bgreig/TinkerSub/Source/README.md

# TinkerSub KB-1: source

Everything generated in this repository comes from the Python in this folder: the printed parts (`STL/`), the Bambu Studio projects (`*.3mf`), the side-plate templates and DXFs (`CAD/`), the STEP files, the pictures and the build guide. The CAD is code: change a number, rebuild, and every file downstream follows.

You don't need any of this to build the ROV. You need it to change the design.

## Quick start

```
pip install -r Source/requirements.txt
playwright install chromium            # for the renders and schematics
python3 Source/build.py all            # about 10 minutes; add --step for the STEP files (slow)
python3 Source/build.py install        # copy what changed into the repository
```

`all` ends with a check that compares every generated file with the one in the repository and lists what changed. Nothing in the repository is touched until you run `install`, and `install` only writes files that really changed (a 3MF whose only difference is its object IDs and date is left alone). Everything is built in `Source/build/` (git-ignored).

Tested with Python 3.13 on Linux.

## The build steps

`python3 Source/build.py <step> [<step> ...]` runs one or more steps; `all` runs them in this order. Each step uses what the steps before it wrote in the build folder.

| Step | What it does | Main output |
|---|---|---|
| `parts` | Generates every printed part, assembles the whole ROV (and reports any interference between parts), names, numbers and labels the parts, then runs the fastener check | `out_lbl/<PN>_<name>.stl`: the files in `STL/` |
| `fasteners` | Follows every screw hole in the assembled ROV through every part and checks it against `assembly/fasteners.py` (below). Any error stops the build | `fastener_report.json`, `logs/fastener_check.log` |
| `plates` | HDPE side plates: DXFs, cutting templates, one-piece plate STLs | `out_final/`: the files in `CAD/` |
| `3mf` | Bambu Studio projects (Frame, Core, Reprint) and their plate maps | `outdir/` |
| `step` | STEP files for Fusion 360 and other CAD apps, and the positioned mesh assembly. Slow (the assembly is 146 MB): not part of `all` unless you add `--step` | `out_final/step/` |
| `figures` | Drawn figures: thruster layout, pan-tilt fit diagram, side-plate figures, the compensator section, the two schematic sheets, the wiring diagram and the wire list | `render/final/crop/`, `out/compensator_section.png` |
| `scenes` | 3D scenes for the renders: the assembly, the lights, the electronics sled, the heat-set insert map, single parts; and the interactive viewer's data (`guide/viewer_scene.py`: every part, the electronics and the cables) | `render/*.json`, `render/viewer/` |
| `renders` | Renders every view in `render/views/*.json` in headless Chromium | `render/final/crop/` |
| `guide` | Builds the guide PDF and the whole generated package | `outdir/TinkerSub_KB-1_Build_Package/` |
| `check` | Compares the package with the repository, file by file | a list: same / equivalent / changed / new |
| `install` | Copies changed and new files into the repository. Never deletes | |

The guide uses about 120 pictures. About 60 of them are regenerated by `figures` and `renders`. The rest are older renders whose camera setups no longer exist (most of the part thumbnails, the thruster, sled and pod pictures, the label close-ups in `Images/Labels/`). The `guide` step takes every picture it didn't regenerate from the repository's `Images/` folder, so you can rebuild the guide after a text change with:

```
python3 Source/build.py parts plates guide check
```

## Folders

| Folder | What's in it |
|---|---|
| `build.py` | The one entry point. Its docstring lists every step. |
| `geometry/` | The parts themselves. `thruster.py` (housing, duct, props, tail cone), `pylon.py`, `lights.py`, `rov_parts.py` (pod flanges and caps, sled bulkhead), `jbox.py` (junction box and lid), `pantilt_fit.py` (camera pan-tilt and its fit check), `rov_v5.py` (stations, brackets, belly pan, cowl, side plates, light aim). `frame_clamp.py`, `pvc.py`, `ring.py`, `bracket.py`, `mount.py` and `wiring.py` are earlier versions the current parts still build on. `rail_notch.py` cut the wire opening in the sled rails once; its output is in `inputs/`. |
| `assembly/` | `rov_v6.py` puts every part in place and checks for interference. `export_v4/5/6.py` write the parts in print orientation. `parts_final.py` is the master part list: part numbers, file names, print notes, labels. `fasteners.py` is every screw joint; `purchases.py` is everything to buy (fasteners counted from `fasteners.py`). `label_parts.py` + `engrave.py` deboss the part numbers. |
| `outputs/` | `make_3mf.py` (Bambu projects; plate layouts in `plates_*.json`, print profile in `ps.json`), `plate_preview.py` (plate maps), `plate_templates_final.py` and `plate_stl_final.py` (side plates), `make_step.py` + `step_export.py` (STEP), `viewer_and_mesh.py` (mesh assembly). |
| `checks/` | `fastener_check.py` (with `holes.py`) checks every screw joint, run by the build. `print_review.py` checks every printed part for bed fit, loose columns, floating islands, overhangs and thin walls. `insert_walls.py` checks the plastic round every heat-set insert hole. |
| `guide/` | The guide (`build_guide.py` styles and helpers, `build_guide_final.py` all the text) and everything that makes its pictures: `scene_final.py`, `light_scene.py`, `elec_scene.py`, `part_scenes.py`, `insert_map.py` (scenes), `pantilt_fig.py`, `plate_figs.py`, `comp_fig.py`, `elec_drawings.py` (figures). `package_images.py` says where each picture lives in the package. |
| `render/` | `viewer.html` is the interactive 3D viewer (spin, explode, show/hide, click a part): serve it next to `build/render/viewer/*.json`. The renderer: `render.html` (parts and assembly), `render_ikea.html` (picture-by-picture pages), `render_real.html` (electronics), three.js, and the drivers `shoot.py` / `shoot_real.py`. `views/` holds the camera shots, one JSON file per kind of picture. |
| `inputs/` | Parts drawn in CAD rather than generated, read in as they are (below). |

## Inputs

| Folder | Contents |
|---|---|
| `inputs/rov_project/` | Hull flanges 201 / 203, dome ring 204 and the original rear end cap (STL + STEP, from `rov_br_style_caps.py`), the sled front bulkhead 207 (`camera_mount/`), and the reference parts the assembly loads |
| `inputs/New_parts/` | Sled rails, deck, rear bulkhead and battery plate (212-215, 305), drawn as CAD solids in the sled frame |
| `inputs/src_parts/` | Sled rails with the front wire opening cut, as used in the assembly |
| `inputs/prep/` | The same parts in print orientation with their labels engraved, plus the pan-tilt parts |
| `inputs/step_supplied/` | True CAD solids for 214, 215, 305 and 306, shipped as STEP files as drawn (the other parts' STEP files are converted from their meshes) |

## Where to change things

| To change | Edit |
|---|---|
| Stations, brackets, belly pan, cowl, side plates, light aim | `geometry/rov_v5.py` |
| Thruster body, duct, prop, tail cone | `geometry/thruster.py` |
| Pylon clamp | `geometry/pylon.py` |
| Light heads | `geometry/lights.py` |
| Pod flanges and caps | `geometry/rov_parts.py` |
| Camera pan-tilt | `geometry/pantilt_fit.py` (its `check()` sweeps the camera through its whole range inside the dome) |
| Junction box and lid | `geometry/jbox.py` |
| Part numbers, print notes, labels | `assembly/parts_final.py` |
| Any screw: size, length, how many | `assembly/fasteners.py` (the shopping list counts its screws from here) |
| Plate layouts in the 3MFs | `outputs/plates_*.json`; print settings in `outputs/make_3mf.py` |
| Guide text | `guide/build_guide_final.py` |
| Anything bought: size, quantity, price, source (the guide's shopping list, `Parts_to_buy.csv`) | `assembly/purchases.py` |
| A picture's camera angle | `render/views/*.json` |

## The fastener check

Every round hole of screw size in every printed part is placed in the assembled ROV and followed along its axis through every part on that line. For each joint it works out where the head goes, where the thread is, the grip, and the screw lengths that would hold without bottoming out, and checks there is room for the head, the nut and a hex key. Then it compares the model with `assembly/fasteners.py`, the table of every screw in the ROV:

- **BLIND / COVERED**: a screw can't get in (a clearance hole that stops in plastic, an insert that opens against another part). This is the 2026-10-22 belly pan bug.
- **UNMATED**: a hole that lines up with nothing. This is how a misaligned hole shows up (the top-arm inserts were 0.75 mm off the plate holes). Holes for bought parts that aren't in the model are listed in `NOT_JOINTS` with the reason.
- **LENGTH / ROOM**: the screw in the table is too short, too long, or its head or nut doesn't fit.
- **UNDECLARED / COUNT**: a joint the table doesn't know, or a different number of them.
- **GUIDE TEXT**: the guide names a screw size the table doesn't have. (The shopping list counts its screws, nuts and inserts from this table, so it can't disagree.)

To change a screw, change `assembly/fasteners.py` and rebuild: the report gives the lengths that fit each joint.

## Running one script on its own

The scripts import each other by name, so put the code folders on the path and run from the build folder, for example:

```
cd Source/build
PYTHONPATH=../geometry:../assembly:../outputs:../checks:../guide python3 ../checks/print_review.py out_lbl report.json
```

## License

MIT (see `LICENSE`). The parts these scripts make are covered by the hardware license, CERN-OHL-S-2.0, at the top of the repository.
