bgreig/TinkerSub/CAD/rov_side_plate_templates_fullsize_24x18.pdf

TinkerSub KB-1 side plate 901 PORT - full size, seen from OUTSIDE, front of the ROV to the left

Print on 24 x 18 in (ARCH C) paper at 100 % / Actual size, no scaling. Check both bars below before you cut: 200 mm and 8 in exactly.
Plate 478 x 300 mm, 1/2 in HDPE. Holes: 3.5 mm = M3, 4.5 mm = M4, 5.5 mm = M5. Centre-punch every crosshair; drill the blue starter holes before cutting the windows.

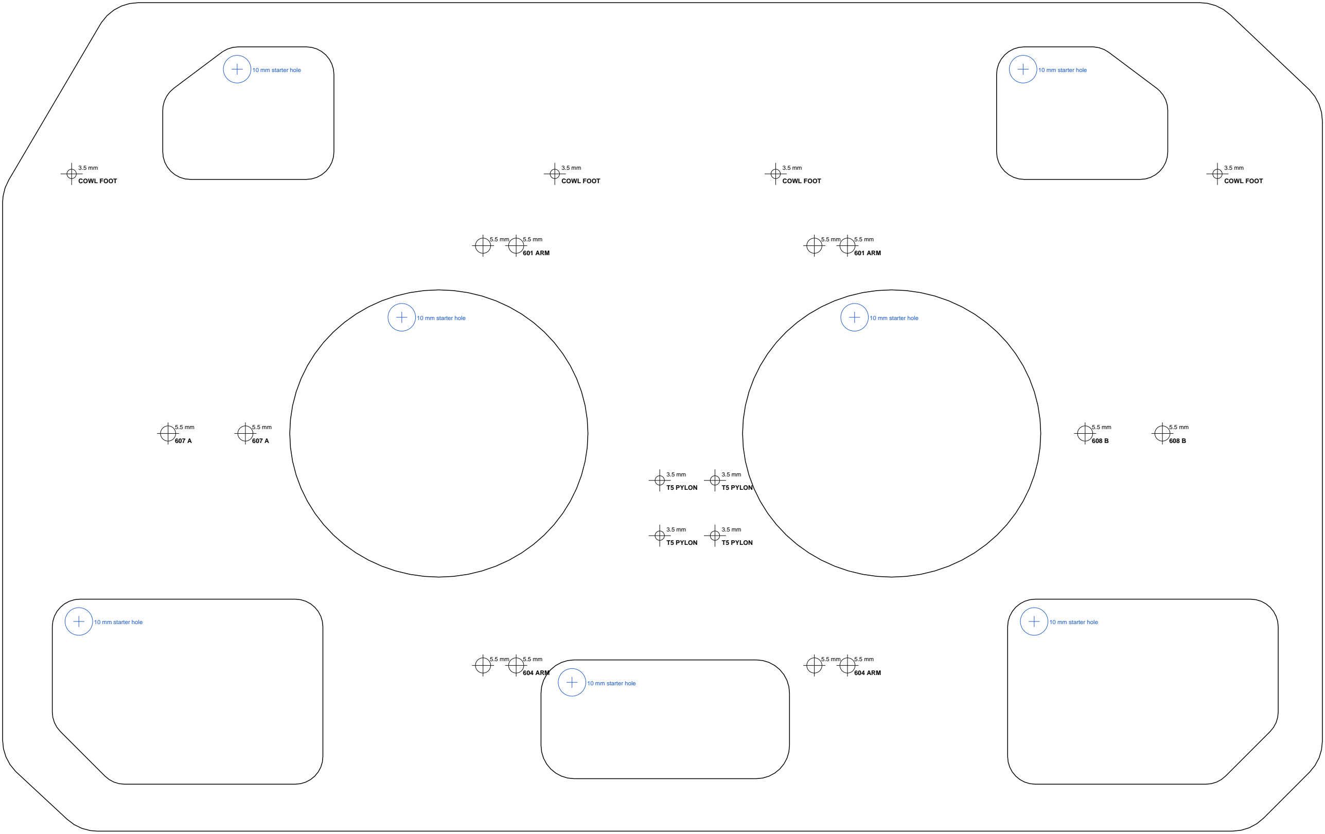
[picture p20: figure]
601 ARM; 604 ARM; T5 PYLON; COWL FOOT; 10 mm starter hole

200 mm

8 in

TinkerSub KB-1 side plate 902 STARBOARD - full size, seen from OUTSIDE, front of the ROV to the right

Print on 24 x 18 in (ARCH C) paper at 100 % / Actual size, no scaling. Check both bars below before you cut: 200 mm and 8 in exactly.
Plate 478 x 300 mm, 1/2 in HDPE. Holes: 3.5 mm = M3, 4.5 mm = M4, 5.5 mm = M5. Centre-punch every crosshair; drill the blue starter holes before cutting the windows.

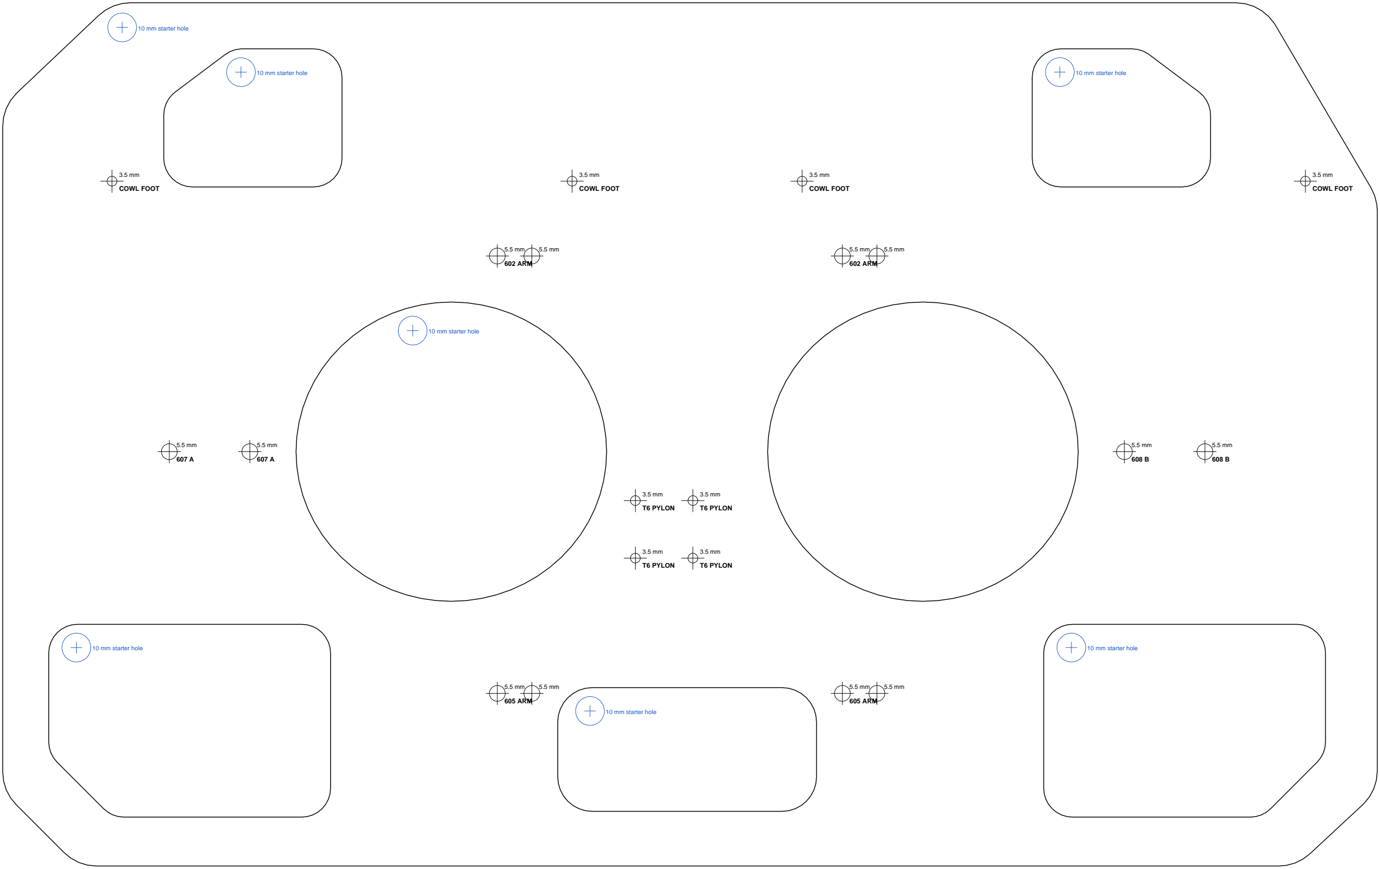
[picture p21: figure]
602 ARM; 605 ARM; T6 PYLON; COWL FOOT; 10 mm starter hole

200 mm

8 in
