bgreig/TinkerSub/CAD/rov_side_plates_both_24x36.pdf

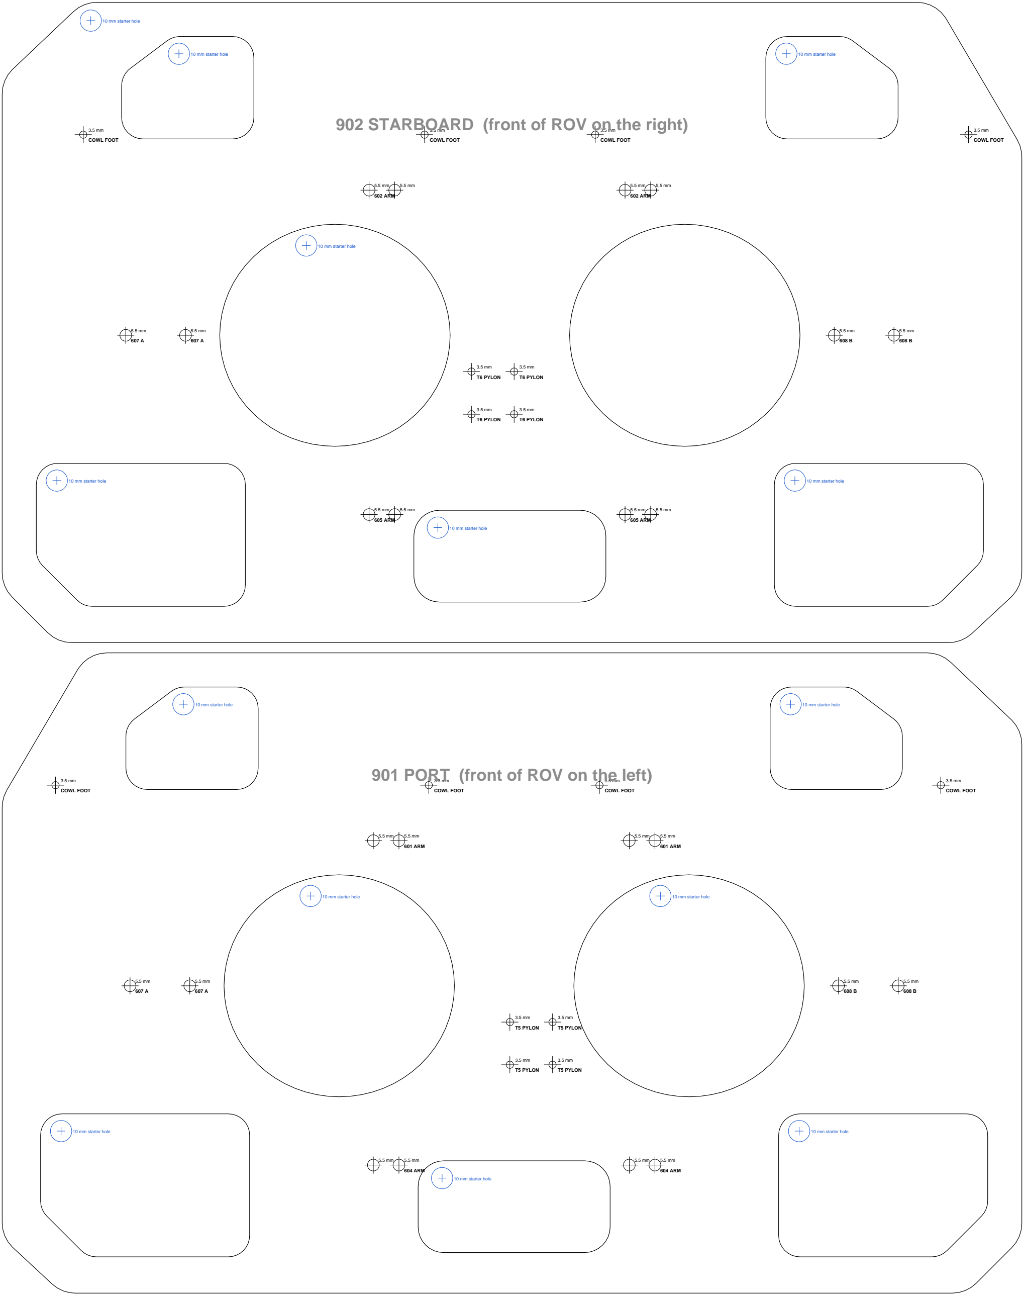
[picture p35: figure]
601 ARM; 604 ARM; T5 PYLON; COWL FOOT; 10 mm starter hole; 901 PORT (front of ROV on the left); 602 ARM; 605 ARM; T6 PYLON

# 902 STARBOARD (front of ROV on the right)

TinkerSub KB-1 side plates 901 + 902: full-size cutting template, both plates, 1/2 in HDPE

Print on 24 x 36 in (ARCH D) paper or a 24 in roll at 100 % / Actual size: no scaling, no 'fit to page'.
Before cutting anything, check both bars at the bottom: exactly 200 mm and exactly 8 in. Each plate outline must measure 478 x 300 mm.
Both plates are drawn outside face up, 4.8 mm apart, exactly as they sit on one 24 x 24 in HDPE sheet: trim the paper to about 2 mm
outside the two plates and glue the whole thing on (3M Super 77 or glue stick), plates centred left to right, ~2 mm from the top and bottom edges. Centre-punch every crosshair. Drill 3.5 mm (M3), 4.5 mm (M4), 5.5 mm (M5) as printed. Drill each blue 10 mm starter hole, then jigsaw the windows and outlines just outside the line, slow speed, fine blade. Mark 901 / 902 and the hole tags on the outside faces before peeling the paper off.

200 mm

8 in
