bgreig/TinkerSub/Images/Diagrams/compensator_section.png

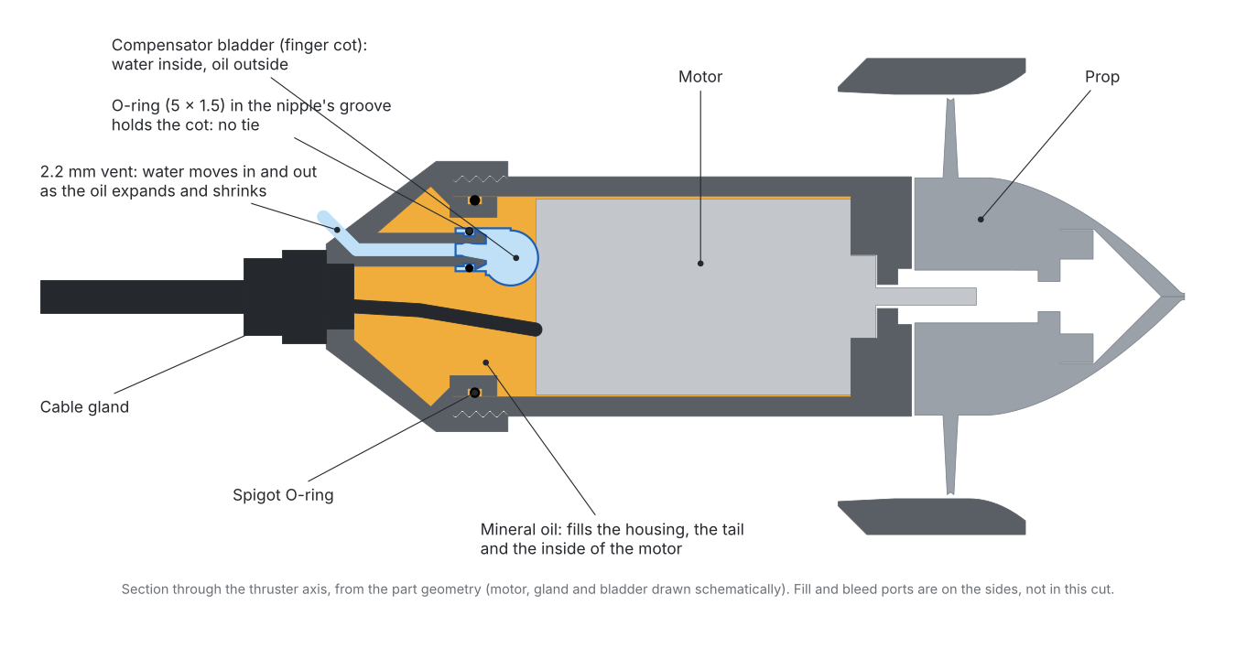
Images/Diagrams/compensator_section.png
