bgreig/TinkerSub/Images/Diagrams/prop_hex_section.png

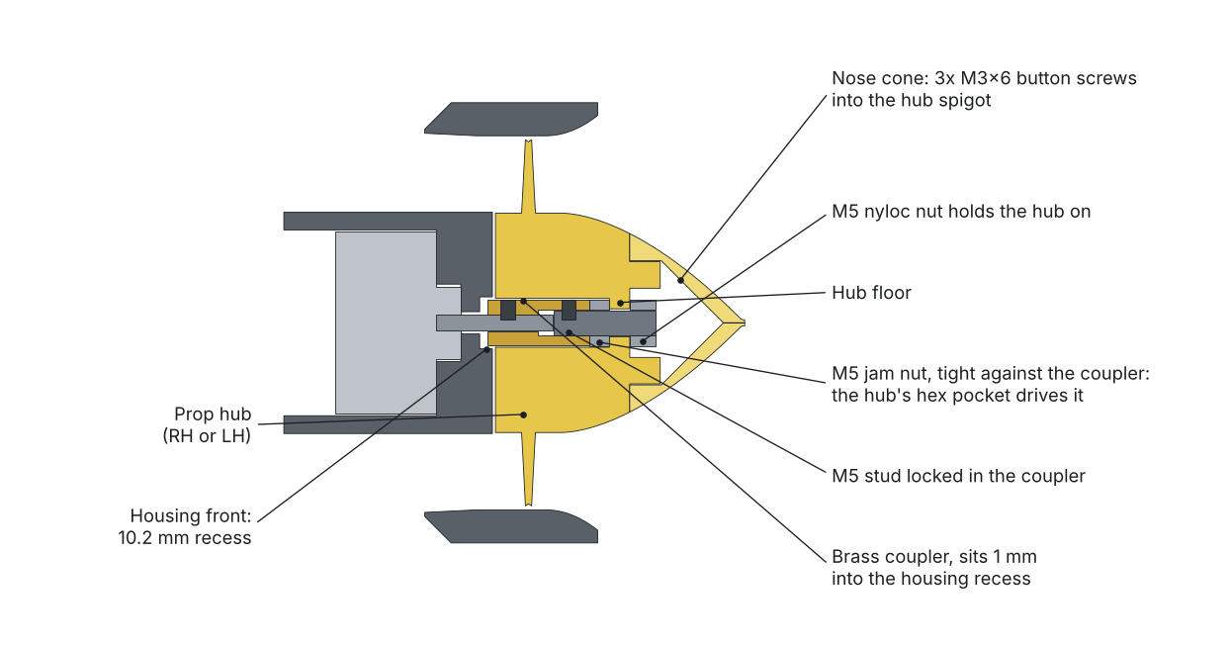
Images/Diagrams/prop_hex_section.png
