bgreig/TinkerSub/Images/Diagrams/side_plates_on_24x24_sheet.png

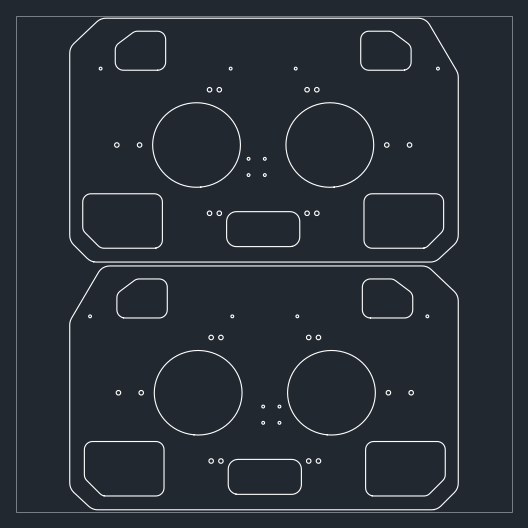
Images/Diagrams/side_plates_on_24x24_sheet.png
