bgreig/TinkerSub/Images/Diagrams/thruster_layout.png

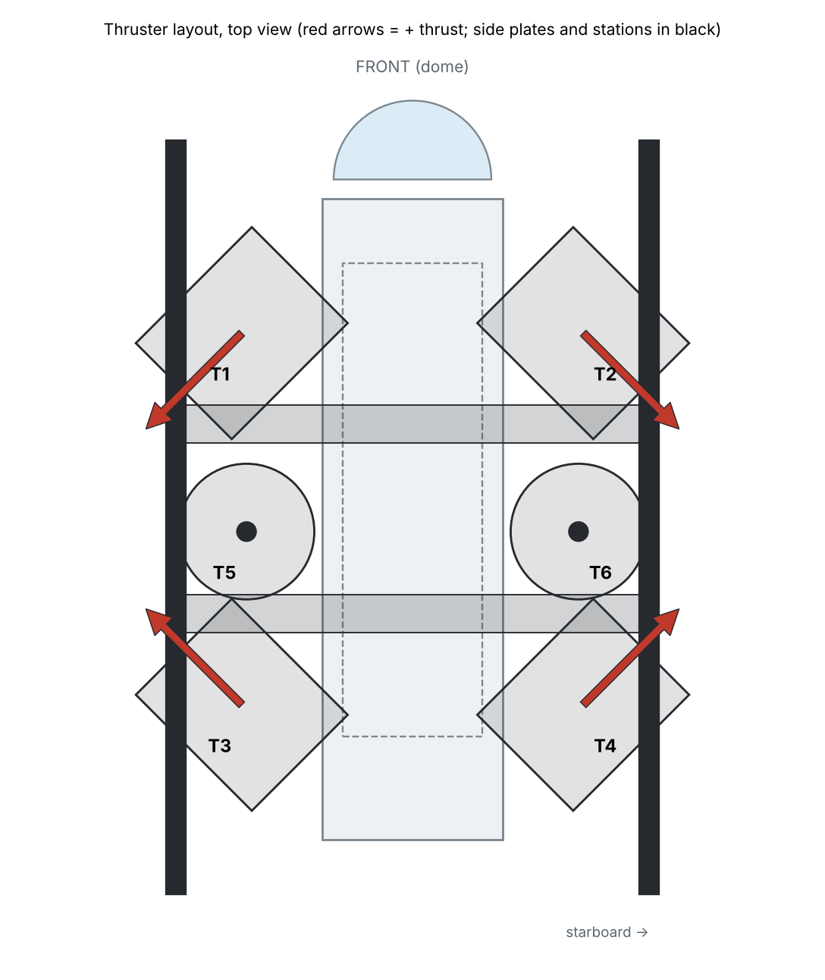
Images/Diagrams/thruster_layout.png
