bgreig/TinkerSub/Images/Diagrams/TinkerSub_KB-1_Core_plates.png

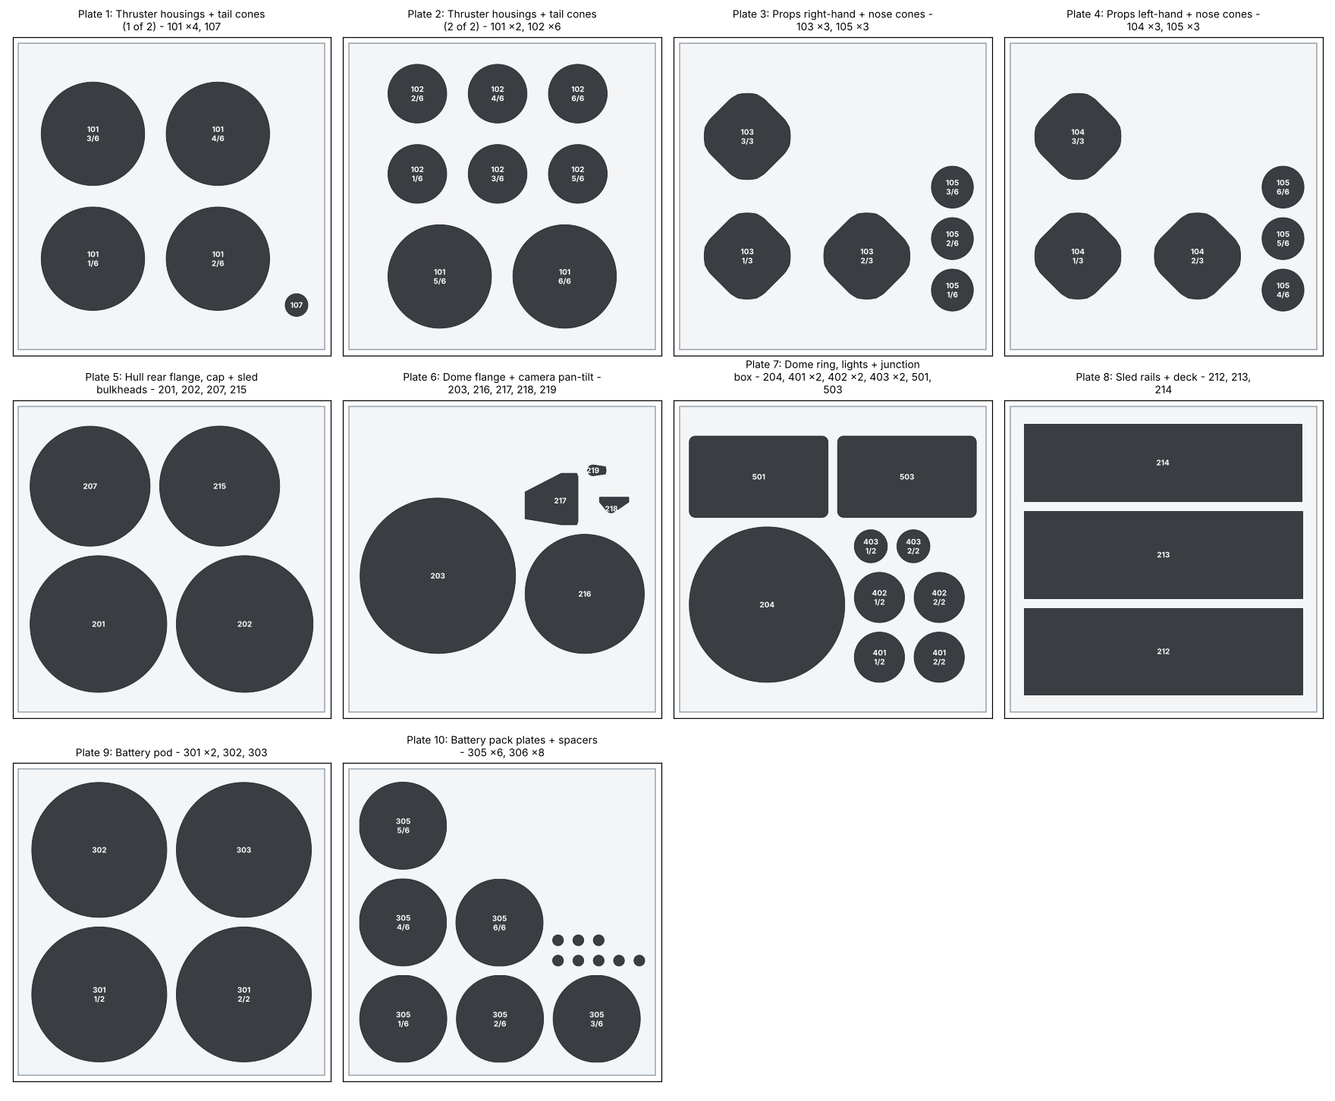
Images/Diagrams/TinkerSub_KB-1_Core_plates.png
