bgreig/TinkerSub/Images/Diagrams/TinkerSub_KB-1_Frame_plates.png

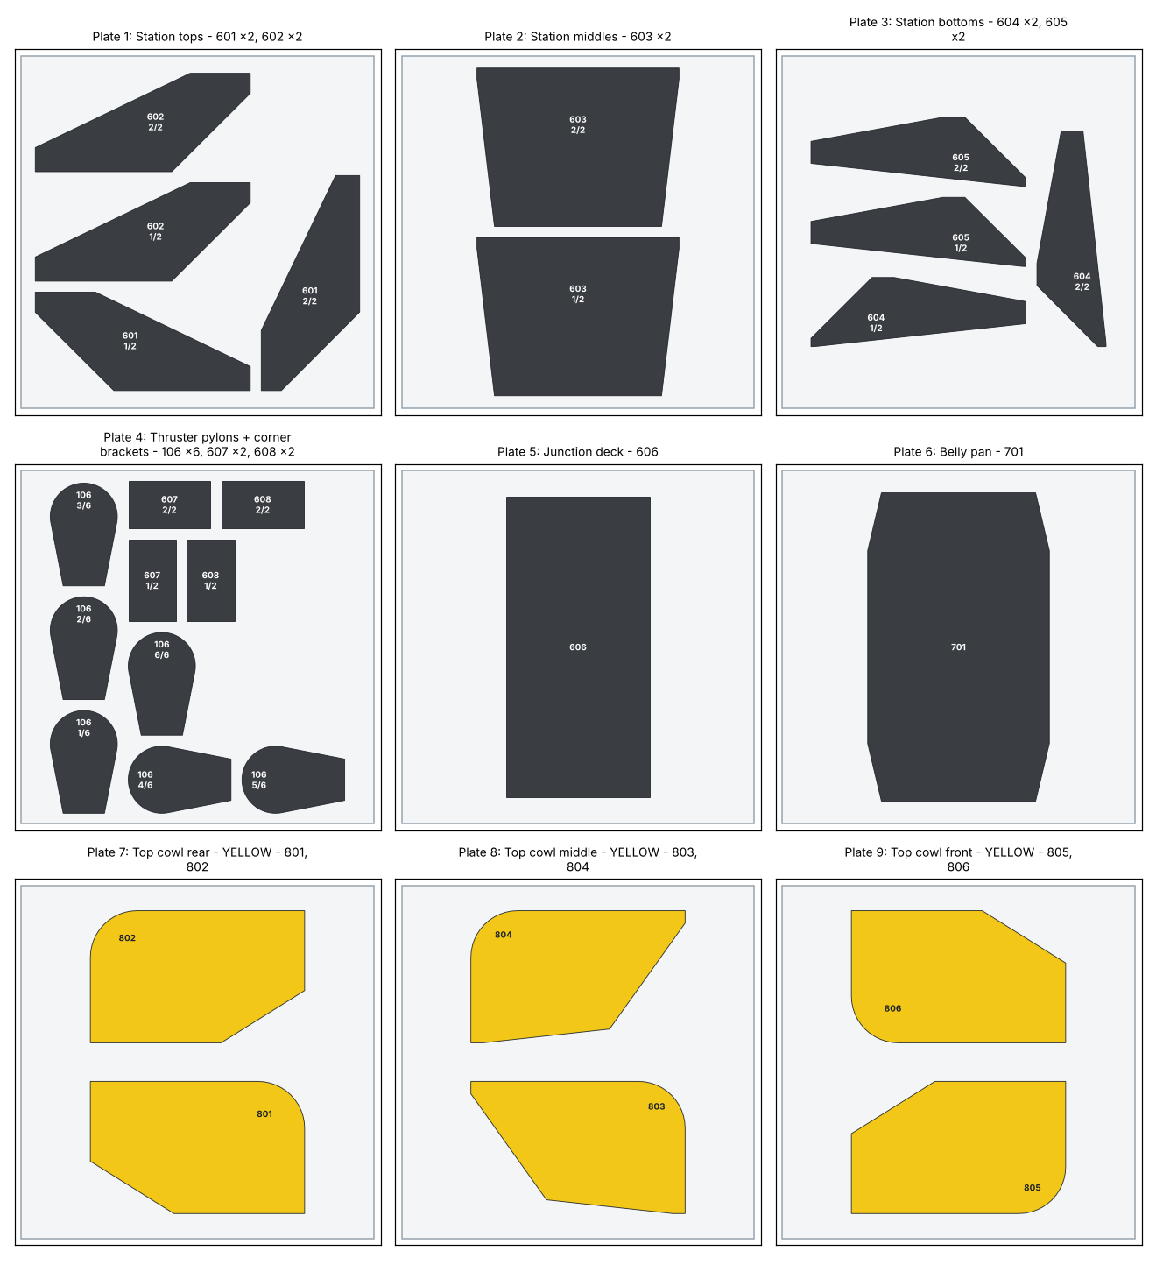
Images/Diagrams/TinkerSub_KB-1_Frame_plates.png
