bgreig/TinkerSub/Images/Electronics/harness_port.png

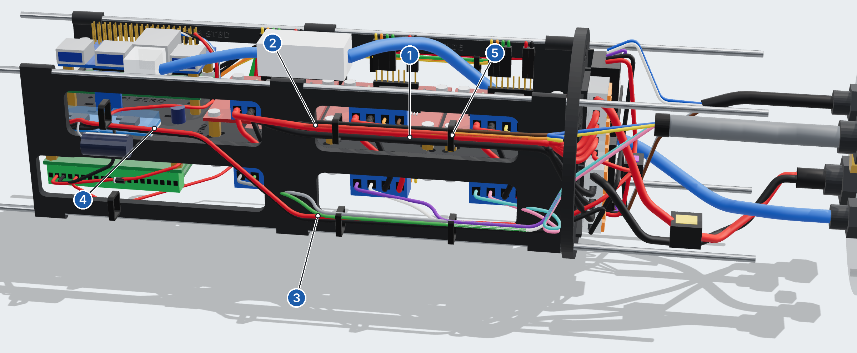
Images/Electronics/harness_port.png
