bgreig/TinkerSub/Images/Electronics/harness_starboard.png

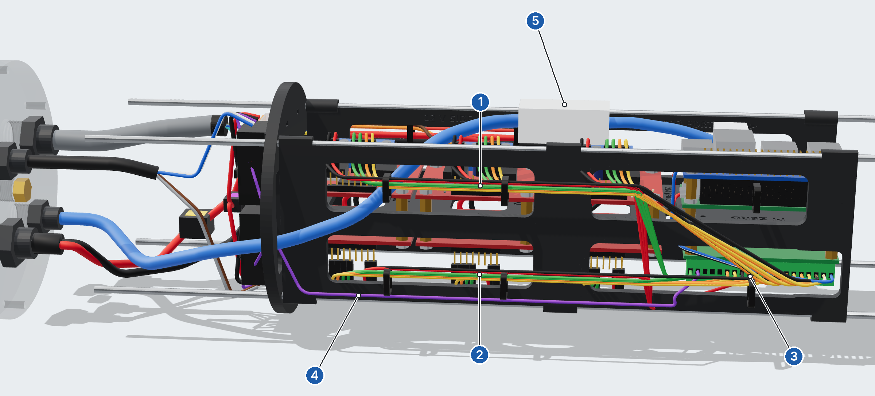
Images/Electronics/harness_starboard.png
