bgreig/TinkerSub/Images/Electronics/pin_map_pi_zero.png

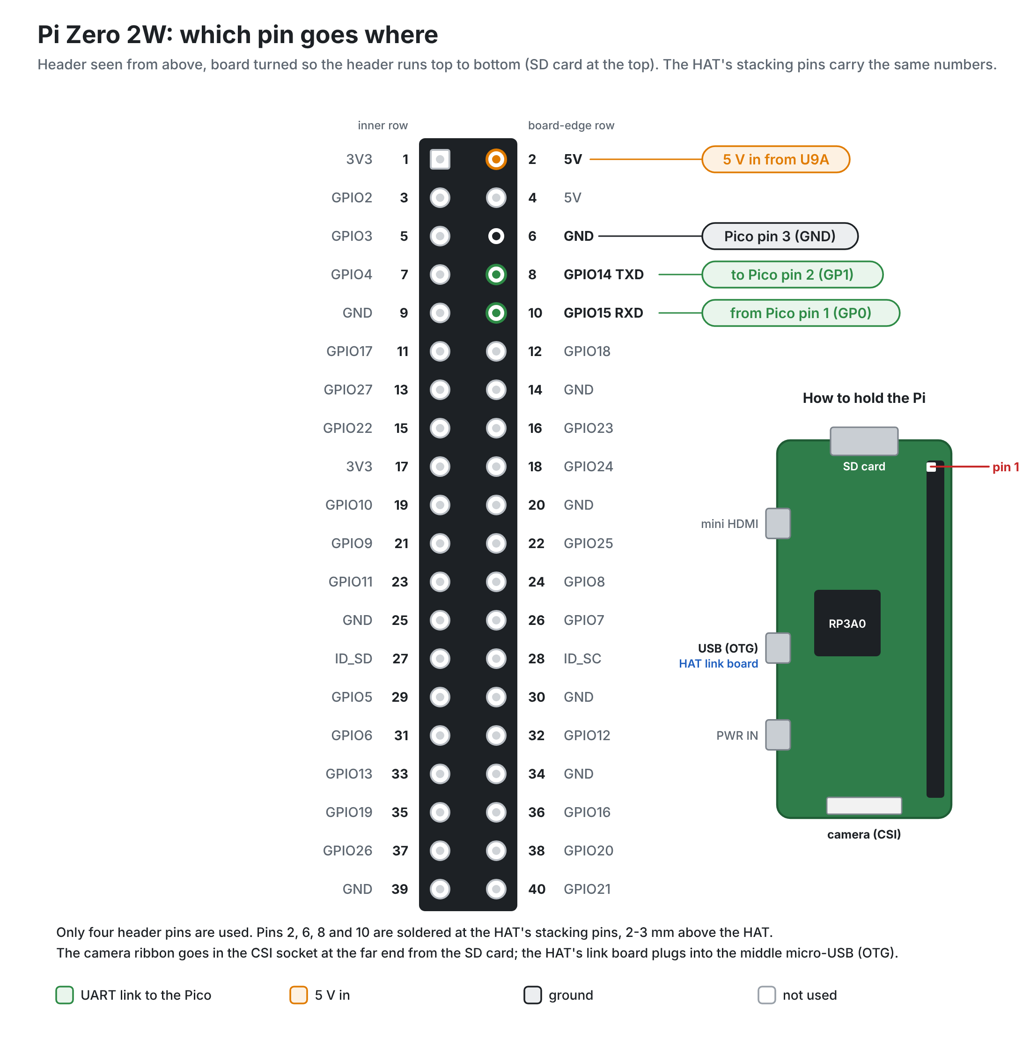
Images/Electronics/pin_map_pi_zero.png
