bgreig/TinkerSub/Images/Electronics/pin_map_pico.png

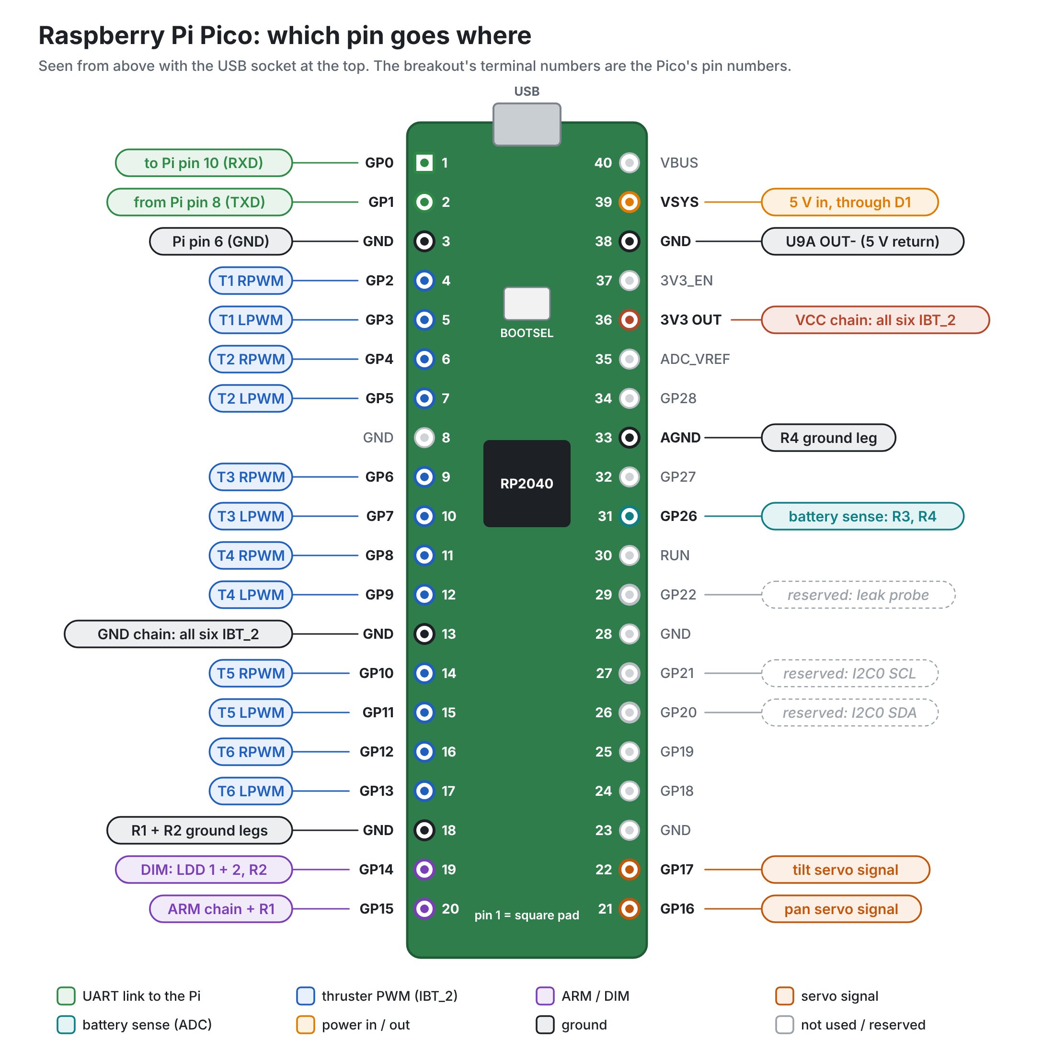
Images/Electronics/pin_map_pico.png
