bgreig/TinkerSub/Images/Electronics/rear_bay.png

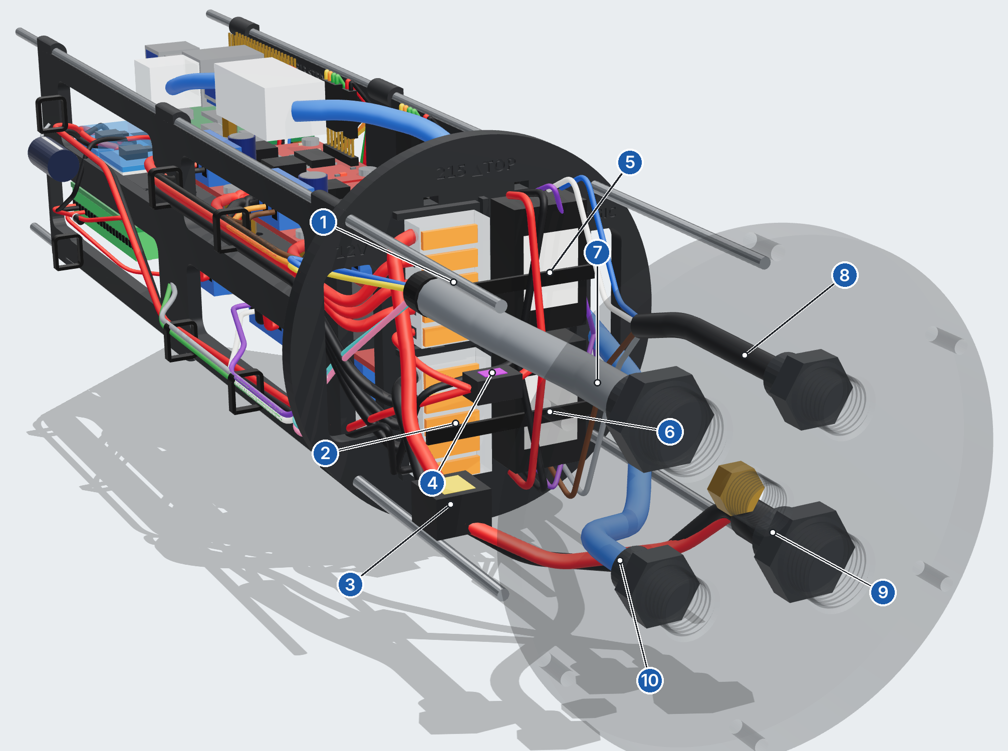
Images/Electronics/rear_bay.png
