bgreig/TinkerSub/Images/Electronics/schematic_1_power_and_drivers.png

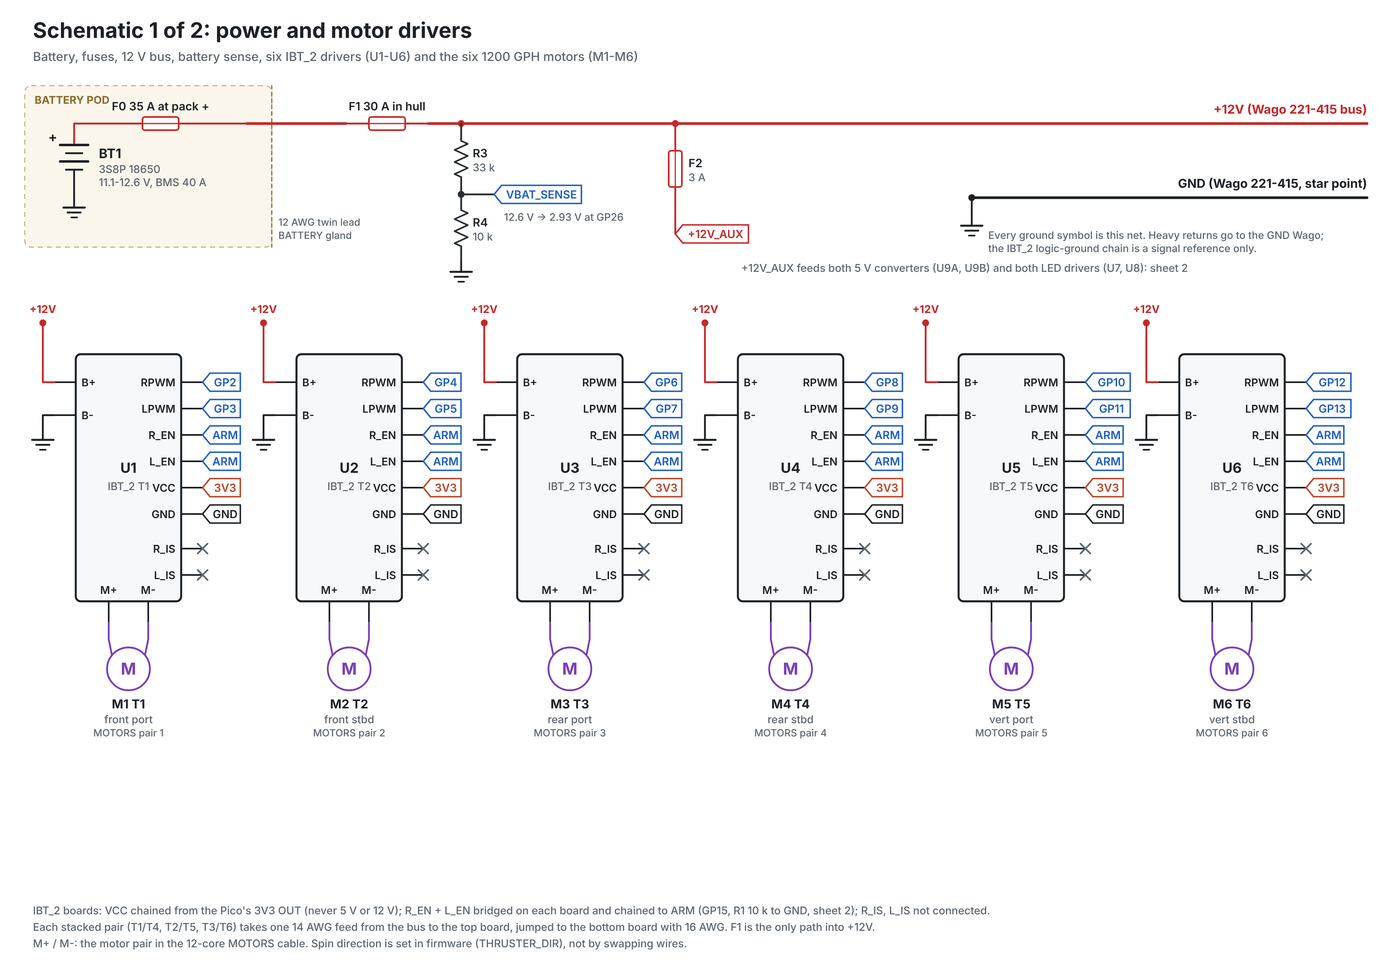
Images/Electronics/schematic_1_power_and_drivers.png
