bgreig/TinkerSub/Images/Electronics/schematic_2_control_and_lights.png

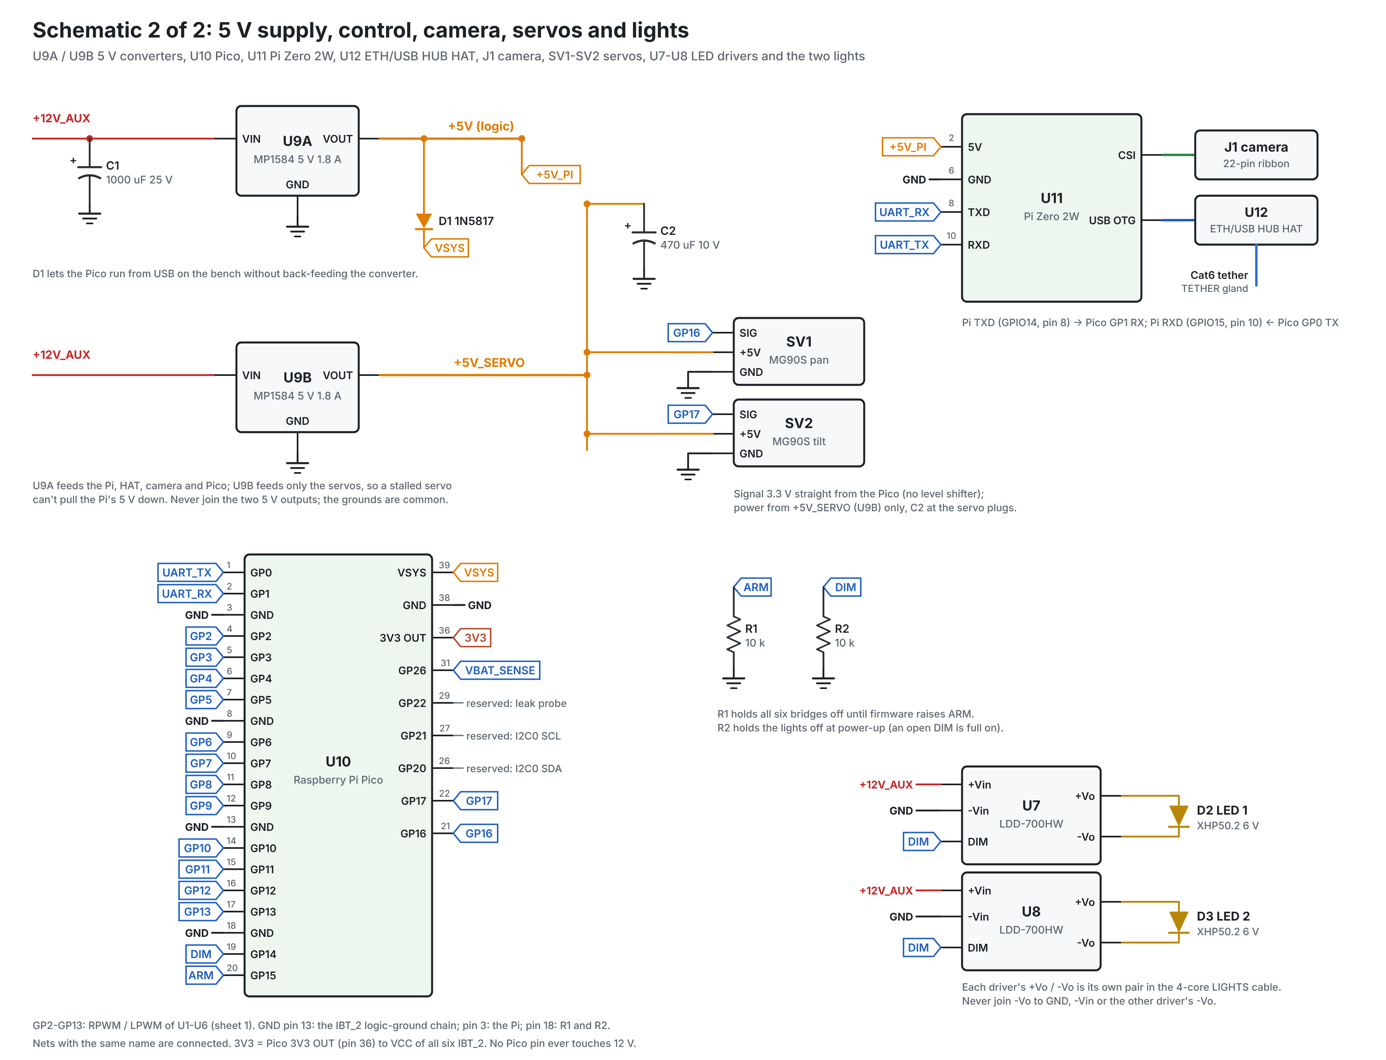
Images/Electronics/schematic_2_control_and_lights.png
