bgreig/TinkerSub/Images/Electronics/sled_bottom_face.png

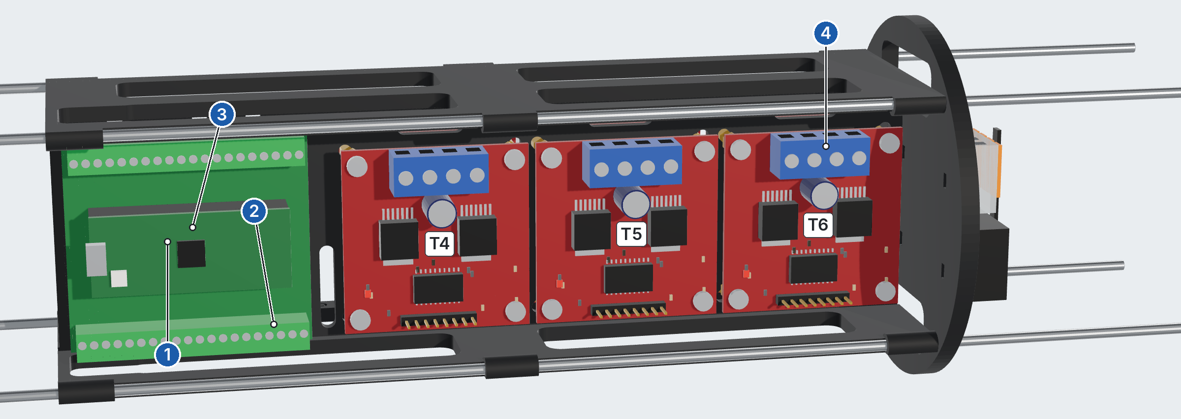
Images/Electronics/sled_bottom_face.png
