bgreig/TinkerSub/Images/Electronics/sled_in_hull.png

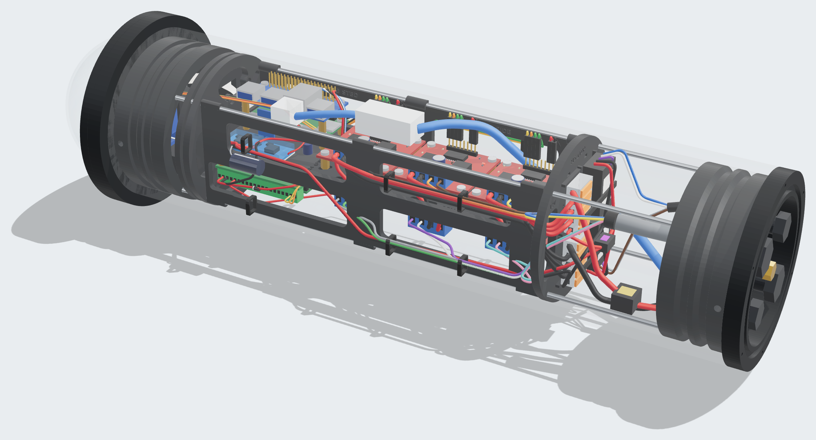
Images/Electronics/sled_in_hull.png
