bgreig/TinkerSub/Images/Electronics/sled_top_face.png

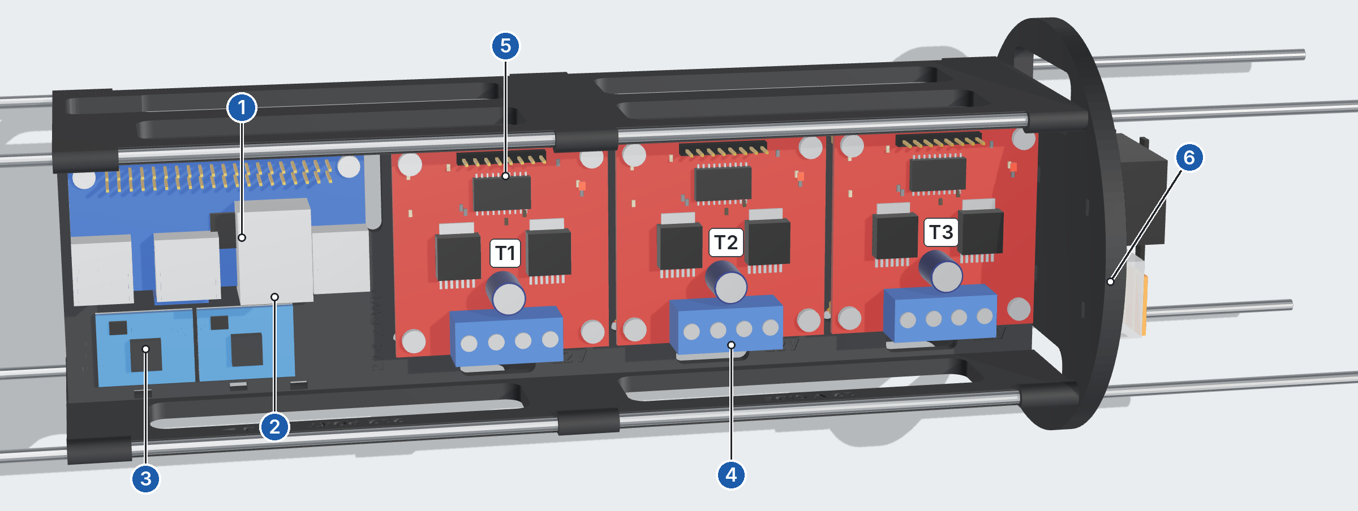
Images/Electronics/sled_top_face.png
