bgreig/TinkerSub/Images/Electronics/stacked_pair.png

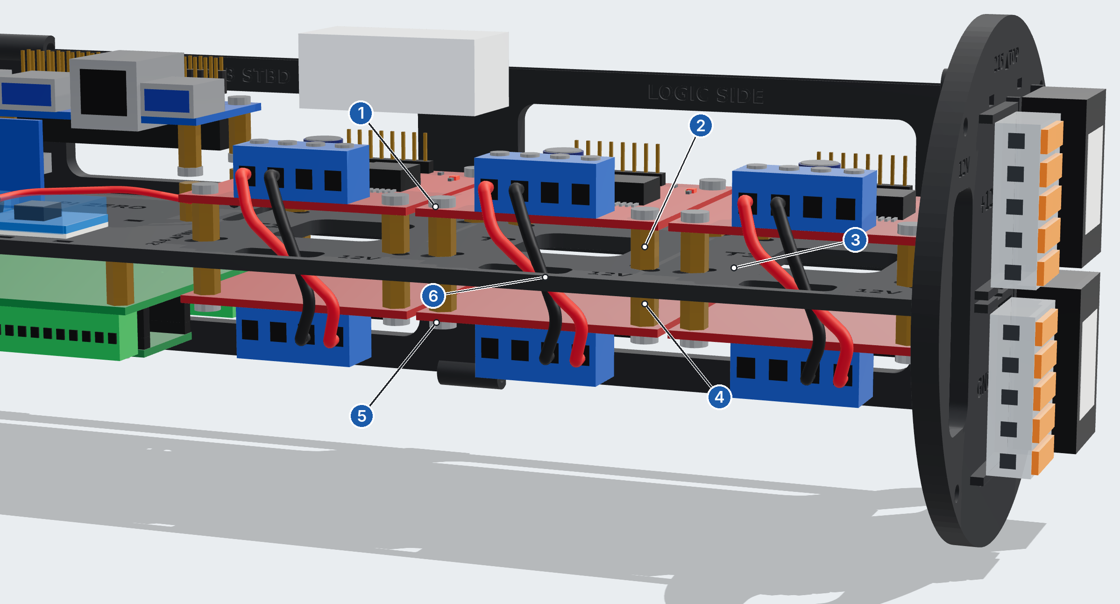
Images/Electronics/stacked_pair.png
