bgreig/TinkerSub/Images/Inserts/106.png

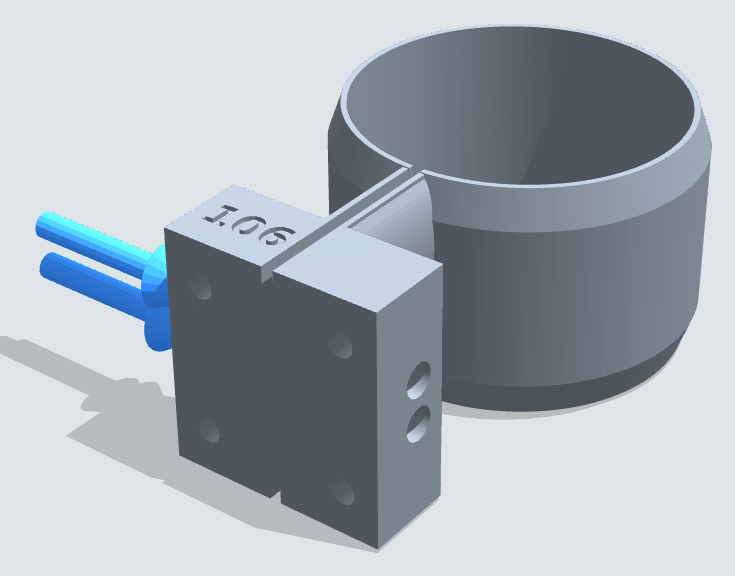
Images/Inserts/106.png
