bgreig/TinkerSub/Images/Inserts/201.png

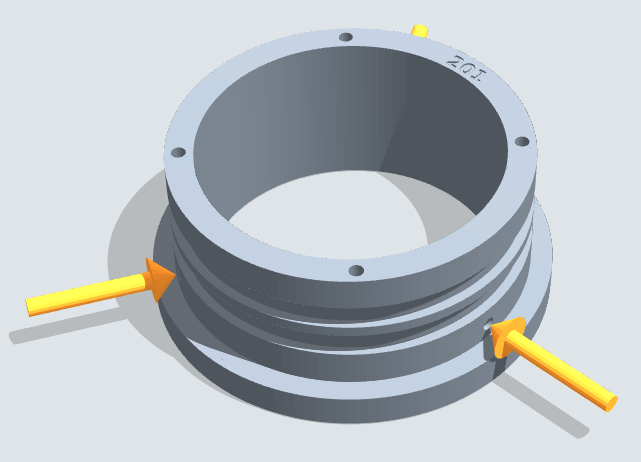
Images/Inserts/201.png
