bgreig/TinkerSub/Images/Inserts/203.png

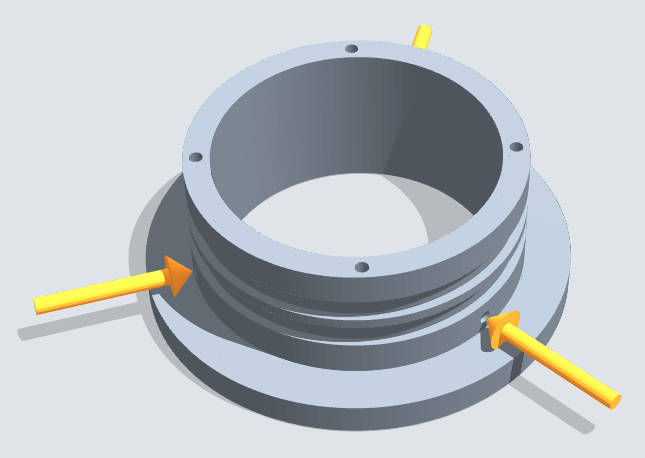
Images/Inserts/203.png
