bgreig/TinkerSub/Images/Inserts/301.png

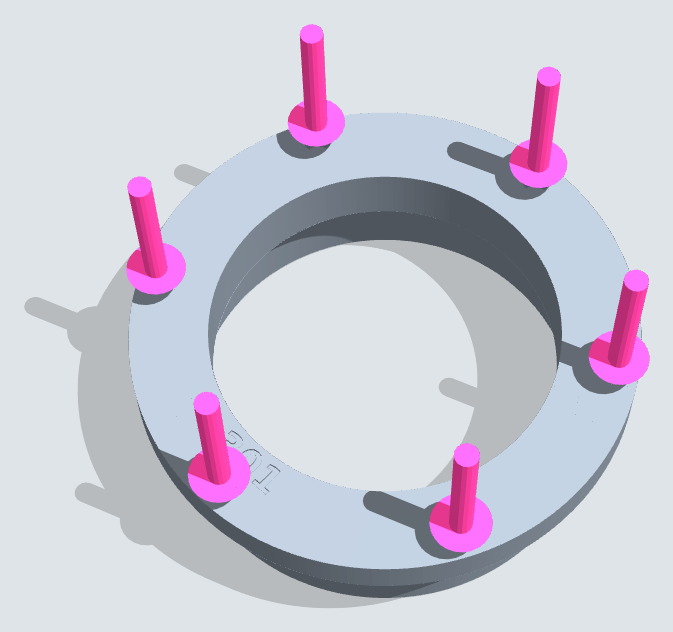
Images/Inserts/301.png
