bgreig/TinkerSub/Images/Inserts/501.png

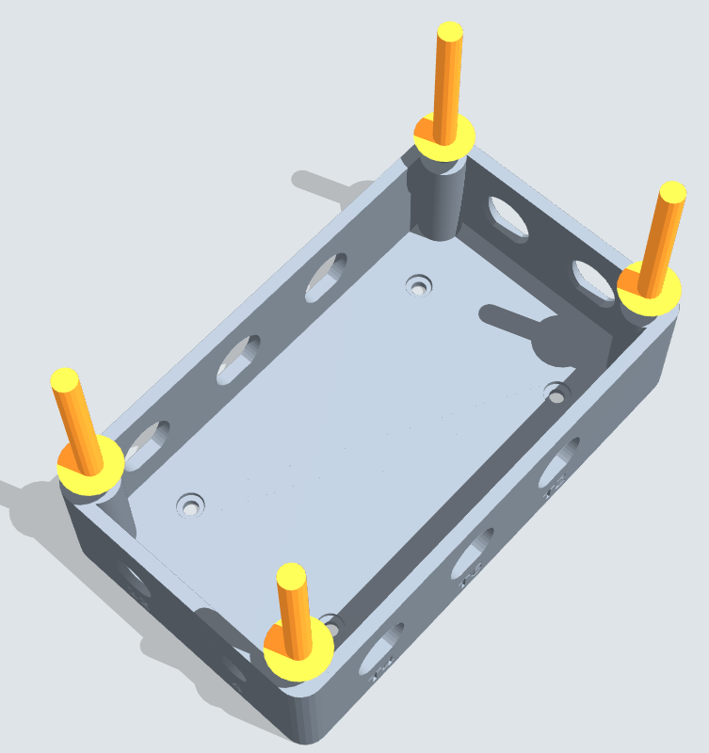
Images/Inserts/501.png
