bgreig/TinkerSub/Images/Inserts/601.png

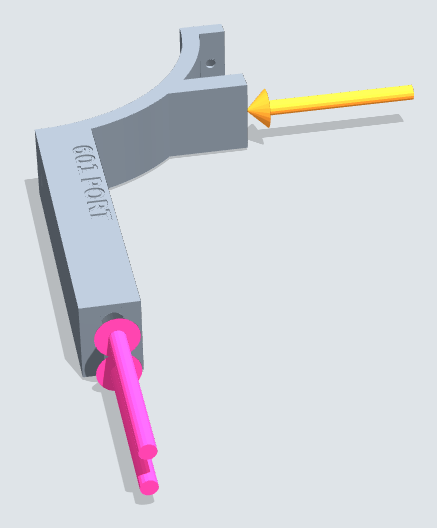
Images/Inserts/601.png
