bgreig/TinkerSub/Images/Inserts/602.png

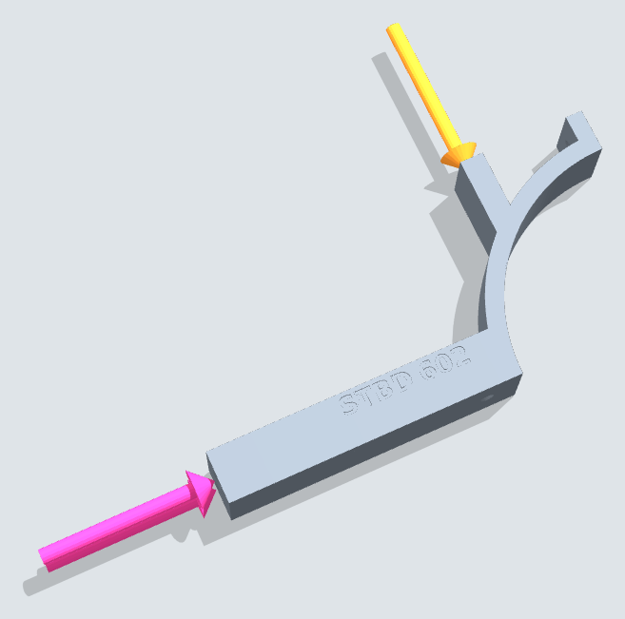
Images/Inserts/602.png
