bgreig/TinkerSub/Images/Inserts/604.png

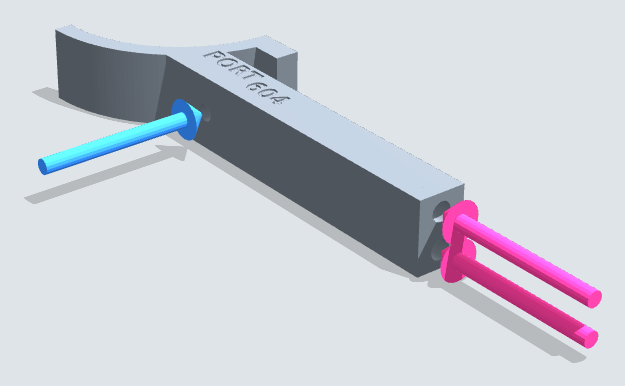
Images/Inserts/604.png
