bgreig/TinkerSub/Images/Inserts/605.png

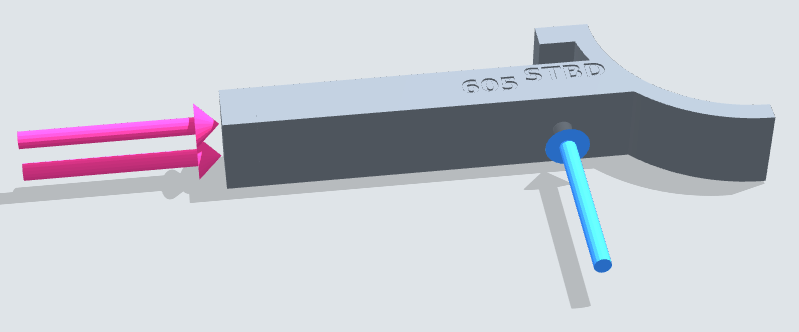
Images/Inserts/605.png
