bgreig/TinkerSub/Images/Inserts/606.png

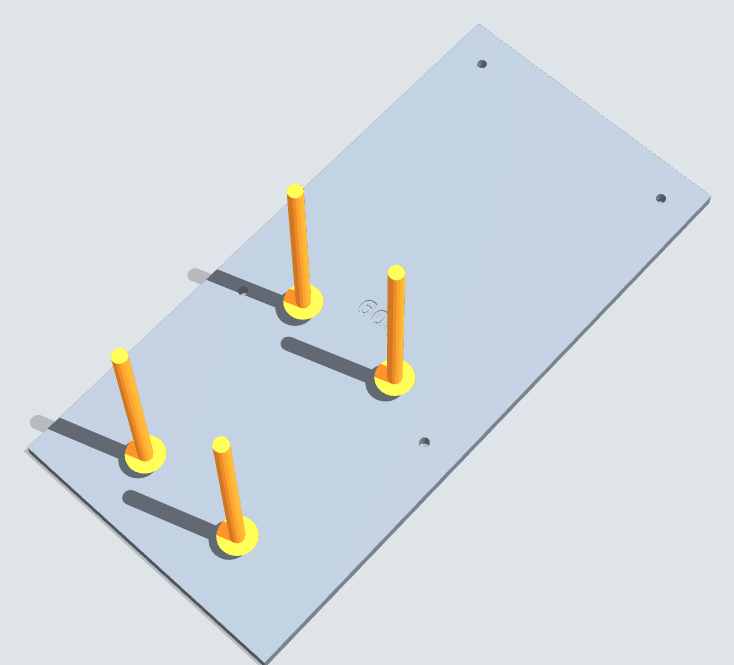
Images/Inserts/606.png
