bgreig/TinkerSub/Images/Inserts/607.png

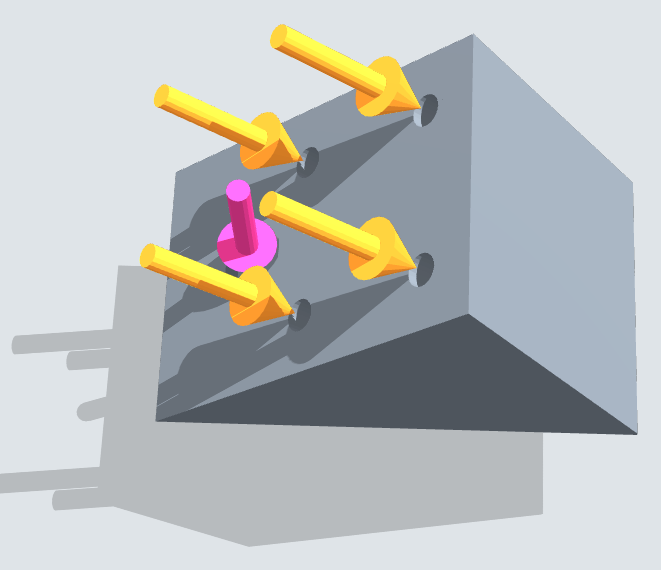
Images/Inserts/607.png
