bgreig/TinkerSub/Images/Inserts/608.png

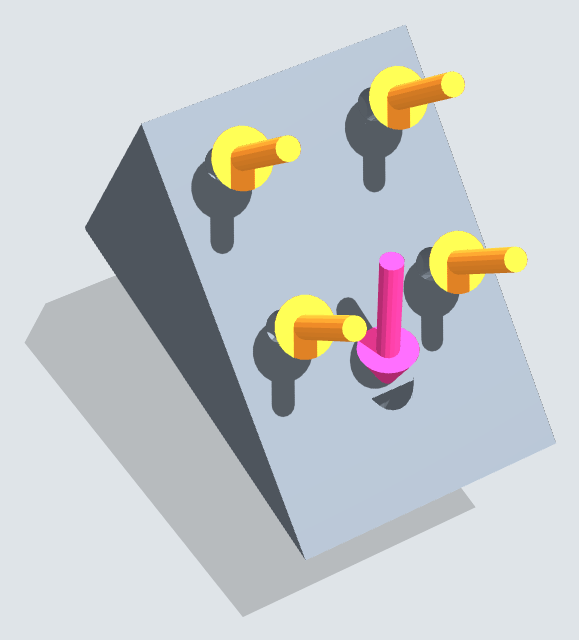
Images/Inserts/608.png
