bgreig/TinkerSub/Images/Inserts/801.png

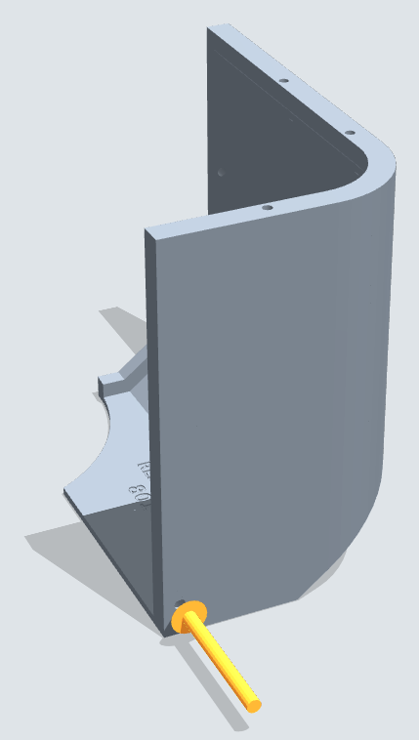
Images/Inserts/801.png
