bgreig/TinkerSub/Images/Inserts/802.png

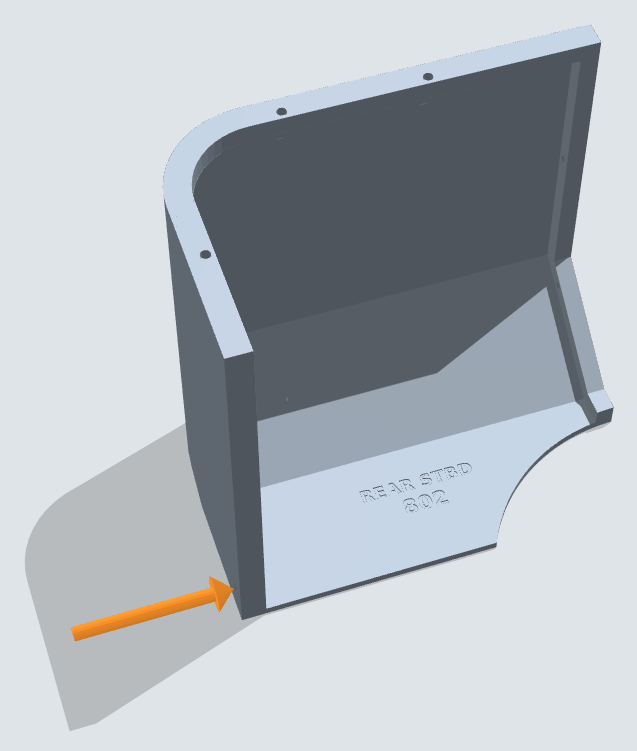
Images/Inserts/802.png
