bgreig/TinkerSub/Images/Inserts/803.png

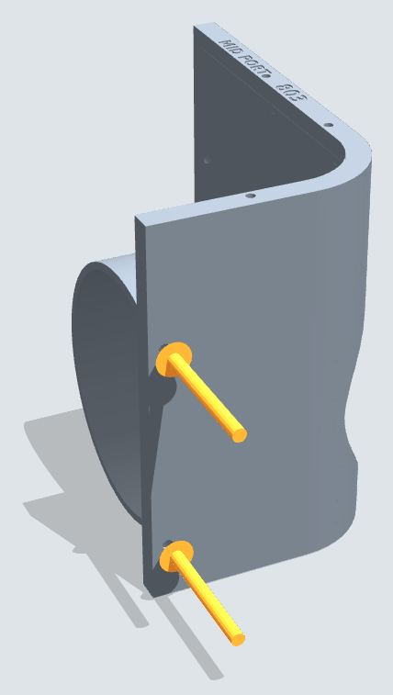
Images/Inserts/803.png
