bgreig/TinkerSub/Images/Inserts/804.png

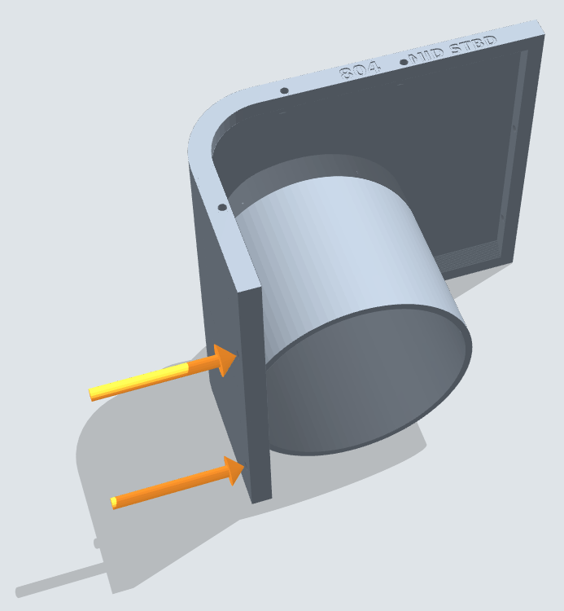
Images/Inserts/804.png
