bgreig/TinkerSub/Images/Inserts/805.png

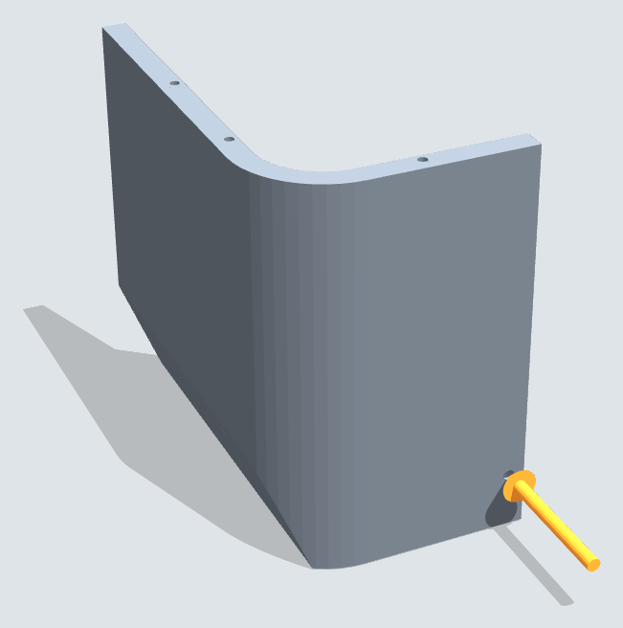
Images/Inserts/805.png
