bgreig/TinkerSub/Images/Inserts/806.png

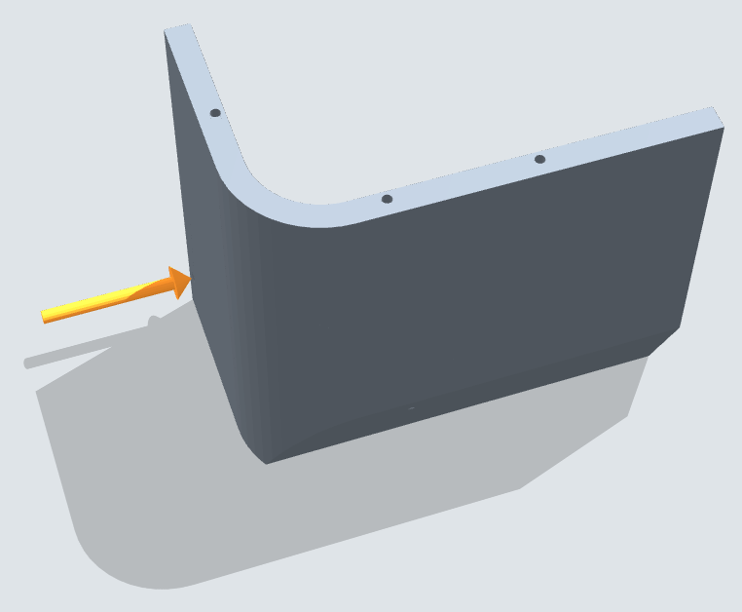
Images/Inserts/806.png
