bgreig/TinkerSub/Images/Labels/L_bh215.png

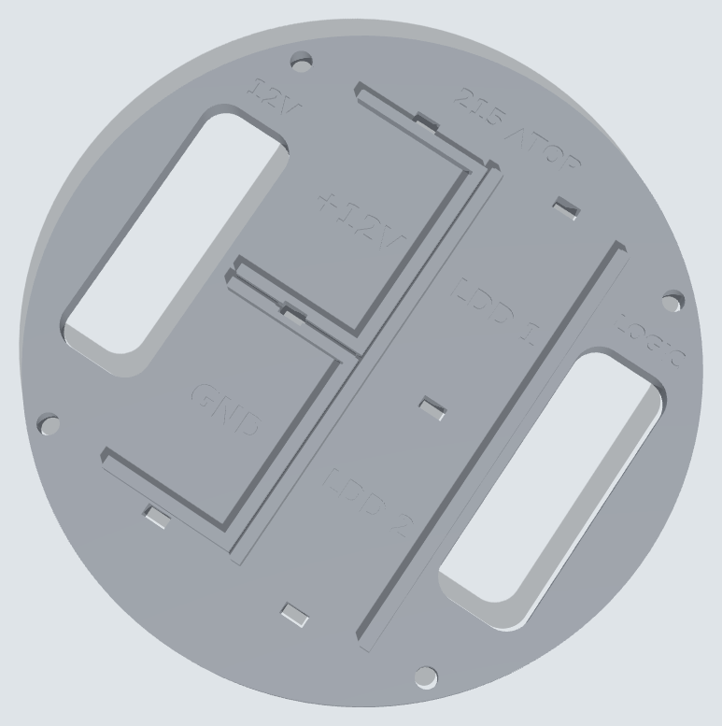
Images/Labels/L_bh215.png
