bgreig/TinkerSub/Images/Labels/L_deck214.png

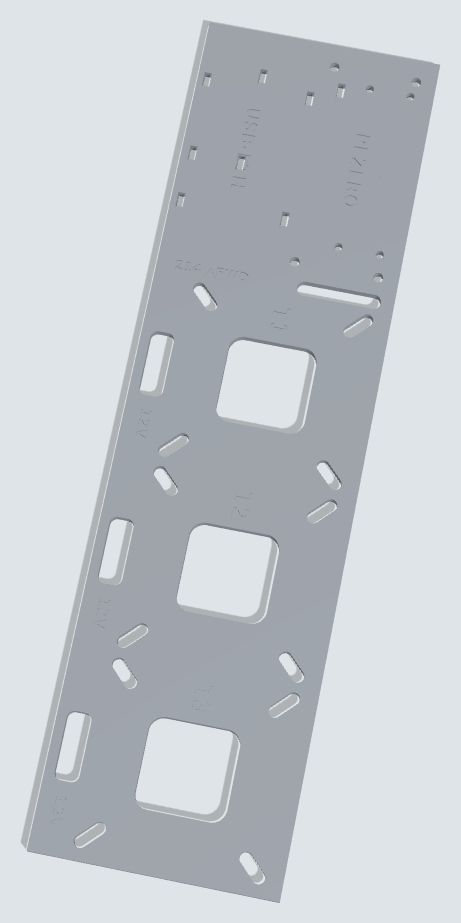
Images/Labels/L_deck214.png
