bgreig/TinkerSub/Images/Labels/L_deck.png

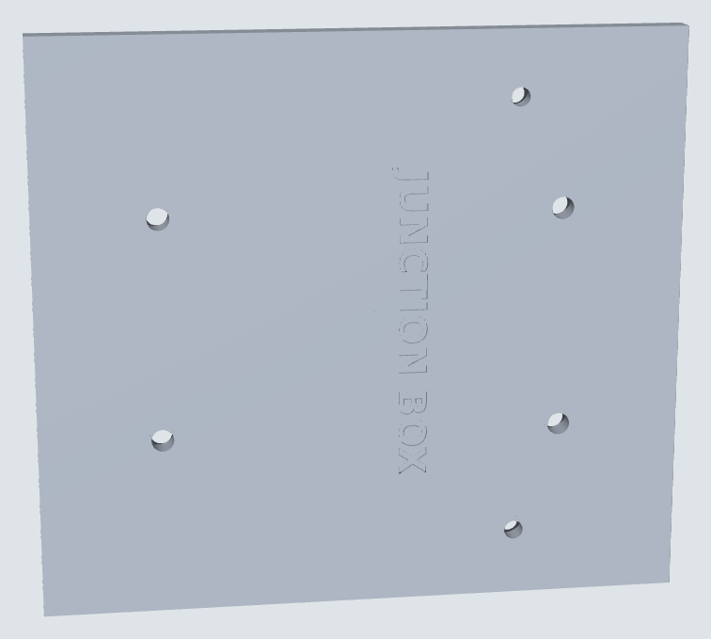
Images/Labels/L_deck.png
