bgreig/TinkerSub/Images/Labels/L_jbox.png

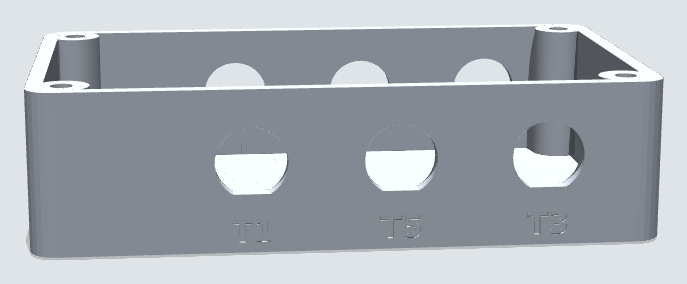
Images/Labels/L_jbox.png
