bgreig/TinkerSub/Images/Labels/L_rearcap.png

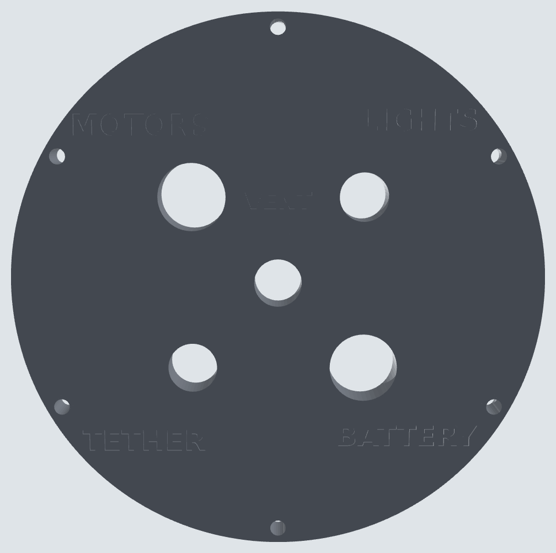
Images/Labels/L_rearcap.png
