bgreig/TinkerSub/Images/Labels/L_station.png

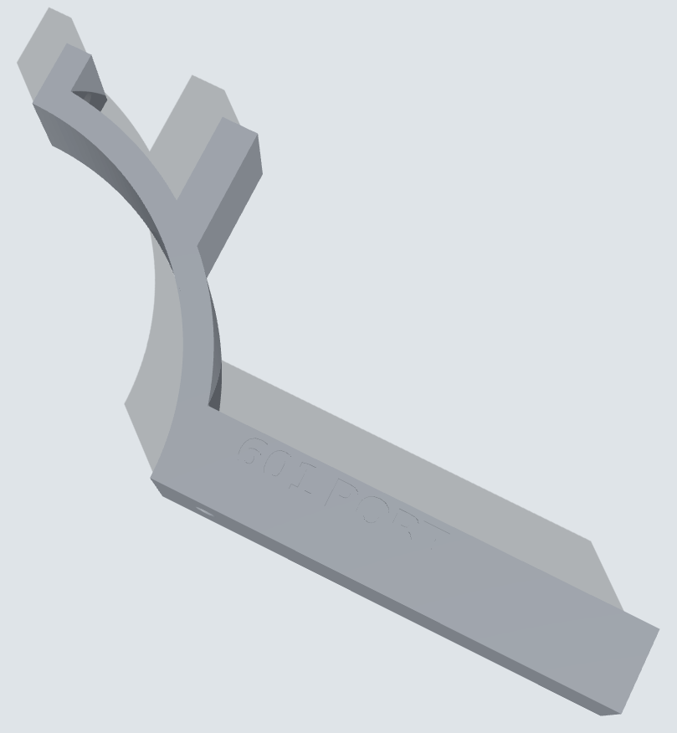
Images/Labels/L_station.png
