bgreig/TinkerSub/Images/Picture_by_picture/belly.png

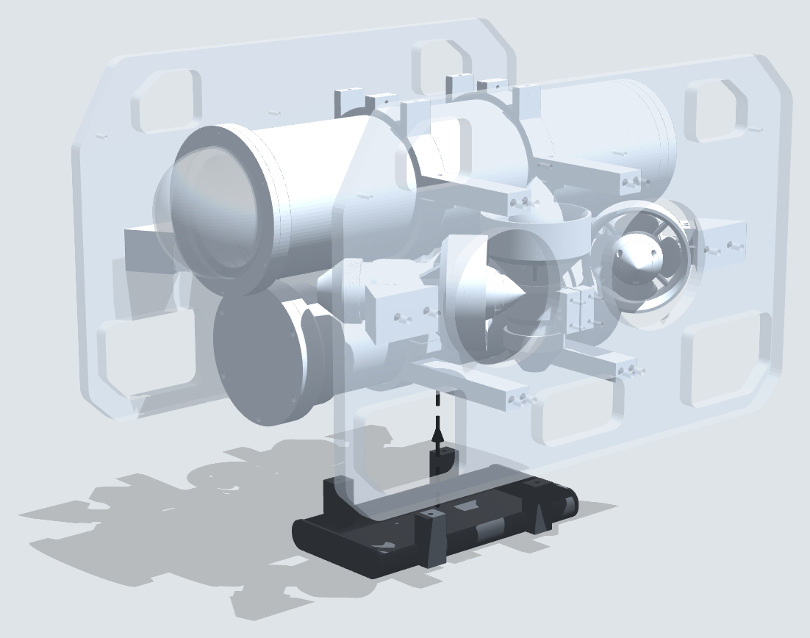
Images/Picture_by_picture/belly.png
