bgreig/TinkerSub/Images/Picture_by_picture/cowl.png

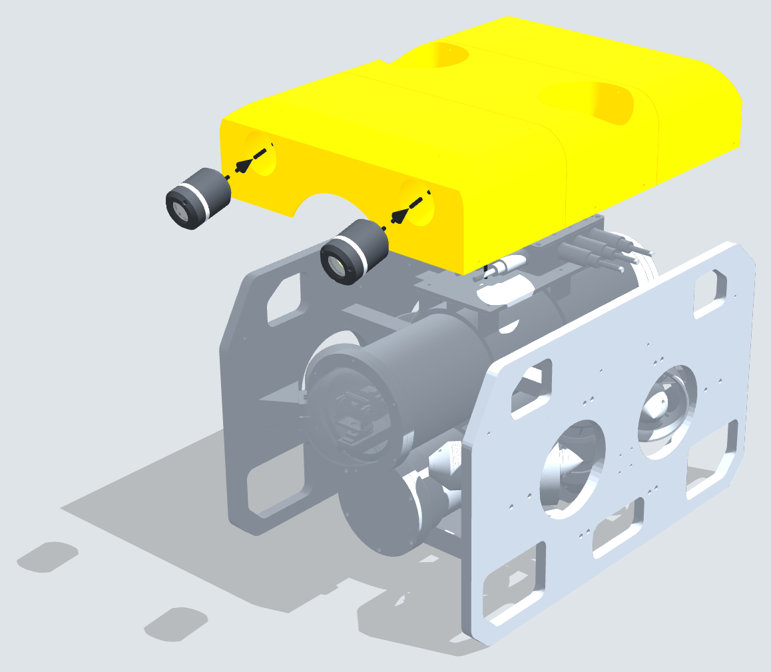
Images/Picture_by_picture/cowl.png
