bgreig/TinkerSub/Images/Picture_by_picture/hull.png

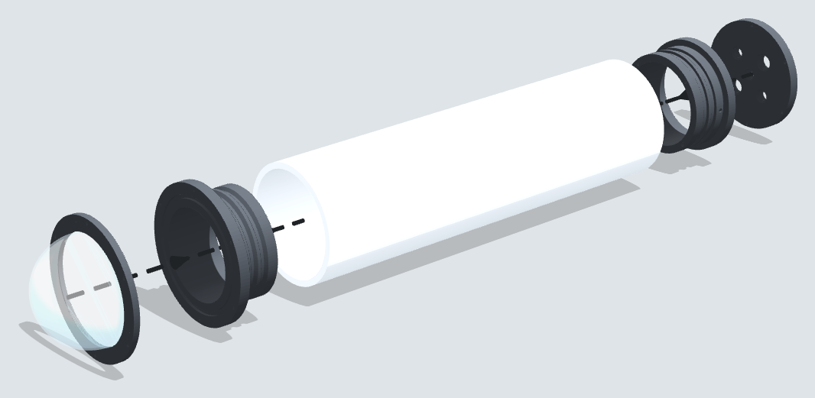
Images/Picture_by_picture/hull.png
