bgreig/TinkerSub/Images/Picture_by_picture/jbox.png

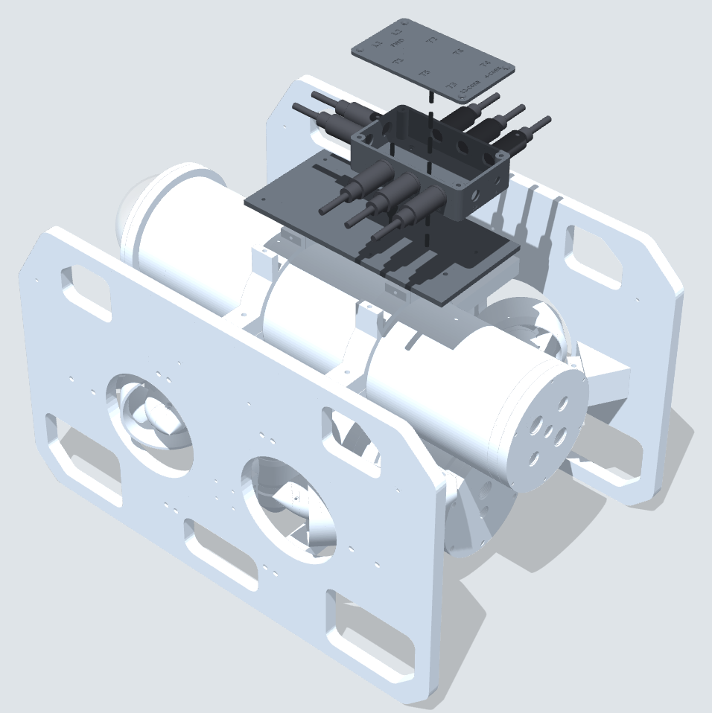
Images/Picture_by_picture/jbox.png
