bgreig/TinkerSub/Images/Picture_by_picture/pantilt.png

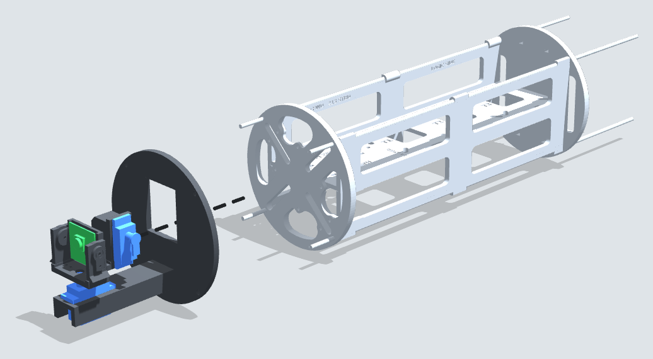
Images/Picture_by_picture/pantilt.png
