bgreig/TinkerSub/Images/Picture_by_picture/plates.png

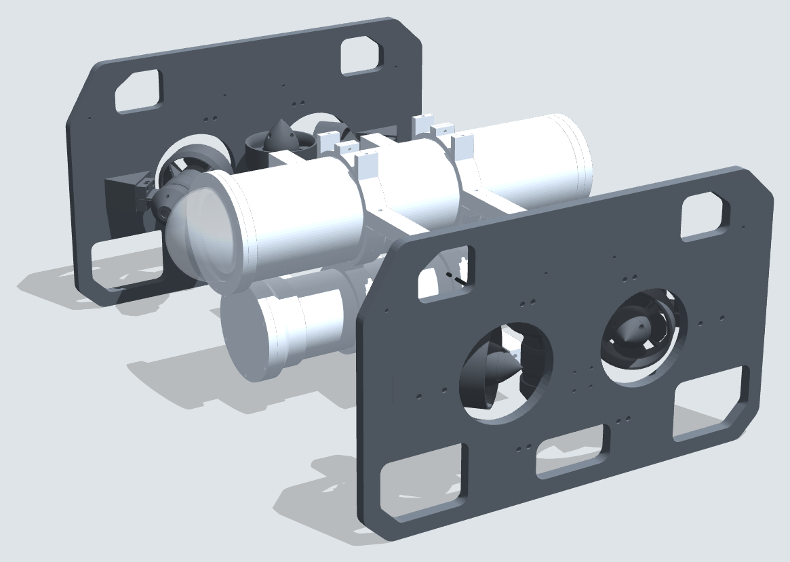
Images/Picture_by_picture/plates.png
