bgreig/TinkerSub/Images/Picture_by_picture/pod.png

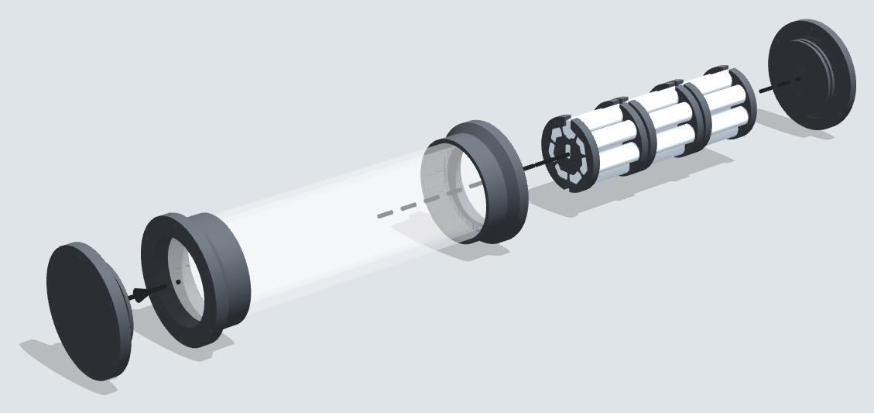
Images/Picture_by_picture/pod.png
