bgreig/TinkerSub/Images/Picture_by_picture/sled.png

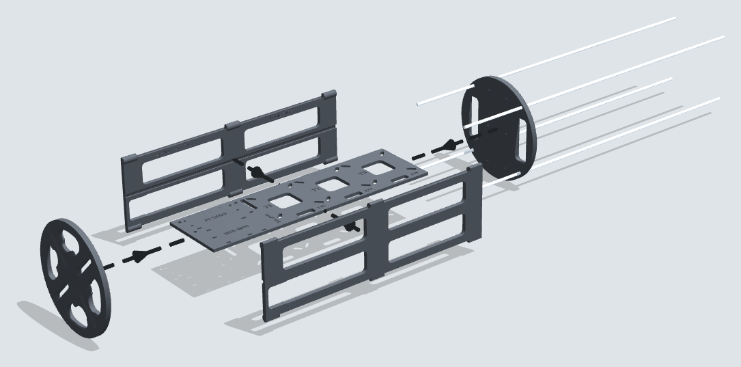
Images/Picture_by_picture/sled.png
