bgreig/TinkerSub/Images/Picture_by_picture/sledin.png

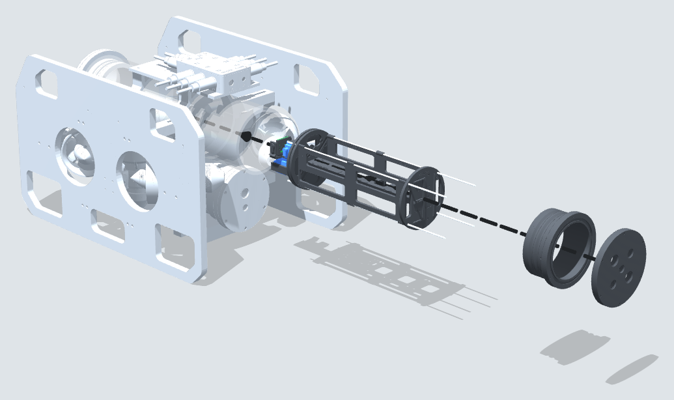
Images/Picture_by_picture/sledin.png
