bgreig/TinkerSub/Images/Picture_by_picture/stations.png

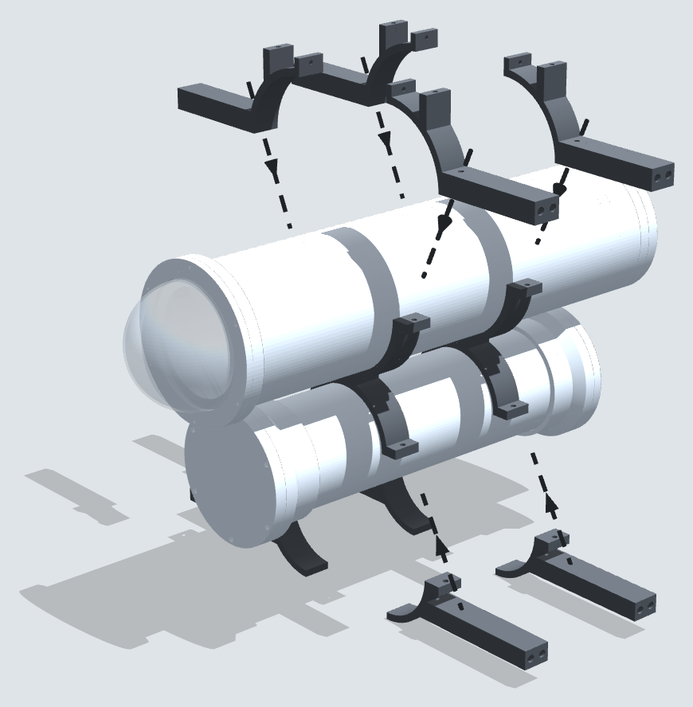
Images/Picture_by_picture/stations.png
