bgreig/TinkerSub/Images/Renders/exploded.png

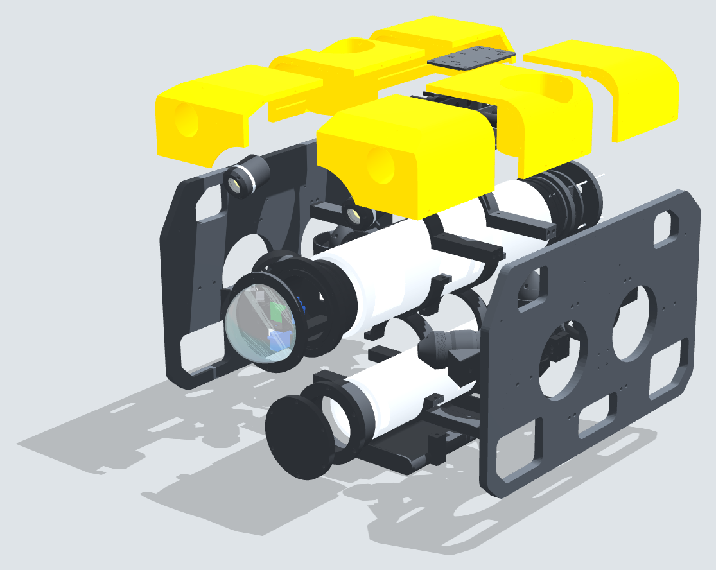
Images/Renders/exploded.png
