bgreig/TinkerSub/Images/Renders/open.png

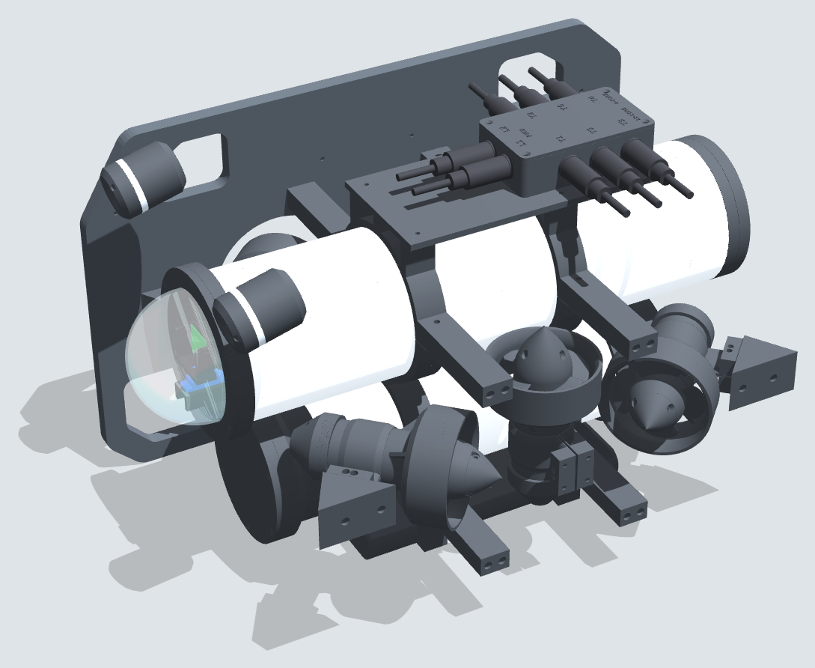
Images/Renders/open.png
