bgreig/TinkerSub/Images/Renders/rear.png

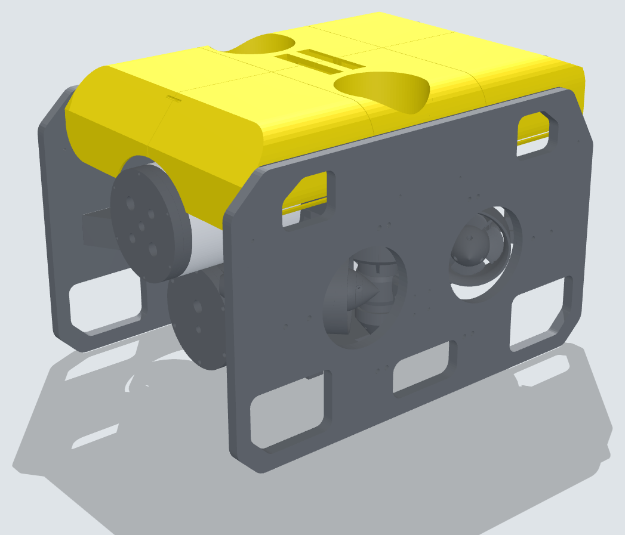
Images/Renders/rear.png
