bgreig/TinkerSub/Images/Renders/side.png

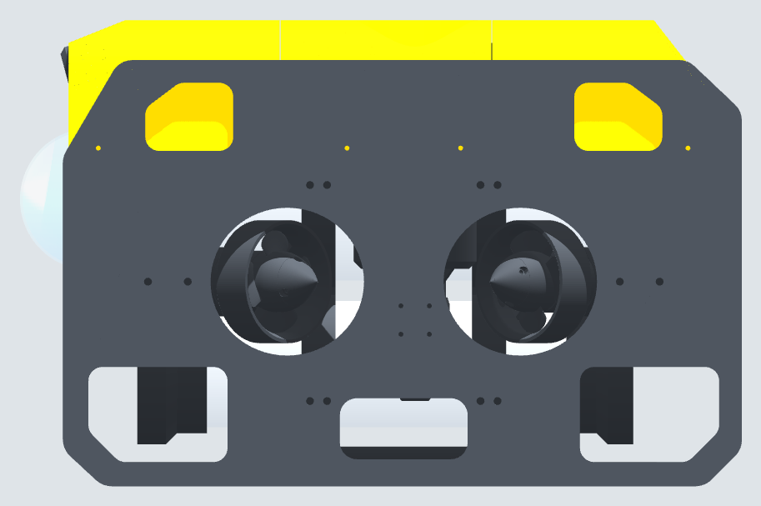
Images/Renders/side.png
