bgreig/TinkerSub/Images/Renders/top.png

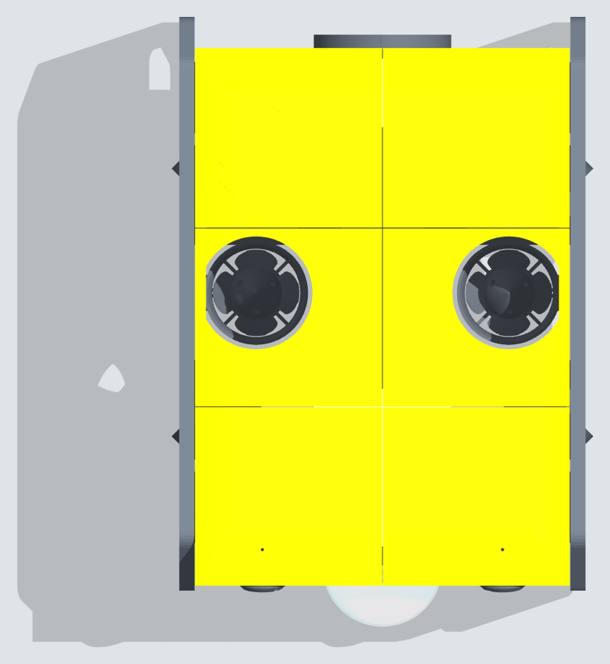
Images/Renders/top.png
