bgreig/TinkerSub/Images/Renders/under.png

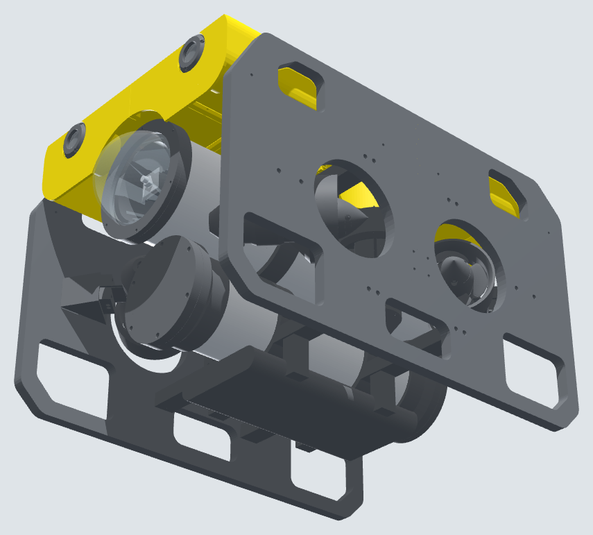
Images/Renders/under.png
