bgreig/TinkerSub/BOM_printed_parts.csv

Part # | Bambu project | Section | File | Qty | Filament | Print notes | Used for | Est. filament (g)
601 | TinkerSub_KB-1_Frame.3mf | Stations + brackets | STL/6_Stations_and_brackets/601_rov_station_top_port.stl | 2 | PETG, black | Flat, no supports. 2x M5 + 1x M3 heat-set inserts. | Station top, port half: hull top + upper arm | 80
602 | TinkerSub_KB-1_Frame.3mf | Stations + brackets | STL/6_Stations_and_brackets/602_rov_station_top_stbd.stl | 2 | PETG, black | Flat, no supports. 2x M5 + 1x M3 heat-set inserts. | Station top, starboard half | 80
603 | TinkerSub_KB-1_Frame.3mf | Stations + brackets | STL/6_Stations_and_brackets/603_rov_station_mid.stl | 2 | PETG, black | Flat, no supports. M4 nuts in the pockets. | Station middle: hull bottom + pod top | 81
604 | TinkerSub_KB-1_Frame.3mf | Stations + brackets | STL/6_Stations_and_brackets/604_rov_station_bot_port.stl | 2 | PETG, black | Flat, no supports. 2x M5 + 1x M4 inserts. | Station bottom, port half: pod bottom + lower arm | 77
605 | TinkerSub_KB-1_Frame.3mf | Stations + brackets | STL/6_Stations_and_brackets/605_rov_station_bot_stbd.stl | 2 | PETG, black | Flat, no supports. 2x M5 + 1x M4 inserts. | Station bottom, starboard half | 77
606 | TinkerSub_KB-1_Frame.3mf | Stations + brackets | STL/6_Stations_and_brackets/606_rov_junction_deck.stl | 1 | PETG, black | Flat. 4x M3 heat-set inserts. | Carries the junction box (501) | 129
607 | TinkerSub_KB-1_Frame.3mf | Stations + brackets | STL/6_Stations_and_brackets/607_rov_bracket_corner_a.stl | 2 | PETG, black | Plate face down. 5 walls, 40 %. 4x M3 + 2x M5 inserts. | Front-port + rear-starboard thruster bracket | 53
608 | TinkerSub_KB-1_Frame.3mf | Stations + brackets | STL/6_Stations_and_brackets/608_rov_bracket_corner_b.stl | 2 | PETG, black | Plate face down. 5 walls, 40 %. 4x M3 + 2x M5 inserts. | Front-starboard + rear-port thruster bracket | 53
106 | TinkerSub_KB-1_Frame.3mf | Thruster pylons | STL/1_Thrusters/106_pylon_clamp.stl | 6 | PETG, black | Rear end down, no supports. M4 + M3 inserts. | Clamps each thruster body | 90
701 | TinkerSub_KB-1_Frame.3mf | Belly pan | STL/7_Belly_pan/701_rov_belly_pan.stl | 1 | PETG, black | Floor down, no supports. | Lead ballast tray under the pod | 107
801 | TinkerSub_KB-1_Frame.3mf | Top cowl (YELLOW) | STL/8_Top_cowl_YELLOW/801_rov_cowl_rear_port.stl | 1 | PETG, yellow | Rear end down. The 3 mm shell prints solid. | Top cowl, rear, port | 196
802 | TinkerSub_KB-1_Frame.3mf | Top cowl (YELLOW) | STL/8_Top_cowl_YELLOW/802_rov_cowl_rear_stbd.stl | 1 | PETG, yellow | Rear end down. | Top cowl, rear, starboard | 196
803 | TinkerSub_KB-1_Frame.3mf | Top cowl (YELLOW) | STL/8_Top_cowl_YELLOW/803_rov_cowl_mid_port.stl | 1 | PETG, yellow | Seam face down. Tree supports (vertical thruster sleeve). | Top cowl, middle, port | 231
804 | TinkerSub_KB-1_Frame.3mf | Top cowl (YELLOW) | STL/8_Top_cowl_YELLOW/804_rov_cowl_mid_stbd.stl | 1 | PETG, yellow | Seam face down. Tree supports. | Top cowl, middle, starboard | 231
805 | TinkerSub_KB-1_Frame.3mf | Top cowl (YELLOW) | STL/8_Top_cowl_YELLOW/805_rov_cowl_front_port.stl | 1 | PETG, yellow | Nose down (light sleeve vertical). | Top cowl, front, port | 218
806 | TinkerSub_KB-1_Frame.3mf | Top cowl (YELLOW) | STL/8_Top_cowl_YELLOW/806_rov_cowl_front_stbd.stl | 1 | PETG, yellow | Nose down. | Top cowl, front, starboard | 218
101 | TinkerSub_KB-1_Core.3mf | Thrusters | STL/1_Thrusters/101_housing_no_foot.stl | 6 | PETG, black | Threaded rear end down, brim, 5 walls. | Thruster body + Kort duct | 410
102 | TinkerSub_KB-1_Core.3mf | Thrusters | STL/1_Thrusters/102_tail_cone_comp.stl | 6 | PETG, black | Tip down, brim. Tap the tip M12 x 1.5. | Tail cone with oil compensator | 80
103 | TinkerSub_KB-1_Core.3mf | Thrusters | STL/1_Thrusters/103_prop_hub_RH.stl | 3 | PETG, black | Back face down, tree supports under the blades. | Right-hand prop | 81
104 | TinkerSub_KB-1_Core.3mf | Thrusters | STL/1_Thrusters/104_prop_hub_LH.stl | 3 | PETG, black | Back face down, tree supports under the blades. | Left-hand prop | 81
105 | TinkerSub_KB-1_Core.3mf | Thrusters | STL/1_Thrusters/105_nose_cone.stl | 6 | PETG, black | Base down. | Prop spinner | 15
107 | TinkerSub_KB-1_Core.3mf | Thrusters | STL/1_Thrusters/107_coupler_gauge.stl | 1 | PETG, black | Tool only, any material. | Sets the coupler height | 3
201 | TinkerSub_KB-1_Core.3mf | Hull + sled | STL/2_Hull_and_sled/201_br_flange_rear.stl | 1 | PETG, black | Ring face down. SOLID: 100 % infill (holds water out). | Hull rear flange | 86
202 | TinkerSub_KB-1_Core.3mf | Hull + sled | STL/2_Hull_and_sled/202_rov_endcap_rear_5hole.stl | 1 | PETG, black | Flat. SOLID: 100 % infill (holds water out). | Hull rear cap: 4 glands + vent | 66
203 | TinkerSub_KB-1_Core.3mf | Hull + sled | STL/2_Hull_and_sled/203_br_flange_front_dome.stl | 1 | PETG, black | Ring face down. SOLID: 100 % infill (holds water out). | Dome flange | 107
204 | TinkerSub_KB-1_Core.3mf | Hull + sled | STL/2_Hull_and_sled/204_dome_retaining_ring.stl | 1 | PETG, black | Flat. | Dome clamp ring | 30
207 | TinkerSub_KB-1_Core.3mf | Hull + sled | STL/2_Hull_and_sled/207_sled_bulkhead_front.stl | 1 | PETG, black | Flat. | Sled front bulkhead | 27
212 | TinkerSub_KB-1_Core.3mf | Hull + sled | STL/2_Hull_and_sled/212_sled_rail_port.stl | 1 | PETG, black | Flat outer face down, no supports. | Sled side rail, port (12 V side) | 34
213 | TinkerSub_KB-1_Core.3mf | Hull + sled | STL/2_Hull_and_sled/213_sled_rail_stbd.stl | 1 | PETG, black | Flat outer face down, no supports. | Sled side rail, starboard (logic side) | 34
214 | TinkerSub_KB-1_Core.3mf | Hull + sled | STL/2_Hull_and_sled/214_sled_deck.stl | 1 | PETG, black | Flat. 4 walls, 40 %. | Sled deck: boards on both faces | 43
215 | TinkerSub_KB-1_Core.3mf | Hull + sled | STL/2_Hull_and_sled/215_sled_bulkhead_rear_v2.stl | 1 | PETG, black | Front face down, pockets up. | Sled rear bulkhead: 12 V bus + LED drivers | 39
216 | TinkerSub_KB-1_Core.3mf | Hull + sled | STL/2_Hull_and_sled/216_pantilt_base.stl | 1 | PETG, black | Plate face down, no supports. 5 walls. | Pan-tilt base v2: on the sled rods, carries the pan servo | 25
217 | TinkerSub_KB-1_Core.3mf | Hull + sled | STL/2_Hull_and_sled/217_pantilt_yoke.stl | 1 | PETG, black | Base down, no supports. 5 walls, 40 % infill. | Pan-tilt yoke v2: on the pan horn, tilt servo in a closed pocket | 6
218 | TinkerSub_KB-1_Core.3mf | Hull + sled | STL/2_Hull_and_sled/218_pantilt_cradle.stl | 1 | PETG, black | On its side, axle up. Tree supports ON (under the port cheek). 100 %. | Pan-tilt camera cradle | 1
219 | TinkerSub_KB-1_Core.3mf | Hull + sled | STL/2_Hull_and_sled/219_pantilt_lever.stl | 1 | PETG, black | Flat. 100 %. | Tilt lever on the cradle axle | 0
301 | TinkerSub_KB-1_Core.3mf | Battery pod | STL/3_Battery_pod/301_rov_pod_flange_3in.stl | 2 | PETG, black | Socket end down. SOLID: 100 % infill. 6x M5 inserts each. | 3" pod flange, one at each end | 144
302 | TinkerSub_KB-1_Core.3mf | Battery pod | STL/3_Battery_pod/302_rov_pod_endcap_3in_rear.stl | 1 | PETG, black | Plate down. SOLID: 100 % infill (holds water out). | 3" pod rear cap: M16 gland + vent | 91
303 | TinkerSub_KB-1_Core.3mf | Battery pod | STL/3_Battery_pod/303_rov_pod_endcap_3in_front.stl | 1 | PETG, black | Plate down. SOLID: 100 % infill (holds water out). | 3" pod front cap, blank (no holes) | 110
305 | TinkerSub_KB-1_Core.3mf | Battery pod | STL/3_Battery_pod/305_rov_cell_plate_8_v2.stl | 6 | PETG, black | Grooved face down. | 18650 holder plate | 110
306 | TinkerSub_KB-1_Core.3mf | Battery pod | STL/3_Battery_pod/306_rov_cell_spacer_3mm.stl | 8 | PETG, black | Flat. | Rod spacer between groups | 1
401 | TinkerSub_KB-1_Core.3mf | Lights | STL/4_Lights/401_rov_light_rear_body.stl | 2 | PETG, black | Socket end down. 5 walls. (ASA also fine.) | Light head rear body | 38
402 | TinkerSub_KB-1_Core.3mf | Lights | STL/4_Lights/402_rov_light_front_ring.stl | 2 | PETG, black | Front face down. SOLID: 100 % infill (seals the window). | Light head front ring | 14
403 | TinkerSub_KB-1_Core.3mf | Lights | STL/4_Lights/403_rov_light_spacer.stl | 2 | PETG, black | Flat. | Window spacer | 3
501 | TinkerSub_KB-1_Core.3mf | Junction boxes | STL/5_Junction_boxes/501_rov_junction_box.stl | 1 | PETG, black | Base down, no supports. 5 walls. | Junction box: 6 thruster + 2 light SP13 sockets, 12-core + 4-core out | 38
503 | TinkerSub_KB-1_Core.3mf | Junction boxes | STL/5_Junction_boxes/503_rov_junction_lid.stl | 1 | PETG, black | Top face down (as exported), no supports. | Junction box lid with the socket map | 28
