bgreig/TinkerSub/Parts_to_buy.csv

Group | Qty | Item (exact size) | Used for | Approx. price (US) | Source
Printed parts | 2.9 kg | PETG filament, black | every printed part except the cowl (includes ~10 % for brims and reprints) | $45-60 | Bambu / Amazon
Printed parts | 1.5 kg | PETG filament, yellow | the six top cowl sections | $20-25 | Bambu / Amazon
Fasteners | 6 | M2.5 x 25 mm socket head cap screw, stainless | light head: ring + disc to body | $3-5 (pack) | Amazon / hardware store
Fasteners | 18 | M3 x 8 mm button head screw, stainless | nose cone to prop hub | $3-5 (pack) | Amazon / hardware store
Fasteners | 4 | M3 x 8 mm socket head cap screw, stainless | junction box to deck | $3-5 (pack) | Amazon / hardware store
Fasteners | 4 | M3 x 8 mm countersunk screw, stainless | junction box lid | $3-5 (pack) | Amazon / hardware store
Fasteners | 10 | M3 x 10 mm socket head cap screw, stainless | junction deck to station rib; radial flange screw through the pipe | $3-5 (pack) | Amazon / hardware store
Fasteners | 6 | M3 x 12 mm socket head cap screw, stainless | dome ring | $3-5 (pack) | Amazon / hardware store
Fasteners | 22 | M3 x 16 mm socket head cap screw, stainless | corner pylon to bracket; hull rear cap | $3-5 (pack) | Amazon / hardware store
Fasteners | 28 | M3 x 20 mm socket head cap screw, stainless | station top halves, centre rib; cowl centre seam; cowl section seam; cowl foot to side plate | $3-5 (pack) | Amazon / hardware store
Fasteners | 8 | M3 x 30 mm socket head cap screw, stainless | vertical pylon through the plate | $3-5 (pack) | Amazon / hardware store
Fasteners | 4 | M4 x 20 mm socket head cap screw, stainless | station middle to bottom (pod pair) | $3-5 (pack) | Amazon / hardware store
Fasteners | 16 | M4 x 30 mm socket head cap screw, stainless | pylon pinch bolt; station top to middle (hull pair) | $3-5 (pack) | Amazon / hardware store
Fasteners | 4 | M4 x 50 mm socket head cap screw, stainless | belly pan hanger | $3-5 (pack) | Amazon / hardware store
Fasteners | 6 | M5 x 14 mm socket head cap screw, stainless | pod rear cap | $3-5 (pack) | Amazon / hardware store
Fasteners | 6 | M5 x 16 mm socket head cap screw, stainless | pod front cap | $3-5 (pack) | Amazon / hardware store
Fasteners | 24 | M5 x 20 mm socket head cap screw, stainless | side plate to station arm; side plate to corner bracket | $3-5 (pack) | Amazon / hardware store
Fasteners | 28 | M3 nyloc nut, stainless | screw joints with a nut | $3 (pack) | Amazon / hardware store
Fasteners | 8 | M4 hex nut, stainless | screw joints with a nut | $3 (pack) | Amazon / hardware store
Fasteners | 8 | M3 washer, 1 mm thick (shim) | vertical pylons | $2 (pack) | Hardware store
Fasteners | 42 | M3 brass heat-set insert (for 3D prints) | Appendix B chart | $8-10 (pack) | Amazon
Fasteners | 16 | M4 brass heat-set insert (for 3D prints) | Appendix B chart | $8-10 (pack) | Amazon
Fasteners | 36 | M5 brass heat-set insert (for 3D prints) | Appendix B chart | $8-10 (pack) | Amazon
Thrusters | 6 | 1200 GPH bilge pump motor cartridge | T1-T6 | $20-25 each | Amazon / marine store
Thrusters | 6 | Brass shaft coupler, 3 mm to 5 mm, 9 mm OD x 20 mm | motor shaft to prop stud | $12 (6) | Amazon
Thrusters | 6 | M5 x 20 mm set screw (grub screw), stainless | prop stud in each coupler | $4 (pack) | Hardware store
Thrusters | 6 | M5 hex nut, stainless | jam nut, drives the prop hub | $2 (pack) | Hardware store
Thrusters | 6 | M5 nyloc nut, stainless | holds the prop hub on | $2 (pack) | Hardware store
Thrusters | 12 | M4 x 4 mm set screw (grub screw), stainless | oil fill and bleed ports, 2 per tail cone | $3 (pack) | Hardware store
Thrusters | 6 | O-ring 32 x 2 mm (ID x cross-section), nitrile | tail cone spigot | $6 (kit) | Amazon
Thrusters | 6 | O-ring 5 x 1.5 mm, nitrile | holds each compensator bladder on its nipple | in the 1.5 mm kit | Amazon
Thrusters | 6 (+4 spare) | Nitrile finger cot | compensator bladders | $6 (pack) | Pharmacy / Amazon
Thrusters | 500 ml | Mineral oil (white, food or USP grade) | oil fill | $6 | Pharmacy
Thrusters | 6 | Cable gland M12 x 1.5, nylon, clamping range 3-6.5 mm | motor lead out of each tail cone | $8 (10-pack) | Amazon
Hull | 1 | 4" Sch40 PVC pipe, 406 mm (16") | electronics hull | $15 | Hardware store
Hull | 1 | Acrylic dome 100 mm, 115 mm flange (UQISOVI, Amazon B0DR2HP4YQ) | camera dome | $15-25 | Amazon
Hull | 4 | O-ring AS568-238 (94.84 x 3.53 mm / 3.734 x 0.139"), nitrile 70A | flanges 201 and 203, two radial grooves each | $5 (pack) | Amazon / McMaster
Hull | 1 | O-ring AS568-237 (91.67 x 3.53 mm / 3.609 x 0.139"), nitrile 70A | rear cap face seal, on 201 | $5 (pack) | Amazon / McMaster
Hull | 1 | O-ring AS568-240 (101.19 x 3.53 mm / 3.984 x 0.139"), nitrile 70A | dome face seal, on 203 | $5 (pack) | Amazon / McMaster
Hull | 2 | Cable gland M16 x 1.5, nylon, clamping range 5-10 mm | MOTORS and BATTERY in the rear cap | $8 (5-pack) | Amazon
Hull | 2 | Cable gland M12 x 1.5, nylon, clamping range 3-6.5 mm | LIGHTS and TETHER in the rear cap | $8 (10-pack) | Amazon
Hull + pod | 2 | M10 x 1.0 x 12 mm hex bolt (fine pitch), stainless | VENT plugs in 202 and 302 | $4 | Hardware store / Amazon
Hull + pod | 4 | M10 bonded sealing washer (Dowty) | under the vent bolts and the test barb (2 spare) | $6 (pack) | Amazon
Hull + pod | 1 | M10 x 1.0 male to 6 mm (1/4") hose barb, brass | vacuum tests | $6 | Amazon
Sled | 2 | M3 threaded rod, 1 m, stainless | cut 4 sled rods of 340 mm | $4 each | Hardware store
Sled | 24 | M3 hex nut, stainless | sled rods (16) and pan-tilt base (8) | $3 (pack) | Hardware store
Sled | 12 | M3 x 8 mm male-female standoff, brass | IBT_2 boards | $10 (standoff kit) | Amazon
Sled | 12 | M3 x 8 mm female-female standoff, brass | IBT_2 boards | in the standoff kit | Amazon
Sled | 24 | M3 x 6 mm screw | IBT_2 boards | $3 (pack) | Hardware store
Sled | 4 | M3 x 10 mm male-female standoff, brass | Pico breakout | in the standoff kit | Amazon
Sled | 4 | M3 x 6 mm screw | Pico breakout onto its standoffs | $3 (pack) | Hardware store
Sled | 4 | M2.5 x 8 mm male-female standoff, brass | Pi Zero | $6 (kit) | Amazon
Sled | 4 | M2.5 x 6 mm screw | Pi Zero onto its standoffs | in the M2.5 kit | Amazon
Camera | 1 | Arducam for Pi Zero (Pi Camera v2 size board) + 150-200 mm Pi Zero ribbon | camera | $20-30 | Arducam / Amazon
Camera | 2 | MG90S metal-gear micro servo (with its screws and horns) | pan and tilt | $10 (2) | Amazon
Camera | 9 | M2 x 6 mm self-tapping screw | servo horn (4), camera (4), tilt lever (1) | $6 (M2 kit) | Amazon / hobby shop
Camera | 1 | M2 x 8 mm self-tapping screw | cradle pivot | in the M2 kit | Amazon / hobby shop
Camera | 4 | M2 x 2 mm spacer / standoff | under the camera board | in the M2 kit | Amazon / hobby shop
Camera | 1 | M2 flat washer | tilt lever | in the M2 kit | Amazon / hobby shop
Camera | 100 mm | 1 mm steel music wire | tilt pushrod | $3 | Hobby shop
Battery pod | 1 | 3" Sch40 PVC pipe, 300 mm | battery pod | $12 | Hardware store
Battery pod | 4 | O-ring 72 x 2.5 mm, nitrile | pod caps, two per cap | $5 (pack) | Amazon
Battery pod | 1 | O-ring 80 x 2.5 mm, nitrile | rear cap face seal, in the groove on 302 | $5 (pack) | Amazon
Battery pod | 1 | Cable gland M16 x 1.5, nylon, clamping range 5-10 mm | battery lead out of the rear cap | $8 (5-pack) | Amazon
Battery pod | 24 | 18650 Li-ion cell, matched (same model and batch) | 3S8P pack | $3-5 each | Battery supplier
Battery pod | 1 | 3S BMS, 40 A, with balancing | pack | $12 | Amazon
Battery pod | 1 | M4 threaded rod, 1 m, stainless | cut 4 pack tie rods of ~225 mm | $4 | Hardware store
Battery pod | 16 | M4 hex nut, stainless | pack tie rods | $3 (pack) | Hardware store
Battery pod | 3 m | Pure nickel strip, 8 x 0.2 mm (not nickel-plated steel) | cell links | $10 | Amazon
Battery pod | 1 + 1 | Inline ATO fuse holder, 12 AWG + 35 A ATO fuse | pack fuse | $5 | Auto parts store
Battery pod | 1 set | Fish-paper insulator rings (18650), Kapton tape, silica gel packs | pack | $15 | Amazon
Battery pod | 1 | 2-part marine epoxy (JB Weld Marine or West System) | bonds the pod flanges to the pipe | $10 | Hardware store
Lights | 2 (+1 spare) | Cree XHP50.2 LED, 6 V version, 5000-6500 K, on a 20 mm copper DTP star | light heads | $8-12 each | Amazon / Satisled / KaiDomain
Lights | 2 | Mean Well LDD-700HW constant-current LED driver | inside the hull | $8-10 each | Amazon / Jameco / Digi-Key
Lights | 2 | Glass lens 28 x 3 mm, AR coated | light windows | $8 (pack) | Amazon
Lights | 1 | 6061 aluminium round bar, 1-3/4" x 6" | two 5 mm heat-sink discs | $12 | Amazon
Lights | 1 | Thermal adhesive (Arctic Alumina) | LED star onto the disc | $10 | Amazon
Lights | 2 | O-ring 30 x 1.5 mm, nitrile | front ring face groove | $10 (1.5 mm kit) | Amazon
Lights | 2 | O-ring 24 x 1.5 mm, nitrile | window, under the front lip | in the 1.5 mm kit | Amazon
Lights | 2 | M3 x 8 mm set screw (grub screw), stainless | locks each light head in the cowl | $2 (pack) | Hardware store
Frame | 1 | Black HDPE sheet, 1/2" (12.7 mm), 24 x 24" (at least 605 mm one way) | both side plates | $40-60 | Amazon / plastics supplier
Frame | 1.6-2.3 kg | Lead shot in sealed bags (or lead bar) | belly pan ballast | $15-25 | Sporting goods
Cowl | 1.0-1.7 L | Depth-rated closed-cell foam (PVC core foam such as H80, or 2-lb closed-cell PU) | buoyancy blocks in the cowl | $20-35 | Composites supplier / Amazon
Junction box | 6 pairs | SP13 IP68 2-pin connector: panel socket (rear nut) + cable plug, 4-6.5 mm cable | thrusters T1-T6 | $18-25 | Amazon / AliExpress
Junction box | 2 pairs | SP13 IP68 3-pin connector: panel socket (rear nut) + cable plug, 4-6.5 mm cable | lights L1, L2 | $6-9 | Amazon / AliExpress
Junction box | 1 | MG Chemicals 832B epoxy potting compound | junction box and light cavities | $35-40 | Amazon
Wiring | 4 m | 2-core 18 AWG marine cable, OD 5-6 mm | 6 thruster leads + 2 light leads | $15 | Amazon
Wiring | 0.8 m | 12-core control cable, 0.5 mm2 cores, OD 8-10 mm | junction box to the hull (motors) | $10 | Amazon
Wiring | 0.5 m | 4-core cable, 0.5-0.75 mm2 cores, OD 3-6.5 mm | junction box to the hull (lights) | $4 | Amazon
Wiring | 0.6 m | 2-core 12 AWG silicone or marine cable, OD 5-10 mm | battery pod to the hull | $6 | Amazon
Wiring | as needed | Cat6 cable, slim (OD 6.5 mm or less), + strain relief | tether (data only) | $20-40 | Amazon
Electronics | 6 | IBT_2 (BTS7960) H-bridge motor driver | U1-U6 | $40-60 (6) | Amazon
Electronics | 2 | Mini MP1584EN buck board, fixed 5 V, 1.8 A | U9A, U9B | $8 (pack) | Amazon
Electronics | 1 | Raspberry Pi Pico with headers + 57 x 63 mm screw-terminal breakout board | U10 | $12 | Pi reseller / Amazon
Electronics | 1 | Raspberry Pi Zero 2W with header | U11 | $15-18 | Pi reseller
Electronics | 1 | Waveshare ETH/USB HUB HAT (RTL8152B) for Pi Zero | U12 | $15-20 | Waveshare / Amazon
Electronics | 1 | Cat6 patch lead 0.3 m, one end 90-degree | HAT to the tether | $6 | Amazon
Electronics | 1 | RJ45 inline coupler | patch lead to the tether | $3 | Amazon
Electronics | 1 + 1 | Inline ATO/ATC fuse holder, 12 AWG + 30 A fuse | F1 | $7 | Auto parts store
Electronics | 1 + 1 | Inline mini-blade fuse holder + 3 A fuse | F2 | $4 | Auto parts store
Electronics | 1 | Capacitor 1000 uF 25 V low-ESR electrolytic | C1 | $1 | DigiKey / Mouser
Electronics | 1 | Capacitor 470 uF 10 V electrolytic | C2 | $0.50 | DigiKey / Mouser
Electronics | 1 | 1N5817 Schottky diode | D1 | $0.25 | DigiKey / Mouser
Electronics | 3 | Resistor 10 k, 1/4 W | R1, R2, R4 | $0.10 each | Any
Electronics | 1 | Resistor 33 k, 1/4 W | R3 | $0.10 | Any
Electronics | 2 | Wago 221-415 lever connector (5-way) | 12 V and GND bus | $6 (2) | Amazon
Electronics | 1 m + 1 m | 14 AWG silicone wire, red + black | bus to the top driver boards | $8 | Amazon
Electronics | 0.5 m + 0.5 m | 16 AWG silicone wire, red + black | jumpers to the bottom driver boards | $6 | Amazon
Electronics | 1 m + 1 m | 20 AWG silicone wire, red + black | aux branch | $5 | Amazon
Electronics | 1 set | Dupont female housings + 22 AWG and 26 AWG hook-up wire | logic wiring: RPWM / LPWM wires and the ARM / VCC / GND chain | $8 | Amazon
Supplies | 1 | Silicone O-ring grease (not petroleum) | every O-ring | $6 | Hardware store
Supplies | 1 | Silicone dielectric grease | SP13 plug threads and pins | $6 | Hardware store
Supplies | 1 | Clear silicone sealant (RTV), small tube | gland threads and oil-port set screws | $6 | Hardware store
Supplies | 1 set | Heat-shrink assortment incl. 20-25 mm clear, double-sided foam tape, zip ties 2.5-3.6 mm | splices, buck boards, harness | $8 | Any
