bgreig/TinkerSub/Images/Parts/101_housing_no_foot.png

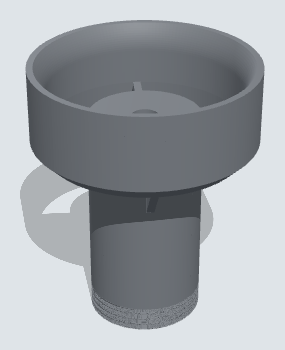
Images/Parts/101_housing_no_foot.png
