bgreig/TinkerSub/Images/Parts/102_tail_cone_comp.png

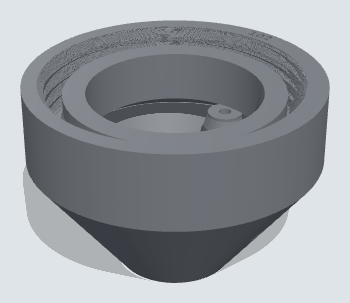
Images/Parts/102_tail_cone_comp.png
