bgreig/TinkerSub/Images/Parts/103_prop_hub_RH.png

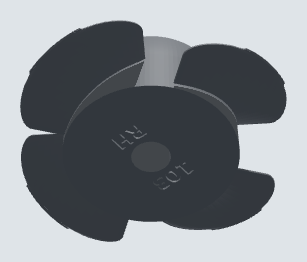
Images/Parts/103_prop_hub_RH.png
