bgreig/TinkerSub/Images/Parts/104_prop_hub_LH.png

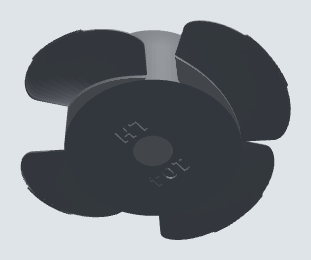
Images/Parts/104_prop_hub_LH.png
