bgreig/TinkerSub/Images/Parts/105_nose_cone.png

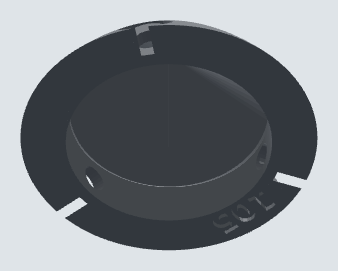
Images/Parts/105_nose_cone.png
