bgreig/TinkerSub/Images/Parts/106_pylon_clamp.png

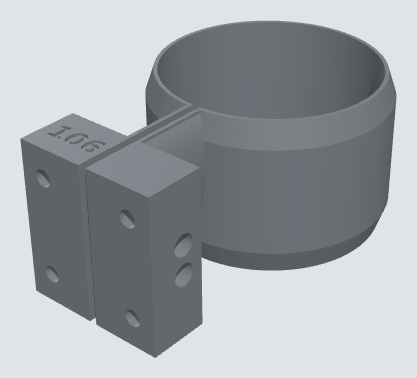
Images/Parts/106_pylon_clamp.png
