bgreig/TinkerSub/Images/Parts/107_coupler_gauge.png

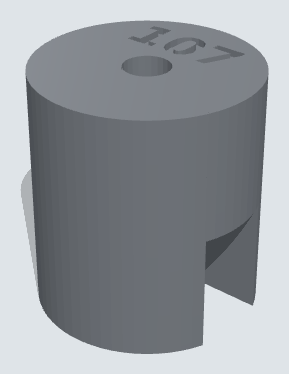
Images/Parts/107_coupler_gauge.png
