bgreig/TinkerSub/Images/Parts/201_br_flange_rear.png

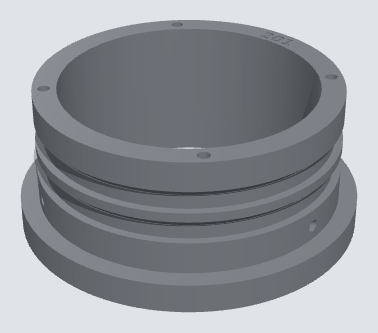
Images/Parts/201_br_flange_rear.png
