bgreig/TinkerSub/Images/Parts/202_rov_endcap_rear_5hole.png

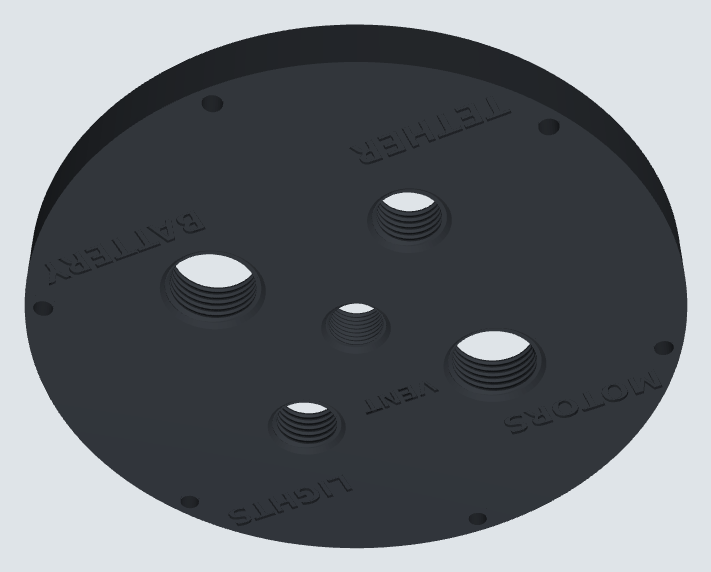
Images/Parts/202_rov_endcap_rear_5hole.png
