bgreig/TinkerSub/Images/Parts/203_br_flange_front_dome.png

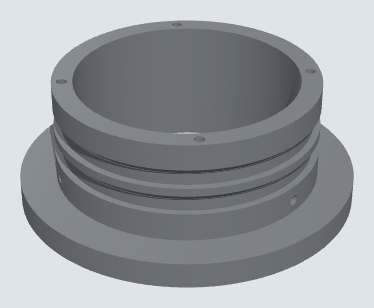
Images/Parts/203_br_flange_front_dome.png
