bgreig/TinkerSub/Images/Parts/204_dome_retaining_ring.png

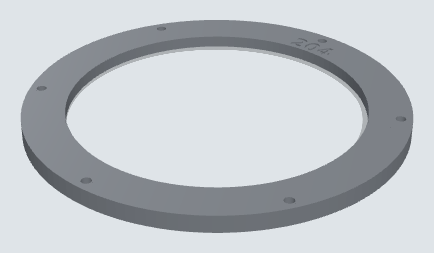
Images/Parts/204_dome_retaining_ring.png
