bgreig/TinkerSub/Images/Parts/207_sled_bulkhead_front.png

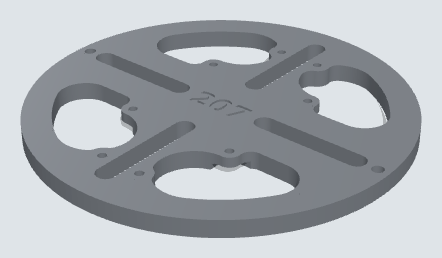
Images/Parts/207_sled_bulkhead_front.png
