bgreig/TinkerSub/Images/Parts/212_sled_rail_port.png

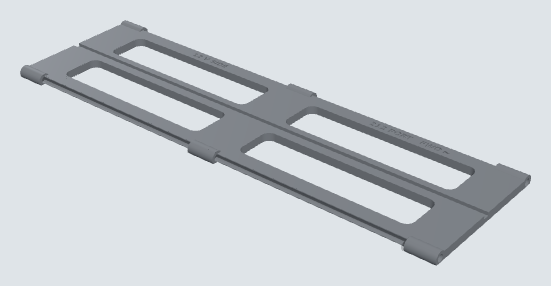
Images/Parts/212_sled_rail_port.png
