bgreig/TinkerSub/Images/Parts/214_sled_deck.png

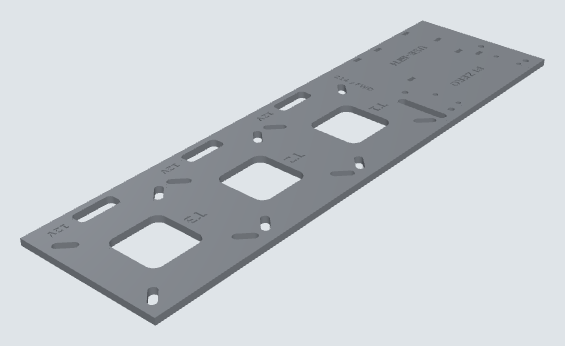
Images/Parts/214_sled_deck.png
