bgreig/TinkerSub/Images/Parts/215_sled_bulkhead_rear_v2.png

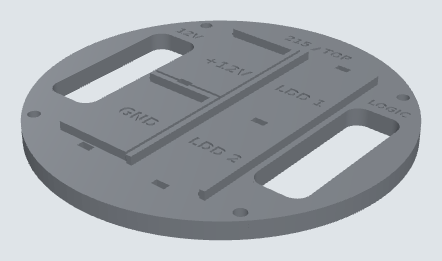
Images/Parts/215_sled_bulkhead_rear_v2.png
