bgreig/TinkerSub/Images/Parts/216_pantilt_base.png

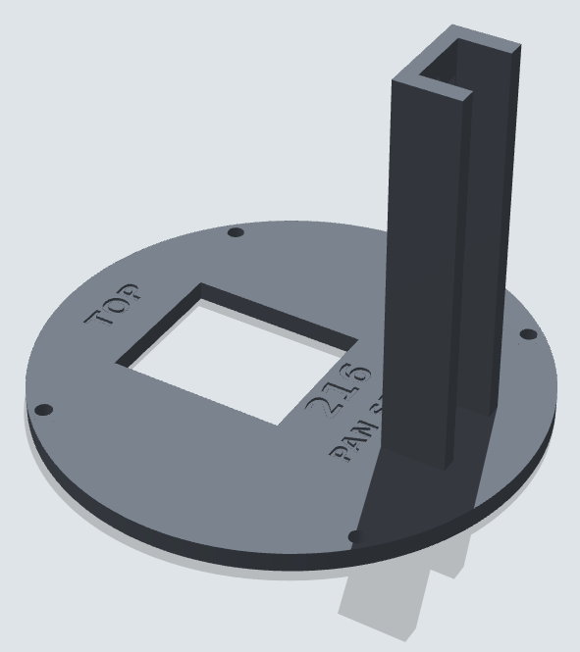
Images/Parts/216_pantilt_base.png
