bgreig/TinkerSub/Images/Parts/217_pantilt_yoke.png

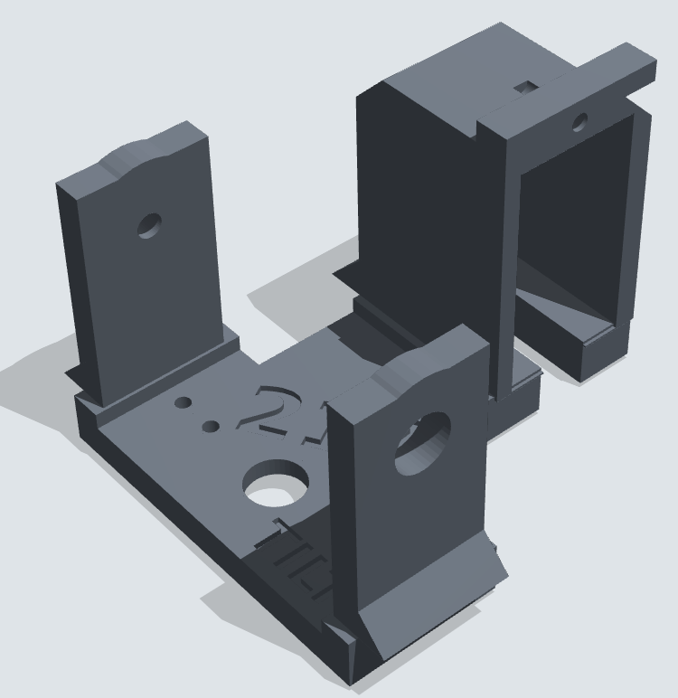
Images/Parts/217_pantilt_yoke.png
