bgreig/TinkerSub/Images/Parts/218_pantilt_cradle.png

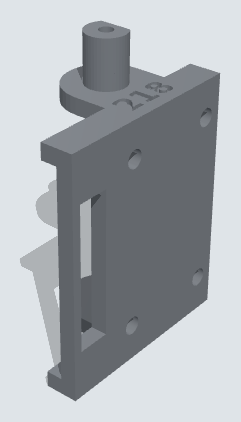
Images/Parts/218_pantilt_cradle.png
