bgreig/TinkerSub/Images/Parts/219_pantilt_lever.png

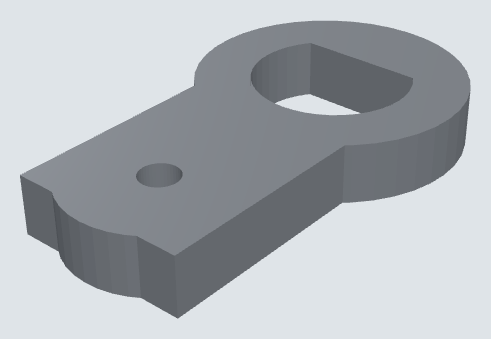
Images/Parts/219_pantilt_lever.png
