bgreig/TinkerSub/Images/Parts/301_rov_pod_flange_3in.png

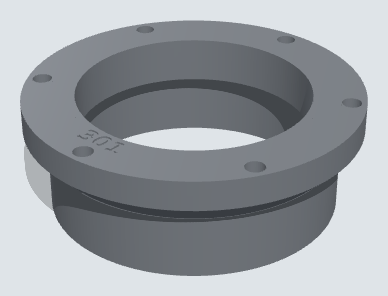
Images/Parts/301_rov_pod_flange_3in.png
