bgreig/TinkerSub/Images/Parts/302_rov_pod_endcap_3in_rear.png

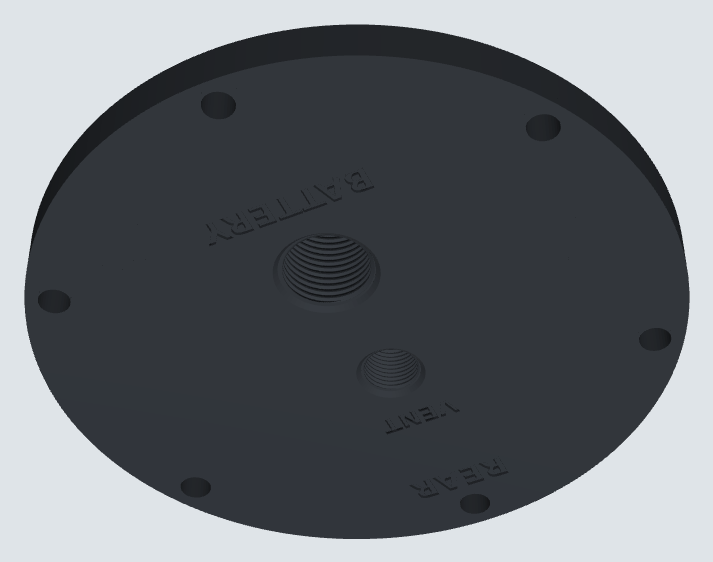
Images/Parts/302_rov_pod_endcap_3in_rear.png
