bgreig/TinkerSub/Images/Parts/303_rov_pod_endcap_3in_front.png

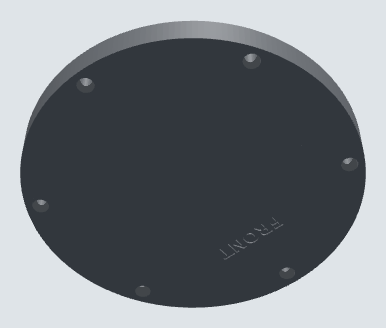
Images/Parts/303_rov_pod_endcap_3in_front.png
