bgreig/TinkerSub/Images/Parts/305_rov_cell_plate_8_v2.png

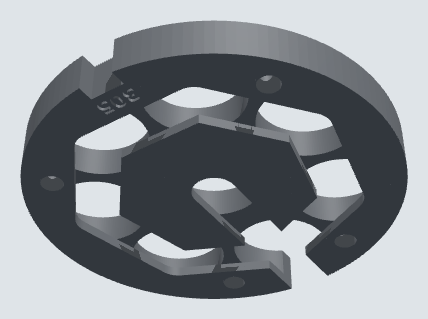
Images/Parts/305_rov_cell_plate_8_v2.png
