bgreig/TinkerSub/Images/Parts/306_rov_cell_spacer_3mm.png

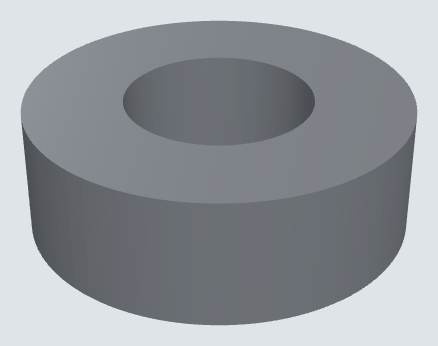
Images/Parts/306_rov_cell_spacer_3mm.png
