bgreig/TinkerSub/Images/Parts/401_rov_light_rear_body.png

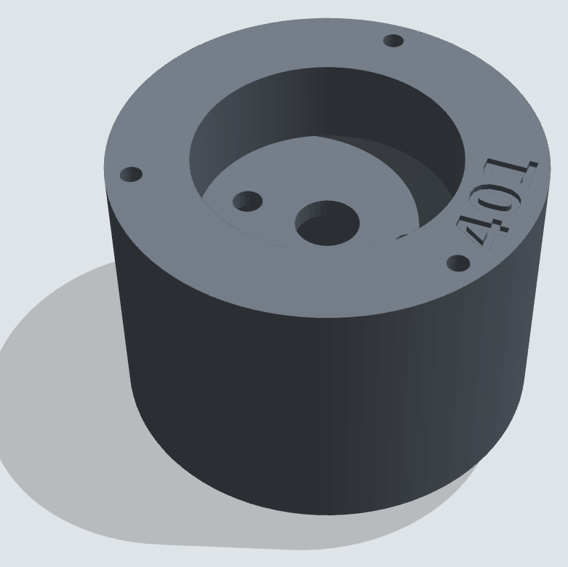
Images/Parts/401_rov_light_rear_body.png
