bgreig/TinkerSub/Images/Parts/402_rov_light_front_ring.png

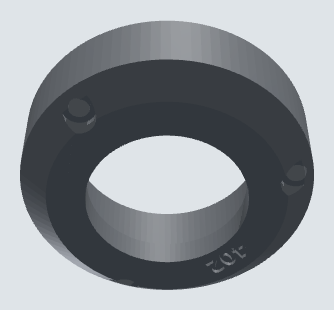
Images/Parts/402_rov_light_front_ring.png
