bgreig/TinkerSub/Images/Parts/403_rov_light_spacer.png

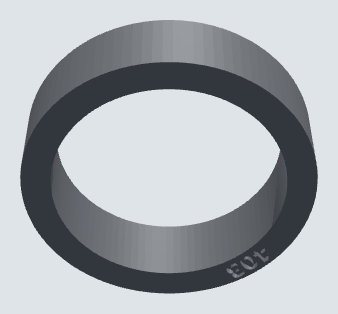
Images/Parts/403_rov_light_spacer.png
