bgreig/TinkerSub/Images/Parts/501_rov_junction_box.png

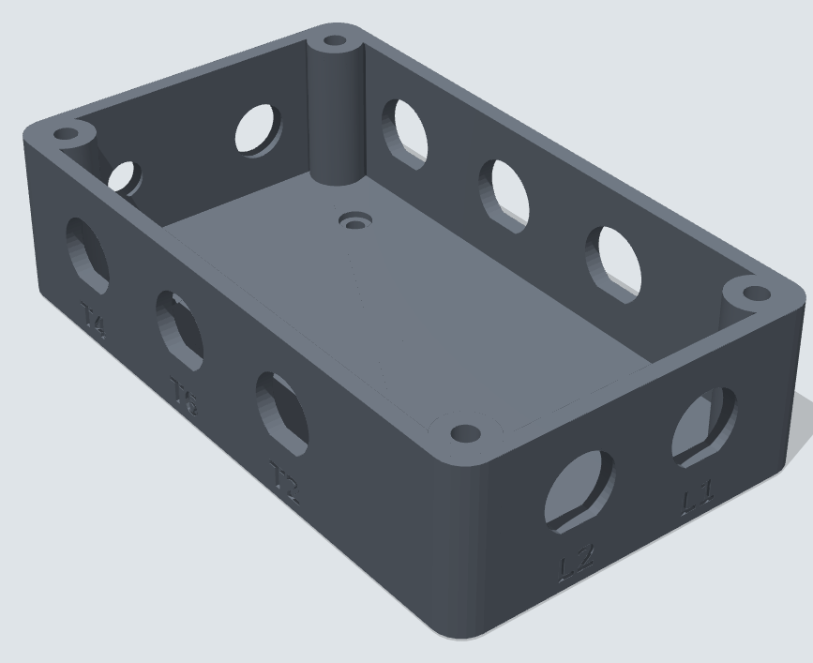
Images/Parts/501_rov_junction_box.png
