bgreig/TinkerSub/Images/Parts/503_rov_junction_lid.png

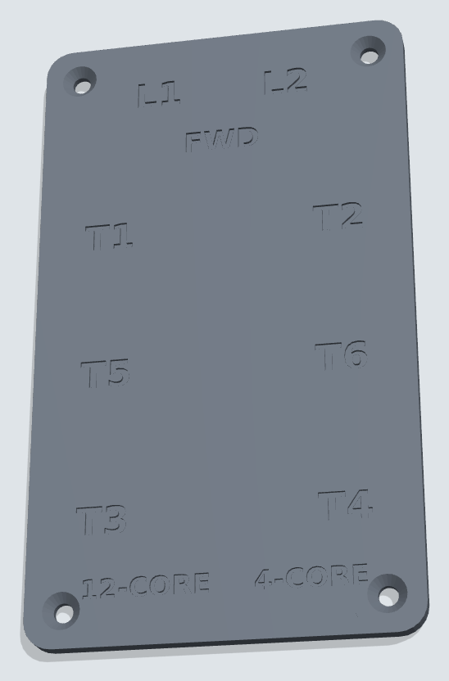
Images/Parts/503_rov_junction_lid.png
