bgreig/TinkerSub/Images/Parts/601_rov_station_top_port.png

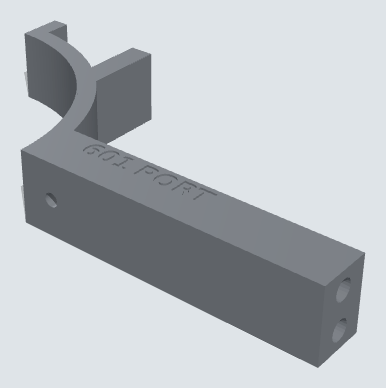
Images/Parts/601_rov_station_top_port.png
