bgreig/TinkerSub/Images/Parts/602_rov_station_top_stbd.png

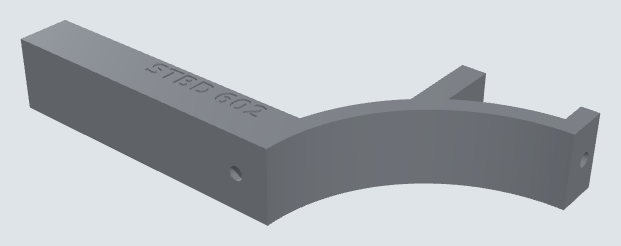
Images/Parts/602_rov_station_top_stbd.png
