bgreig/TinkerSub/Images/Parts/603_rov_station_mid.png

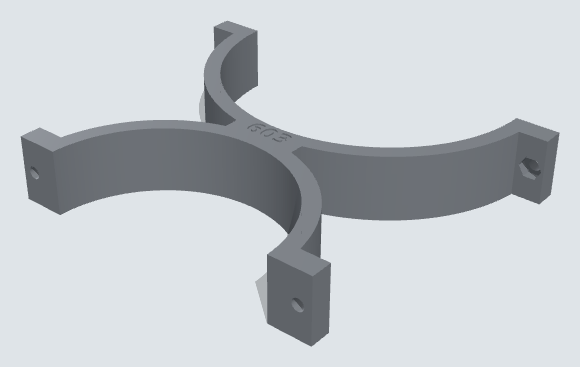
Images/Parts/603_rov_station_mid.png
