bgreig/TinkerSub/Images/Parts/604_rov_station_bot_port.png

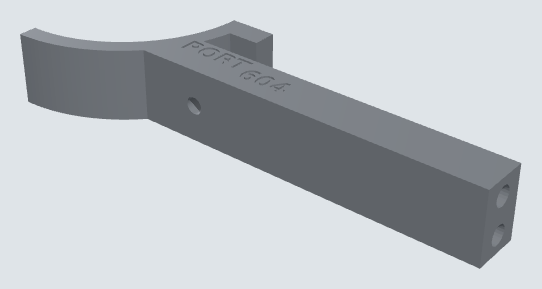
Images/Parts/604_rov_station_bot_port.png
