bgreig/TinkerSub/Images/Parts/605_rov_station_bot_stbd.png

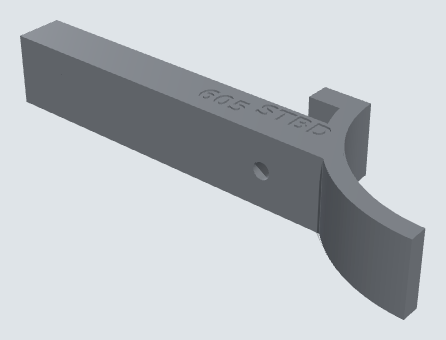
Images/Parts/605_rov_station_bot_stbd.png
