bgreig/TinkerSub/Images/Parts/606_rov_junction_deck.png

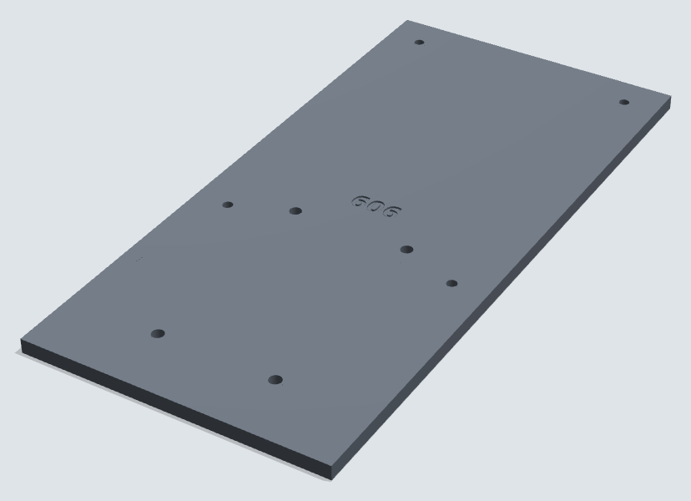
Images/Parts/606_rov_junction_deck.png
