bgreig/TinkerSub/Images/Parts/607_rov_bracket_corner_a.png

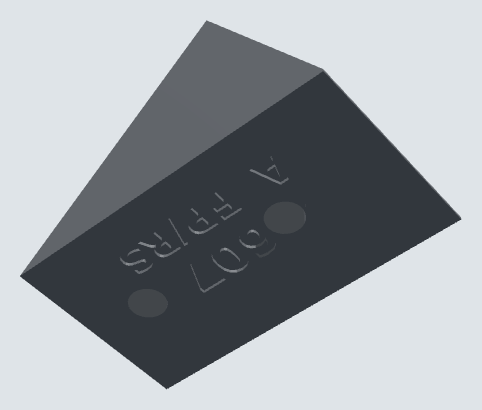
Images/Parts/607_rov_bracket_corner_a.png
