bgreig/TinkerSub/Images/Parts/608_rov_bracket_corner_b.png

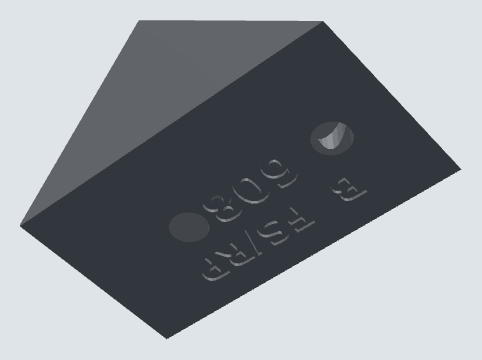
Images/Parts/608_rov_bracket_corner_b.png
