bgreig/TinkerSub/Images/Parts/701_rov_belly_pan.png

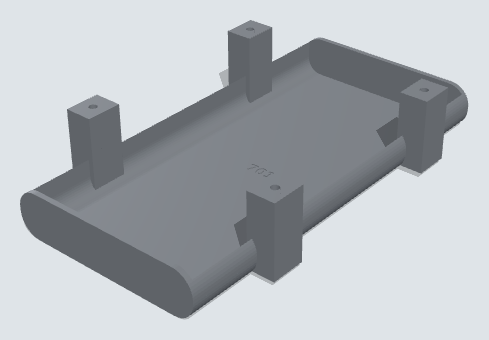
Images/Parts/701_rov_belly_pan.png
