bgreig/TinkerSub/Images/Parts/801_rov_cowl_rear_port.png

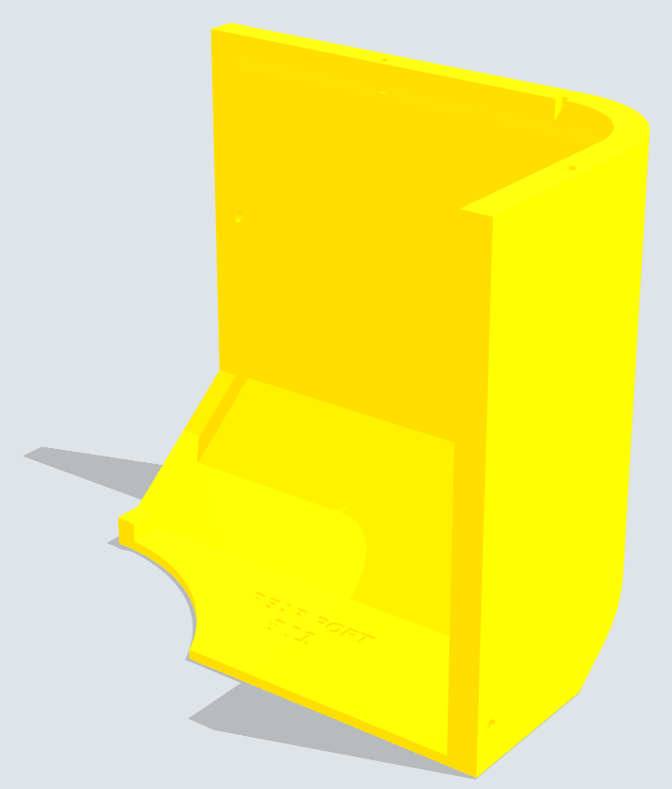
Images/Parts/801_rov_cowl_rear_port.png
