bgreig/TinkerSub/Images/Parts/802_rov_cowl_rear_stbd.png

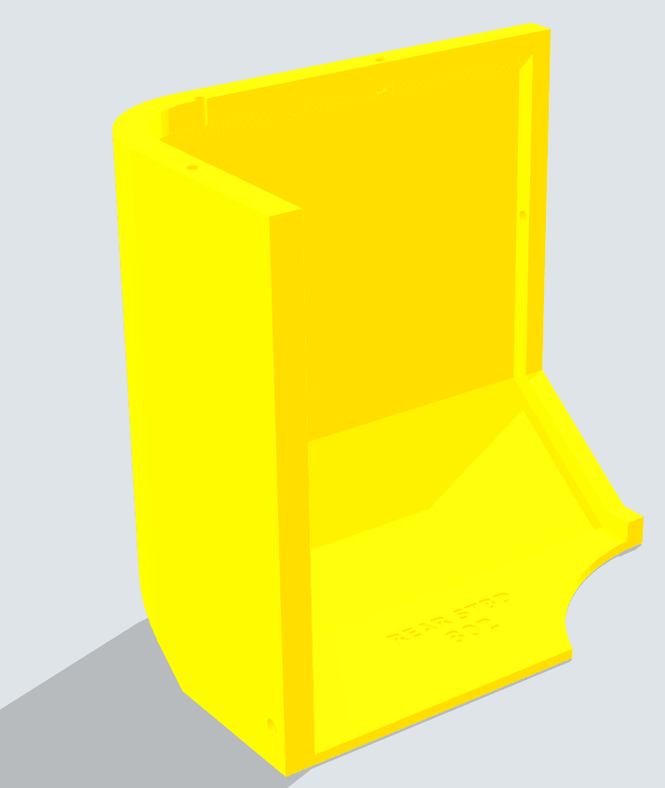
Images/Parts/802_rov_cowl_rear_stbd.png
