bgreig/TinkerSub/Images/Parts/803_rov_cowl_mid_port.png

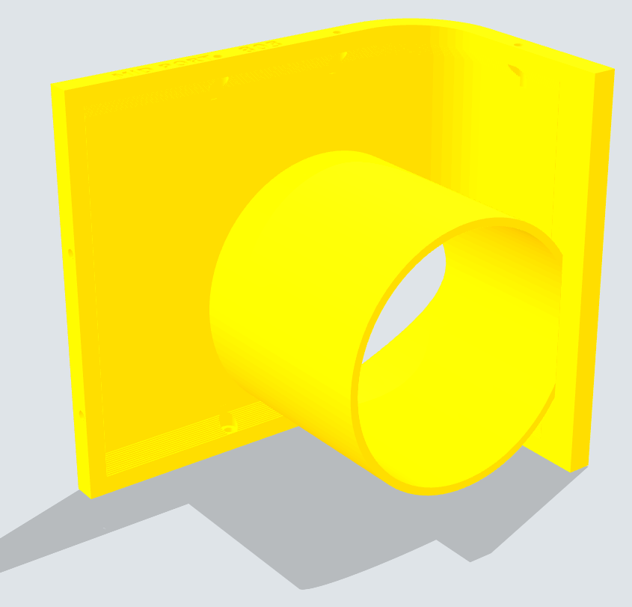
Images/Parts/803_rov_cowl_mid_port.png
