bgreig/TinkerSub/Images/Parts/804_rov_cowl_mid_stbd.png

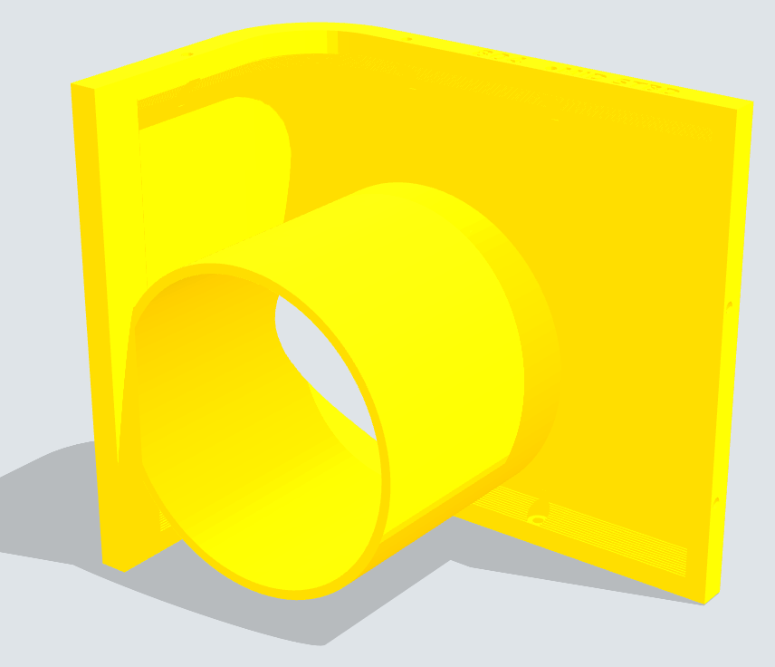
Images/Parts/804_rov_cowl_mid_stbd.png
