bgreig/TinkerSub/Images/Parts/805_rov_cowl_front_port.png

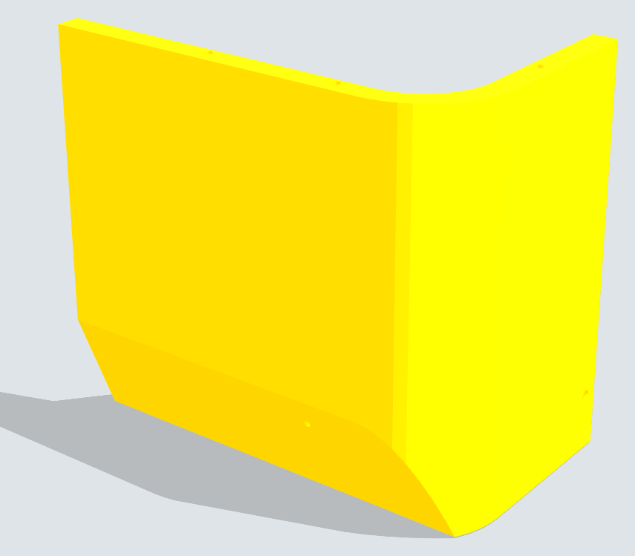
Images/Parts/805_rov_cowl_front_port.png
