bgreig/TinkerSub/Images/Parts/806_rov_cowl_front_stbd.png

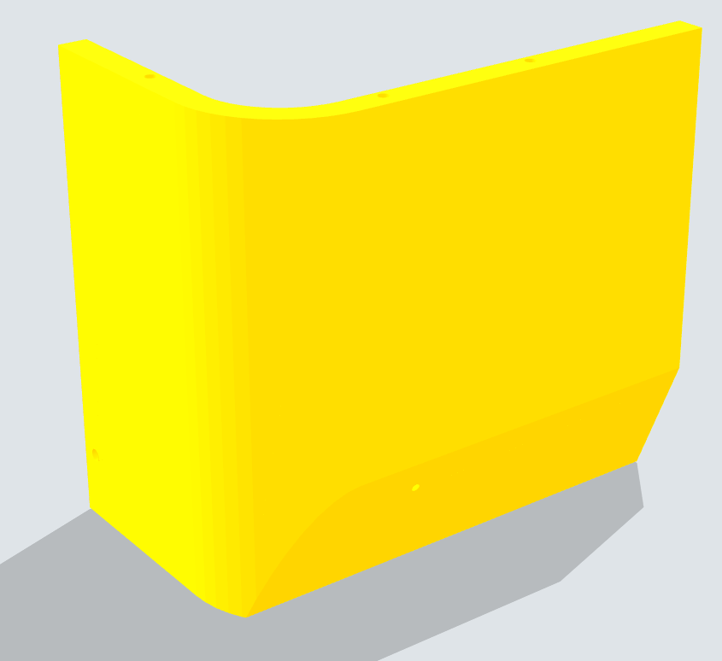
Images/Parts/806_rov_cowl_front_stbd.png
