bgreig/TinkerSub/CAD/STEP/TinkerSub_KB-1_assembly_mesh.3mf

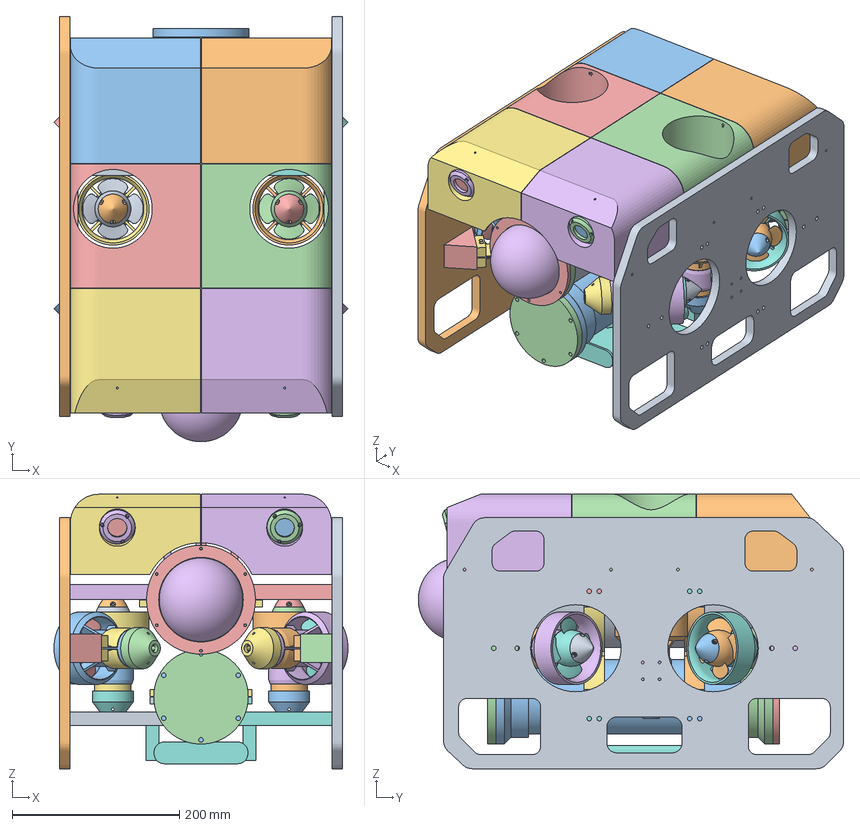
[picture p137: CAD file, 2026-10-26]
CAD/STEP/TinkerSub_KB-1_assembly_mesh.3mf
351.2 x 508.2 x 328.0 mm
hull/hull_1
hull/201_br_flange_rear_1
hull/202_rov_endcap_rear_5hole_1
hull/203_br_flange_front_dome_1
hull/204_dome_retaining_ring_1
hull/dome_1
sled/rod_1
sled/rod_2
sled/rod_3
sled/rod_4
battery/pod_1
battery/301_rov_pod_flange_3in_1
battery/302_rov_pod_endcap_3in_rear_1
thrusters/101_housing_no_foot_1
thrusters/102_tail_cone_comp_1
thrusters/prop_hub_1
thrusters/105_nose_cone_1
thrusters/106_pylon_clamp_1
thrusters/101_housing_no_foot_2
thrusters/102_tail_cone_comp_2
thrusters/prop_hub_2
thrusters/105_nose_cone_2
thrusters/106_pylon_clamp_2
thrusters/101_housing_no_foot_3
thrusters/102_tail_cone_comp_3
thrusters/prop_hub_3
thrusters/105_nose_cone_3
thrusters/106_pylon_clamp_3
thrusters/101_housing_no_foot_4
thrusters/102_tail_cone_comp_4
thrusters/prop_hub_4
thrusters/105_nose_cone_4
thrusters/106_pylon_clamp_4
thrusters/101_housing_no_foot_5
thrusters/102_tail_cone_comp_5
thrusters/prop_hub_5
thrusters/105_nose_cone_5
thrusters/106_pylon_clamp_5
thrusters/101_housing_no_foot_6
thrusters/102_tail_cone_comp_6
thrusters/prop_hub_6
thrusters/105_nose_cone_6
thrusters/106_pylon_clamp_6
frame/607_rov_bracket_corner_a_1
frame/608_rov_bracket_corner_b_1
frame/608_rov_bracket_corner_b_2
frame/607_rov_bracket_corner_a_2
frame/601_rov_station_top_port_1
frame/602_rov_station_top_stbd_1
frame/603_rov_station_mid_1
frame/604_rov_station_bot_port_1
frame/605_rov_station_bot_stbd_1
frame/601_rov_station_top_port_2
frame/602_rov_station_top_stbd_2
frame/603_rov_station_mid_2
frame/604_rov_station_bot_port_2
frame/605_rov_station_bot_stbd_2
cowl/801_rov_cowl_rear_port_1
cowl/802_rov_cowl_rear_stbd_1
cowl/803_rov_cowl_mid_port_1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
