bgreig/TinkerSub/CAD/rov_side_plate_port.stl

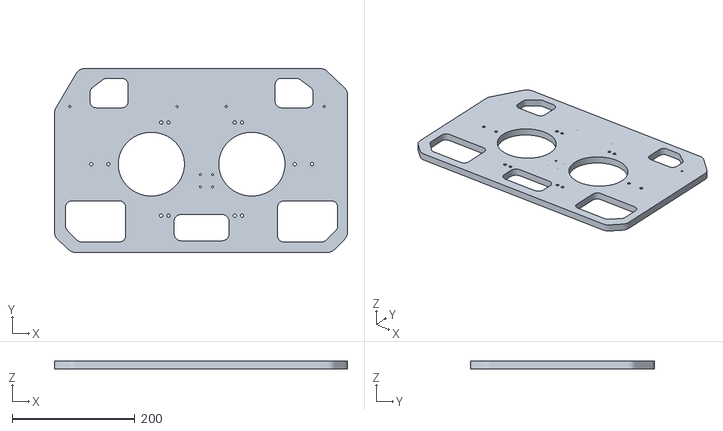
[picture p138: CAD file, 2026-10-21]
CAD/rov_side_plate_port.stl
478.0 x 300.0 x 12.7
