bgreig/TinkerSub/CAD/STEP/parts/606_rov_junction_deck.step

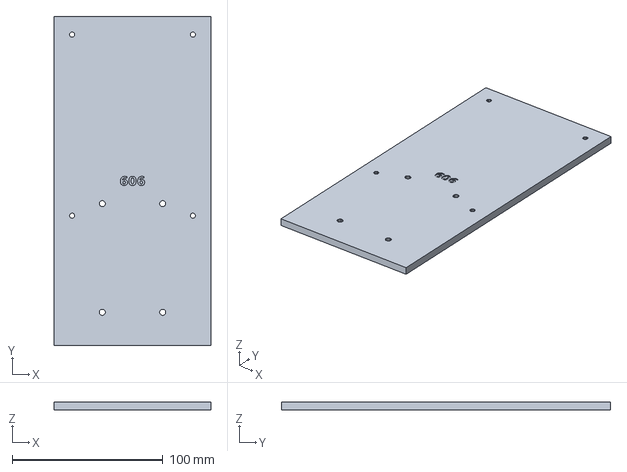
[picture p139: CAD file, 2026-10-26]
CAD/STEP/parts/606_rov_junction_deck.step
104.0 x 218.0 x 5.00 mm
