bgreig/TinkerSub/Source/inputs/New_parts/305_rov_cell_plate_8_v2.stl

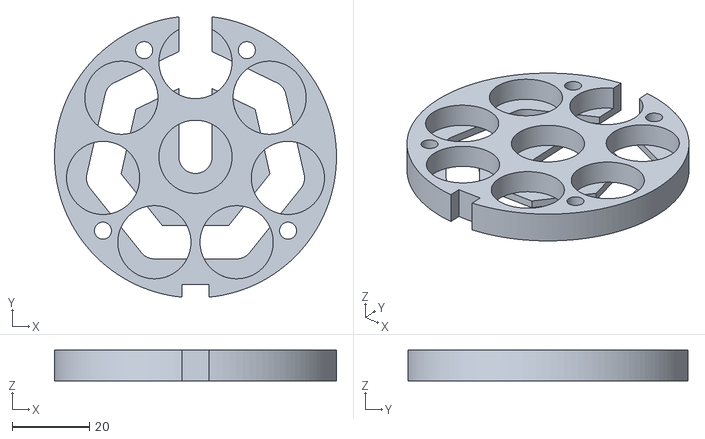
[picture p140: CAD file, 2026-10-22]
Source/inputs/New_parts/305_rov_cell_plate_8_v2.stl
72.9 x 72.5 x 8.00
