bgreig/TinkerSub/Source/inputs/prep/pantilt_cradle.stl

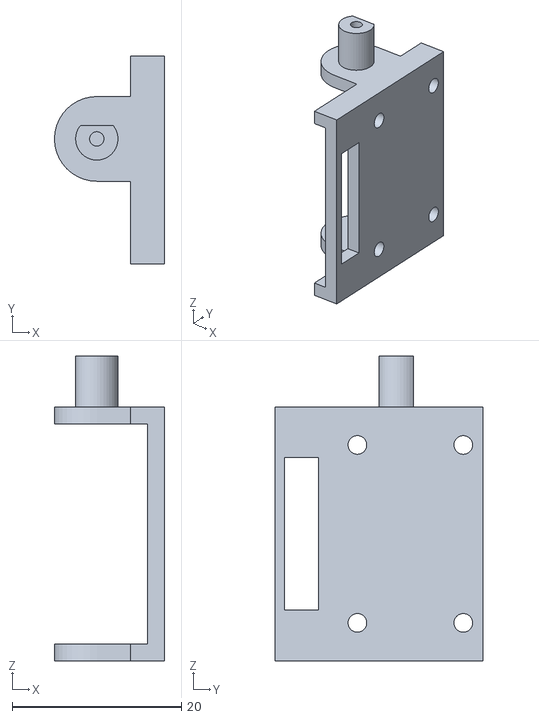
[picture p141: CAD file, 2026-10-22]
Source/inputs/prep/pantilt_cradle.stl
13.0 x 24.5 x 36.0
