bgreig/TinkerSub/Source/inputs/rov_project/camera_mount/m03r7-001-00a.stl

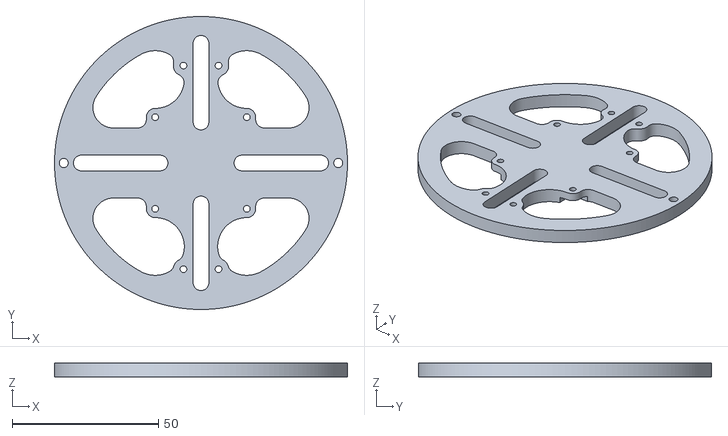
[picture p142: CAD file, 2026-10-22]
Source/inputs/rov_project/camera_mount/m03r7-001-00a.stl
100.3 x 100.3 x 4.76
