bgreig/TinkerSub/Source/inputs/rov_project/skid_bracket_body_x2.stl

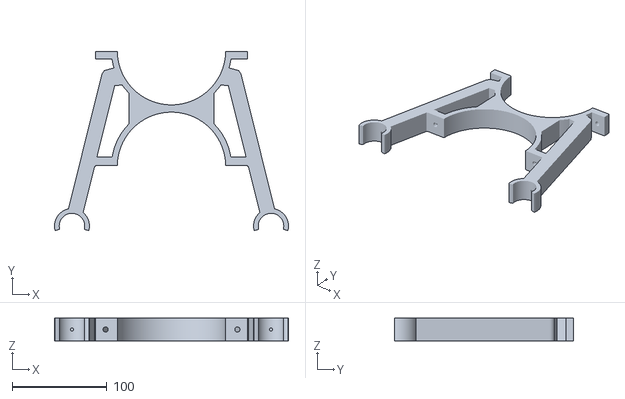
[picture p143: CAD file, 2026-10-22]
Source/inputs/rov_project/skid_bracket_body_x2.stl
246.9 x 189.0 x 24.0
