bgreig/TinkerSub/Source/inputs/src_parts/213_sled_rail_stbd.stl

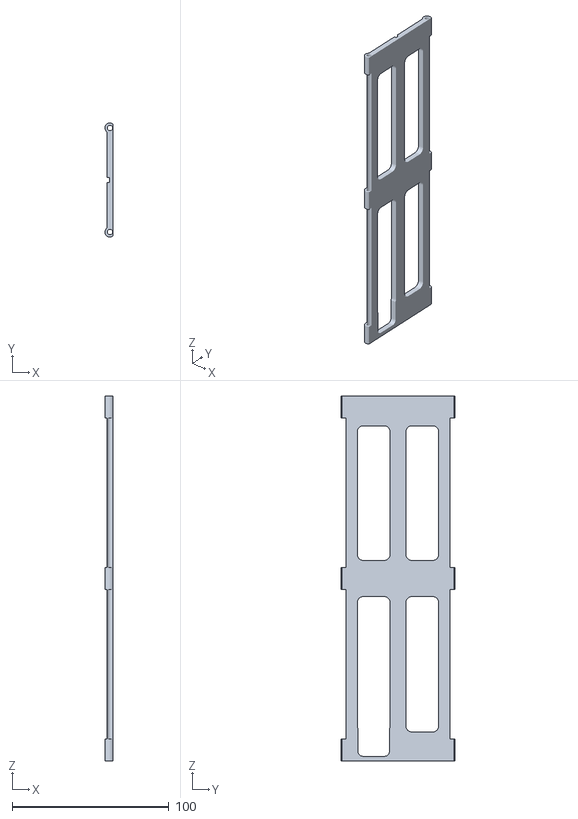
[picture p144: CAD file, 2026-10-22]
Source/inputs/src_parts/213_sled_rail_stbd.stl
5.20 x 72.9 x 233.0
