bgreig/TinkerSub/Source/inputs/step_supplied/306_rov_cell_spacer_3mm.step

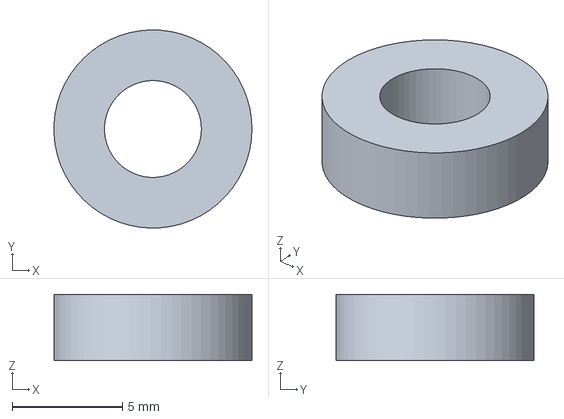
[picture p145: CAD file, 2026-10-21]
Source/inputs/step_supplied/306_rov_cell_spacer_3mm.step
8.99 x 9.00 x 3.00 mm
