bgreig/TinkerSub/STL/1_Thrusters/102_tail_cone_comp.stl

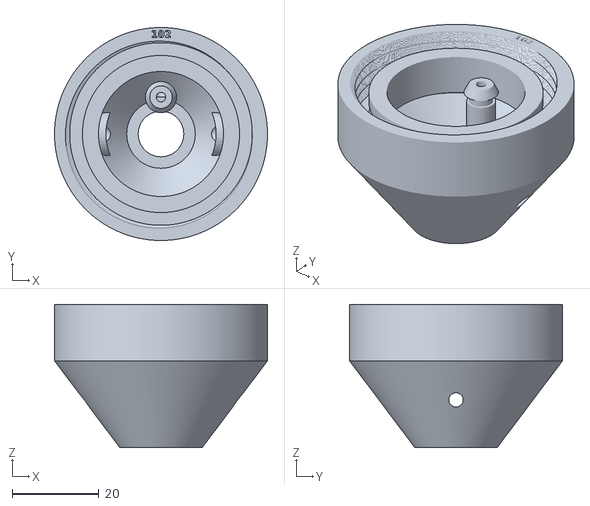
[picture p146: CAD file, 2026-10-25]
STL/1_Thrusters/102_tail_cone_comp.stl
49.1 x 49.1 x 33.0
