bgreig/TinkerSub/STL/2_Hull_and_sled/202_rov_endcap_rear_5hole.stl

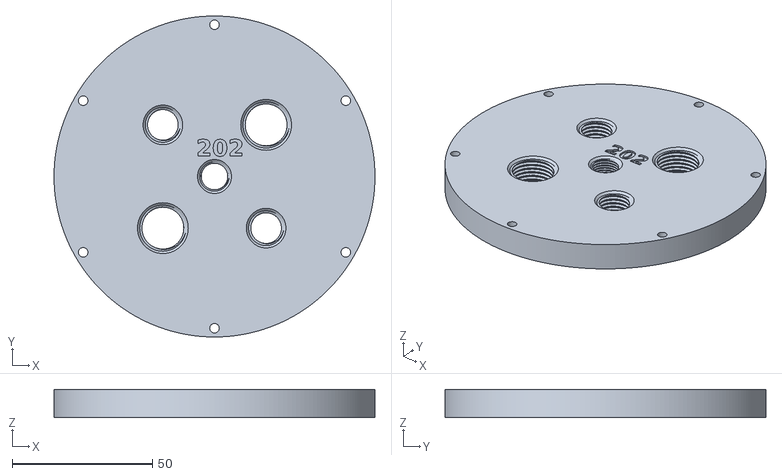
[picture p147: CAD file, 2026-10-30]
STL/2_Hull_and_sled/202_rov_endcap_rear_5hole.stl
114.3 x 114.3 x 10.0
