bgreig/TinkerSub/STL/3_Battery_pod/302_rov_pod_endcap_3in_rear.stl

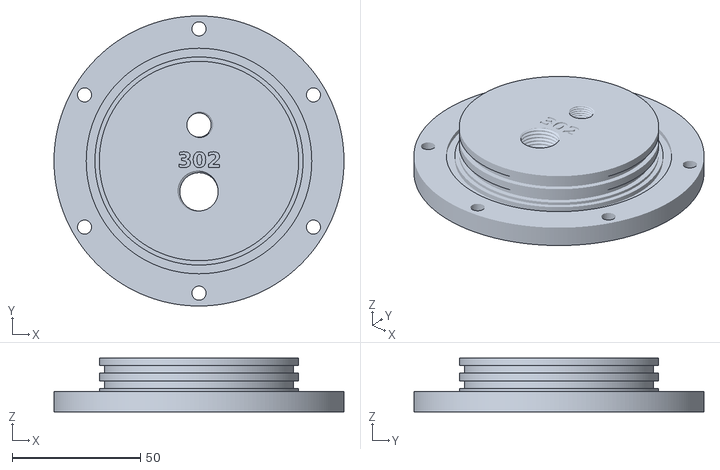
[picture p148: CAD file, 2026-11-03]
STL/3_Battery_pod/302_rov_pod_endcap_3in_rear.stl
112.9 x 112.9 x 21.0
