bgreig/TinkerSub/STL/4_Lights/401_rov_light_rear_body.stl

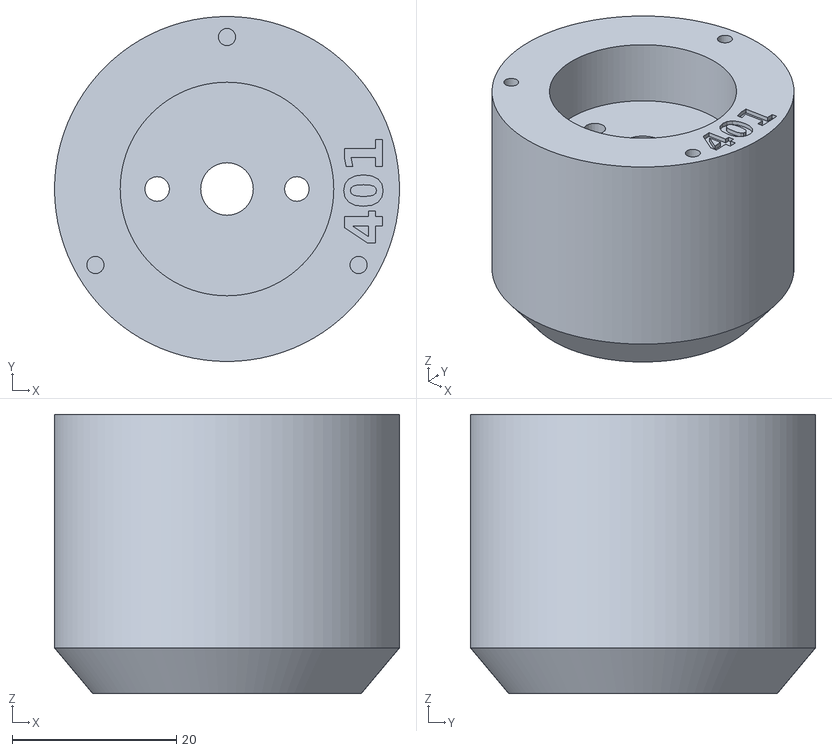
[picture p149: CAD file, 2026-10-23]
STL/4_Lights/401_rov_light_rear_body.stl
42.0 x 42.0 x 34.0
