bgreig/TinkerSub/STL/5_Junction_boxes/501_rov_junction_box.stl

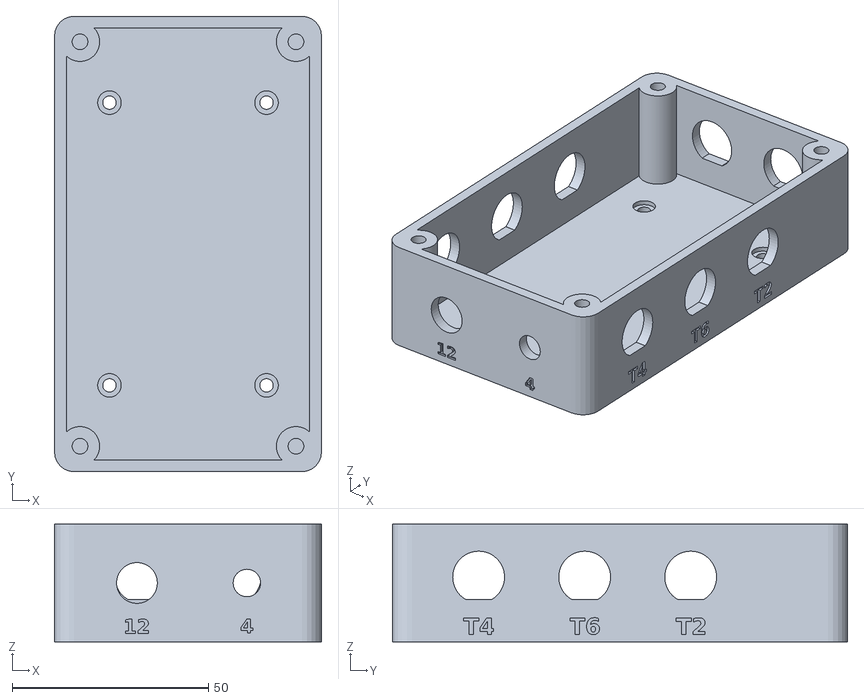
[picture p150: CAD file, 2026-10-21]
STL/5_Junction_boxes/501_rov_junction_box.stl
68.0 x 116.0 x 30.0
