bgreig/TinkerSub/STL/7_Belly_pan/701_rov_belly_pan.stl

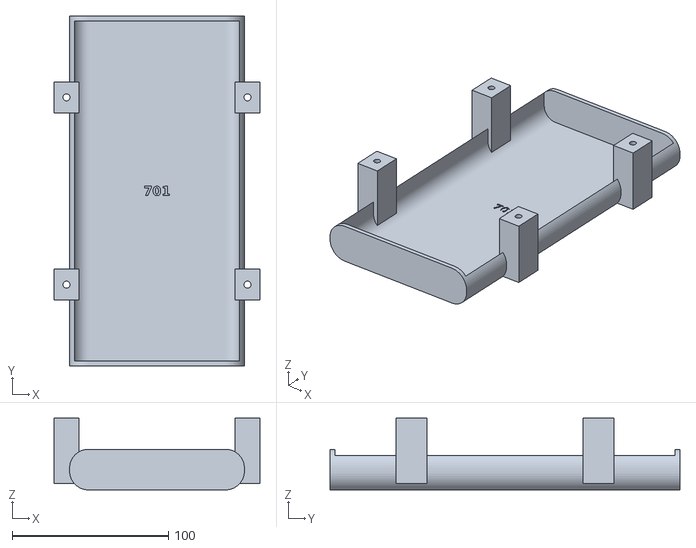
[picture p151: CAD file, 2026-10-23]
STL/7_Belly_pan/701_rov_belly_pan.stl
132.0 x 224.0 x 46.0
