bgreig/TinkerSub/STL/8_Top_cowl_YELLOW/802_rov_cowl_rear_stbd.stl

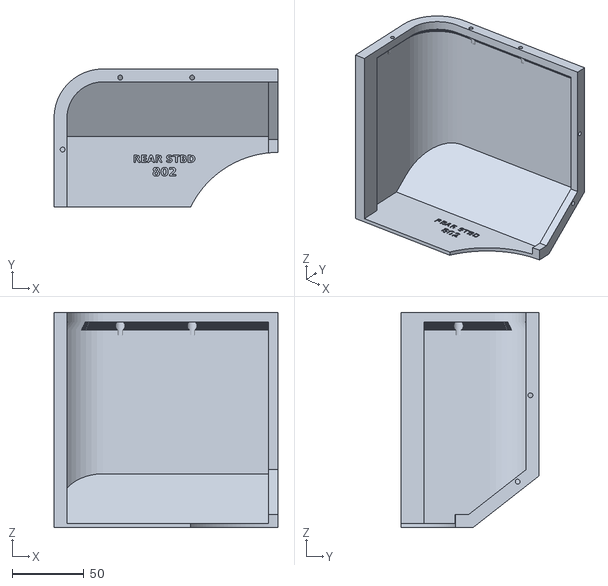
[picture p152: CAD file, 2026-10-23]
STL/8_Top_cowl_YELLOW/802_rov_cowl_rear_stbd.stl
155.7 x 96.0 x 149.7
