bgreig/TinkerSub/TinkerSub_KB-1_Reprint_2026-10-20.3mf

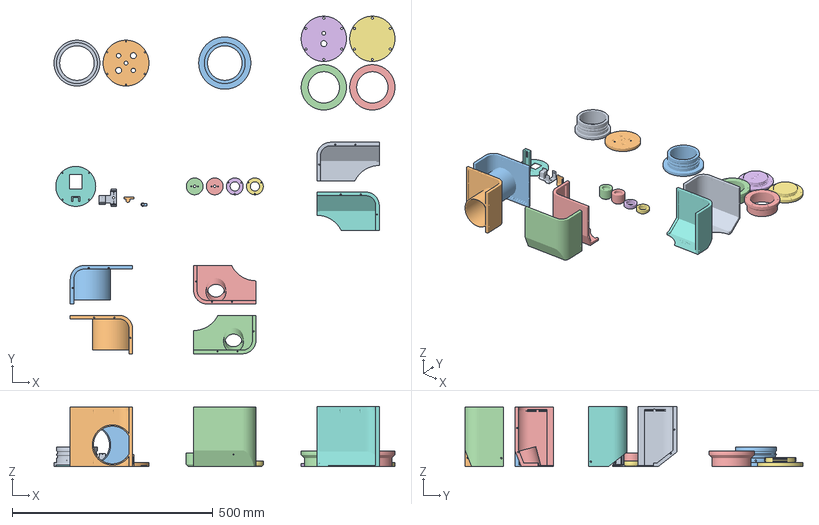
[picture p153: CAD file, 2026-11-03]
TinkerSub_KB-1_Reprint_2026-10-20.3mf
849.6 x 841.3 x 149.7 mm
201_br_flange_rear
202_rov_endcap_rear_5hole
203_br_flange_front_dome
301_rov_pod_flange_3in (1 of 2)
301_rov_pod_flange_3in (2 of 2)
302_rov_pod_endcap_3in_rear
303_rov_pod_endcap_3in_front
216_pantilt_base
217_pantilt_yoke
218_pantilt_cradle
219_pantilt_lever
401_rov_light_rear_body (1 of 2)
401_rov_light_rear_body (2 of 2)
402_rov_light_front_ring (1 of 2)
402_rov_light_front_ring (2 of 2)
801_rov_cowl_rear_port
802_rov_cowl_rear_stbd
803_rov_cowl_mid_port
804_rov_cowl_mid_stbd
805_rov_cowl_front_port
806_rov_cowl_front_stbd
