bgreig/TinkerSub/Source/inputs/prep/pantilt_yoke.stl

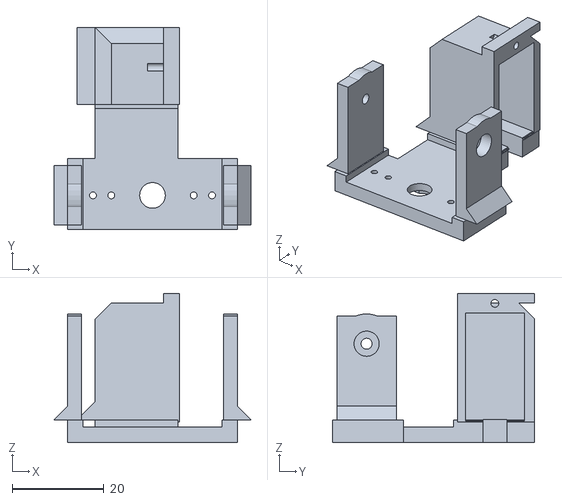
[picture p154: CAD file, 2026-10-22]
Source/inputs/prep/pantilt_yoke.stl
43.0 x 44.2 x 32.6
