bgreig/TinkerSub/Source/inputs/rov_project/dome_retaining_ring.step

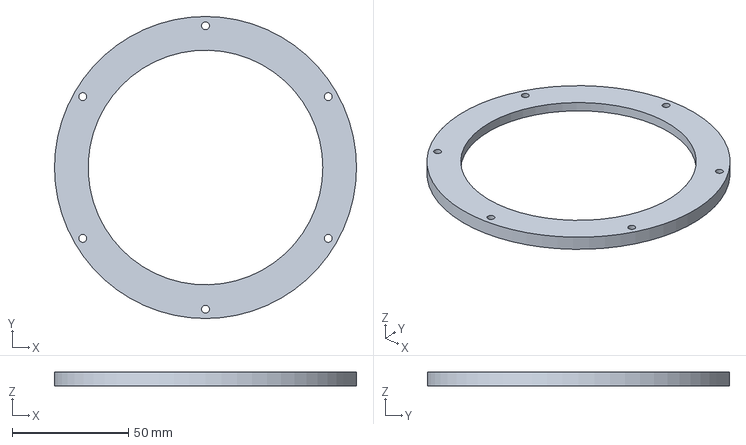
[picture p155: CAD file, 2026-10-22]
Source/inputs/rov_project/dome_retaining_ring.step
130.0 x 130.0 x 6.00 mm
