bgreig/TinkerSub/Source/inputs/step_supplied/215_sled_bulkhead_rear_v2.step

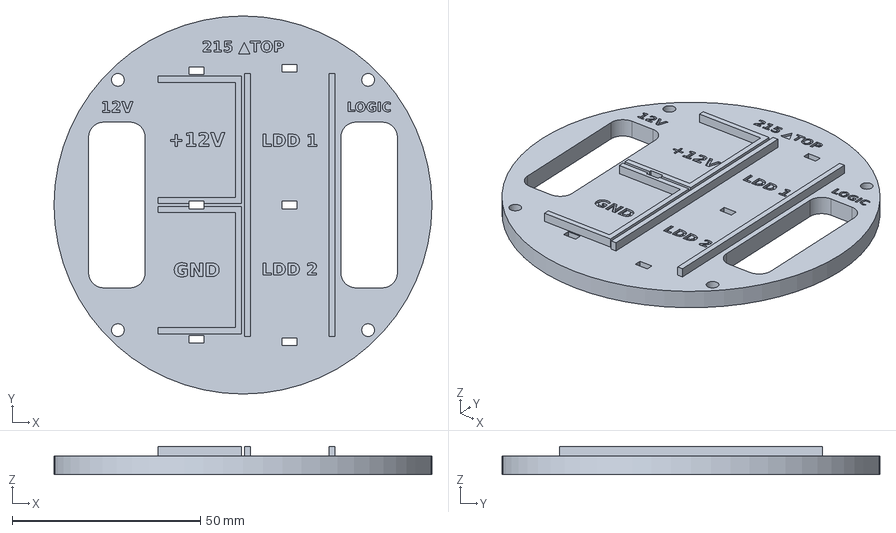
[picture p156: CAD file, 2026-10-21]
Source/inputs/step_supplied/215_sled_bulkhead_rear_v2.step
100.4 x 100.4 x 7.50 mm
