bgreig/TinkerSub/STL/1_Thrusters/103_prop_hub_RH.stl

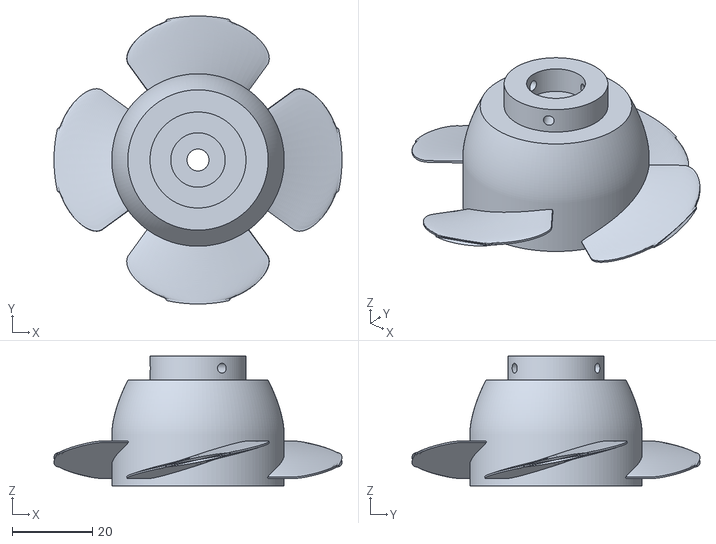
[picture p157: CAD file, 2026-10-21]
STL/1_Thrusters/103_prop_hub_RH.stl
72.0 x 72.0 x 32.4
