bgreig/TinkerSub/STL/3_Battery_pod/301_rov_pod_flange_3in.stl

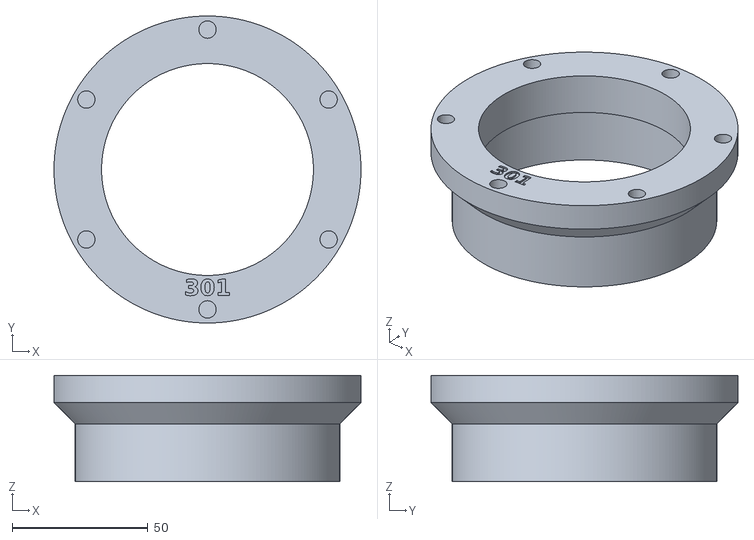
[picture p158: CAD file, 2026-10-21]
STL/3_Battery_pod/301_rov_pod_flange_3in.stl
112.9 x 112.9 x 39.0
