bgreig/TinkerSub/STL/4_Lights/402_rov_light_front_ring.stl

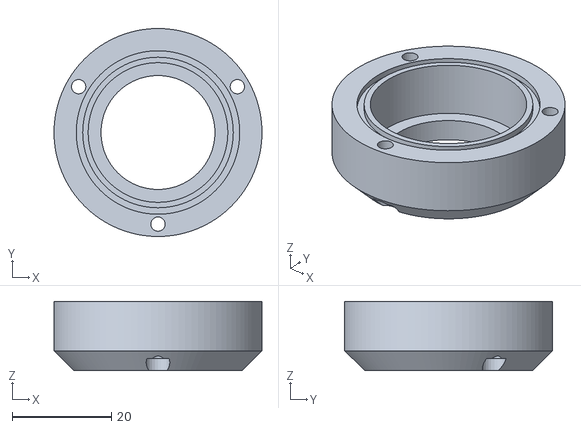
[picture p159: CAD file, 2026-10-21]
STL/4_Lights/402_rov_light_front_ring.stl
42.0 x 42.0 x 14.0
