bgreig/TinkerSub/STL/5_Junction_boxes/503_rov_junction_lid.stl

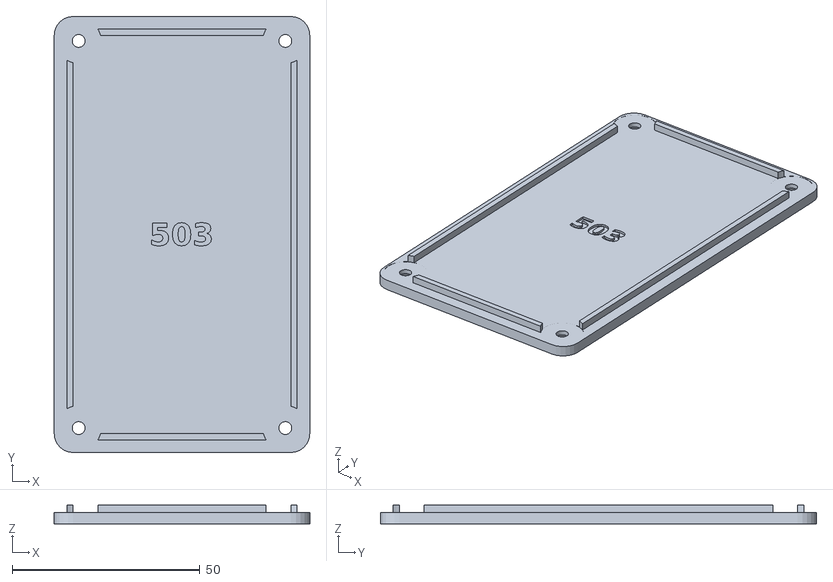
[picture p160: CAD file, 2026-10-21]
STL/5_Junction_boxes/503_rov_junction_lid.stl
68.0 x 116.0 x 5.00
