bgreig/TinkerSub/STL/6_Stations_and_brackets/602_rov_station_top_stbd.stl

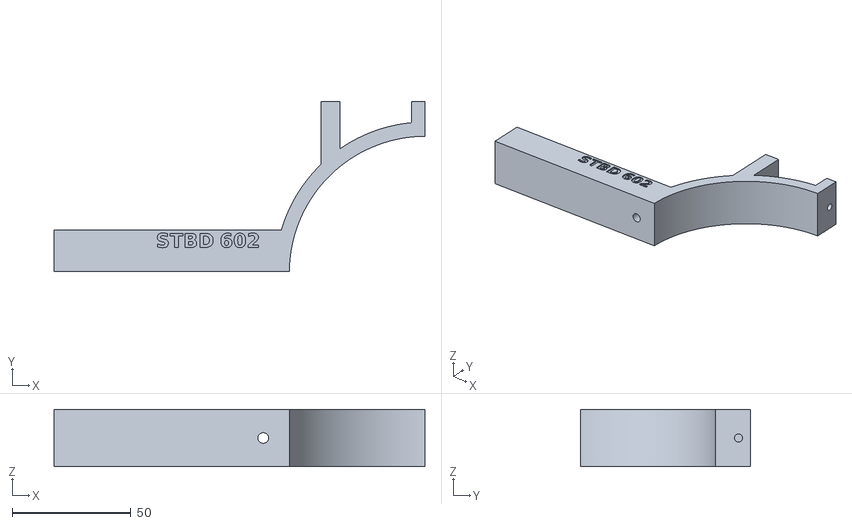
[picture p161: CAD file, 2026-10-23]
STL/6_Stations_and_brackets/602_rov_station_top_stbd.stl
156.2 x 71.5 x 24.0
