bgreig/TinkerSub/STL/8_Top_cowl_YELLOW/805_rov_cowl_front_port.stl

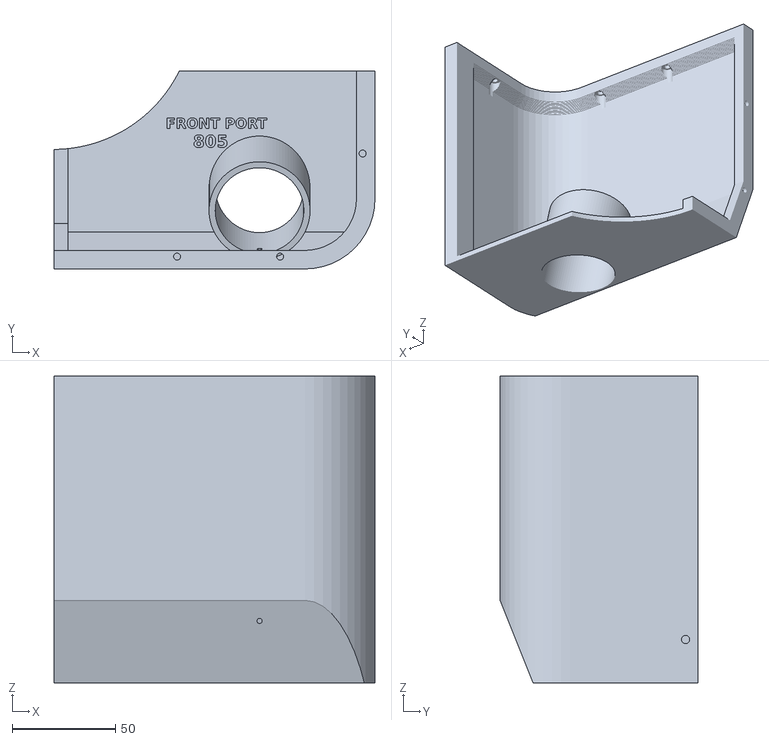
[picture p162: CAD file, 2026-10-23]
STL/8_Top_cowl_YELLOW/805_rov_cowl_front_port.stl
155.7 x 96.0 x 148.7
