bgreig/TinkerSub/TinkerSub_KB-1_Core.3mf

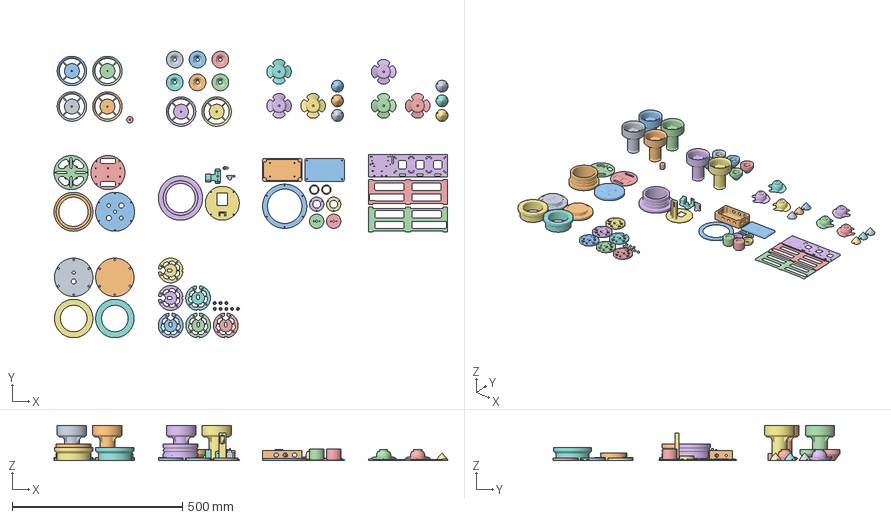
[picture p163: CAD file, 2026-11-03]
TinkerSub_KB-1_Core.3mf
1157.4 x 841.9 x 104.0 mm
101_housing_no_foot (1 of 6)
101_housing_no_foot (2 of 6)
101_housing_no_foot (3 of 6)
101_housing_no_foot (4 of 6)
107_coupler_gauge
101_housing_no_foot (5 of 6)
101_housing_no_foot (6 of 6)
102_tail_cone_comp (1 of 6)
102_tail_cone_comp (2 of 6)
102_tail_cone_comp (3 of 6)
102_tail_cone_comp (4 of 6)
102_tail_cone_comp (5 of 6)
102_tail_cone_comp (6 of 6)
103_prop_hub_RH (1 of 3)
103_prop_hub_RH (2 of 3)
103_prop_hub_RH (3 of 3)
105_nose_cone (1 of 6)
105_nose_cone (2 of 6)
105_nose_cone (3 of 6)
104_prop_hub_LH (1 of 3)
104_prop_hub_LH (2 of 3)
104_prop_hub_LH (3 of 3)
105_nose_cone (4 of 6)
105_nose_cone (5 of 6)
105_nose_cone (6 of 6)
201_br_flange_rear
202_rov_endcap_rear_5hole
207_sled_bulkhead_front
215_sled_bulkhead_rear_v2
203_br_flange_front_dome
216_pantilt_base
217_pantilt_yoke
218_pantilt_cradle
219_pantilt_lever
204_dome_retaining_ring
401_rov_light_rear_body (1 of 2)
401_rov_light_rear_body (2 of 2)
402_rov_light_front_ring (1 of 2)
402_rov_light_front_ring (2 of 2)
403_rov_light_spacer (1 of 2)
403_rov_light_spacer (2 of 2)
501_rov_junction_box
503_rov_junction_lid
212_sled_rail_port
213_sled_rail_stbd
214_sled_deck
301_rov_pod_flange_3in (1 of 2)
301_rov_pod_flange_3in (2 of 2)
302_rov_pod_endcap_3in_rear
303_rov_pod_endcap_3in_front
305_rov_cell_plate_8_v2 (1 of 6)
305_rov_cell_plate_8_v2 (2 of 6)
305_rov_cell_plate_8_v2 (3 of 6)
305_rov_cell_plate_8_v2 (4 of 6)
305_rov_cell_plate_8_v2 (5 of 6)
305_rov_cell_plate_8_v2 (6 of 6)
306_rov_cell_spacer_3mm (1 of 8)
306_rov_cell_spacer_3mm (2 of 8)
306_rov_cell_spacer_3mm (3 of 8)
306_rov_cell_spacer_3mm (4 of 8)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
