bgreig/TinkerSub/CAD/rov_side_plates_24x24_nest.stl

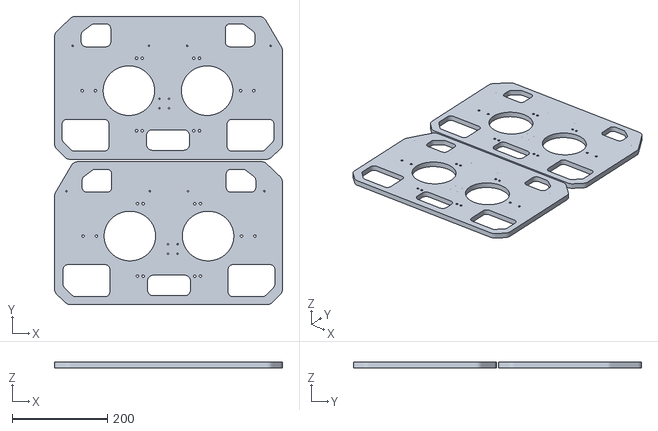
[picture p164: CAD file, 2026-10-21]
CAD/rov_side_plates_24x24_nest.stl
478.0 x 604.8 x 12.7
