bgreig/TinkerSub/Source/inputs/prep/pantilt_lever.stl

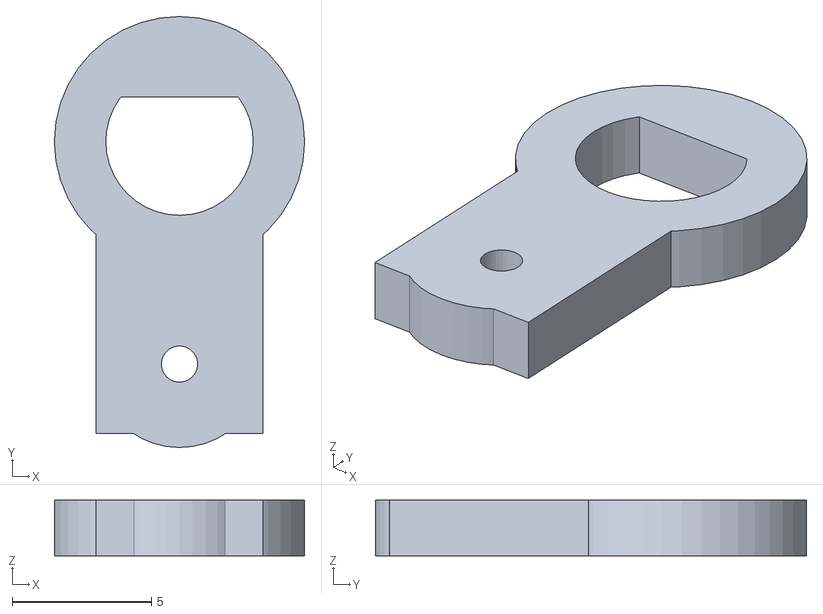
[picture p165: CAD file, 2026-10-22]
Source/inputs/prep/pantilt_lever.stl
9.00 x 15.5 x 2.00
