bgreig/TinkerSub/Source/inputs/rov_project/br_flange_front_dome.step

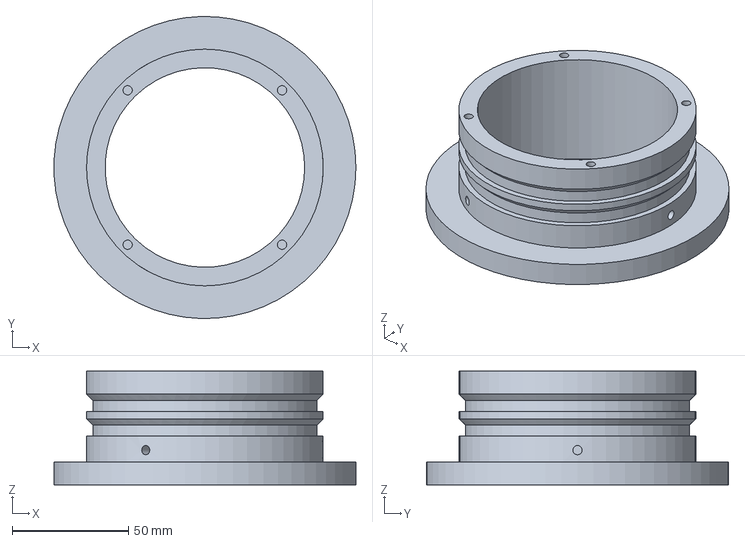
[picture p166: CAD file, 2026-10-22]
Source/inputs/rov_project/br_flange_front_dome.step
129.9 x 130.0 x 49.0 mm
