bgreig/TinkerSub/Source/inputs/step_supplied/214_sled_deck.step

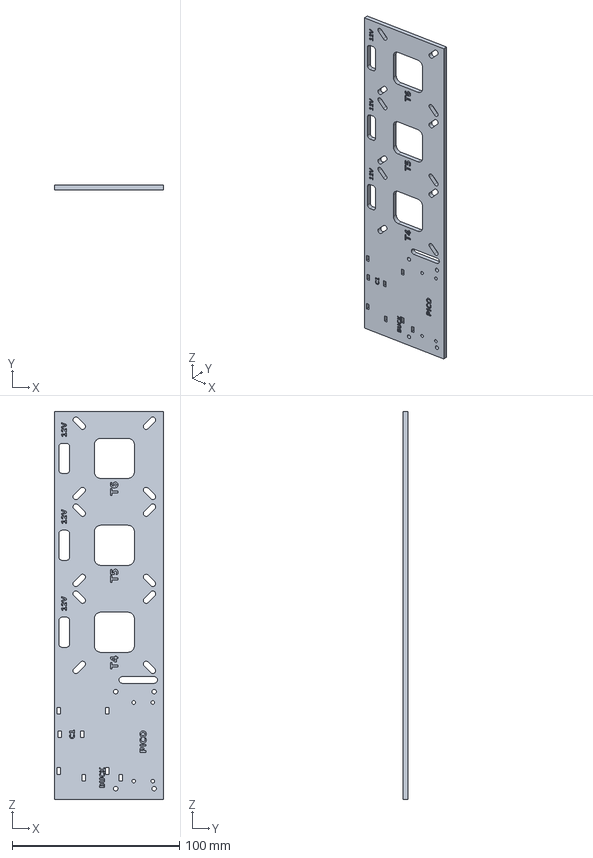
[picture p167: CAD file, 2026-10-21]
Source/inputs/step_supplied/214_sled_deck.step
65.3 x 3.00 x 232.0 mm
