bgreig/TinkerSub/STL/2_Hull_and_sled/216_pantilt_base.stl

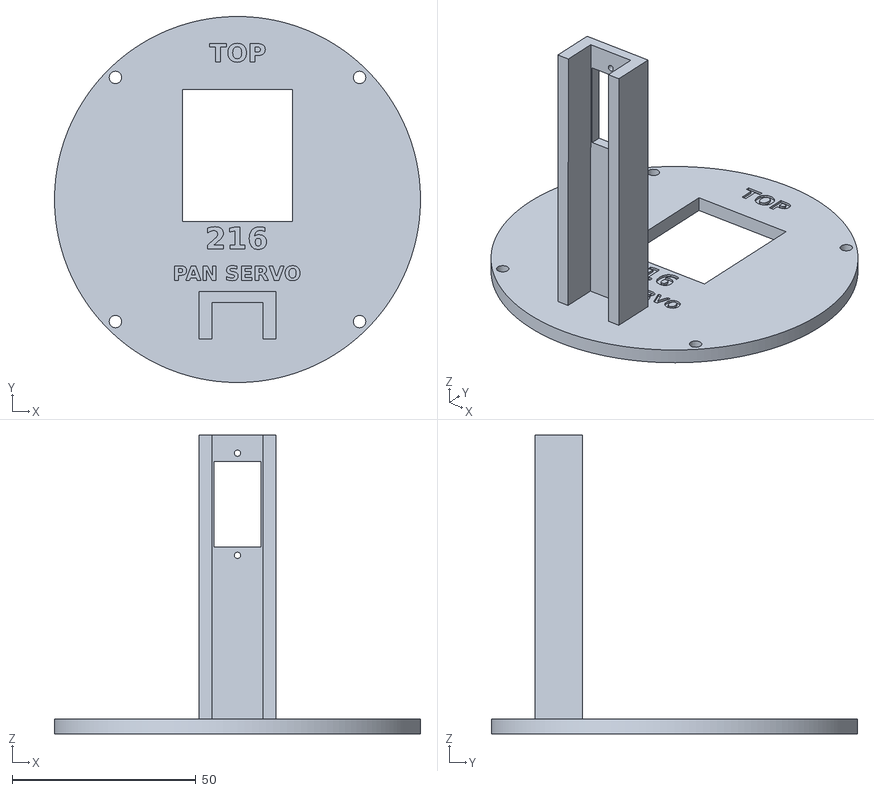
[picture p168: CAD file, 2026-10-21]
STL/2_Hull_and_sled/216_pantilt_base.stl
99.7 x 99.7 x 81.3
