bgreig/TinkerSub/STL/3_Battery_pod/303_rov_pod_endcap_3in_front.stl

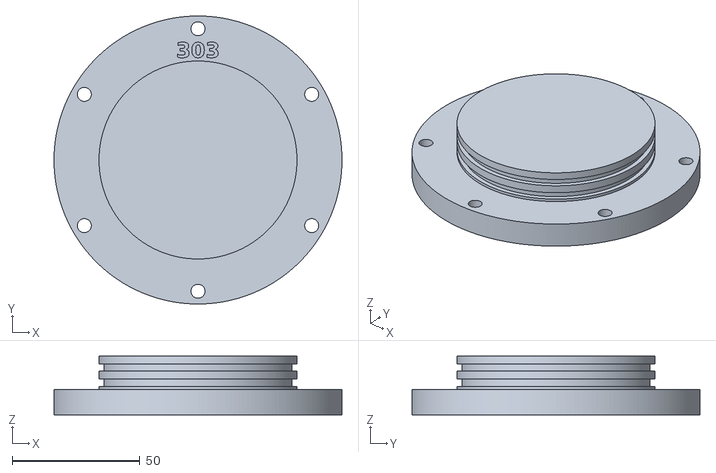
[picture p169: CAD file, 2026-10-21]
STL/3_Battery_pod/303_rov_pod_endcap_3in_front.stl
112.9 x 112.9 x 23.0
