bgreig/TinkerSub/STL/4_Lights/403_rov_light_spacer.stl

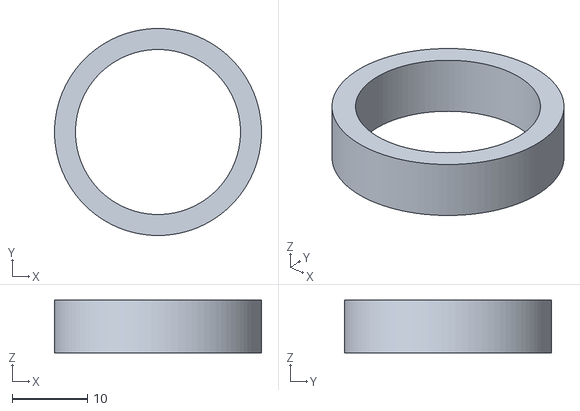
[picture p170: CAD file, 2026-10-21]
STL/4_Lights/403_rov_light_spacer.stl
27.6 x 27.6 x 7.00
