bgreig/TinkerSub/TinkerSub_KB-1_Frame.3mf

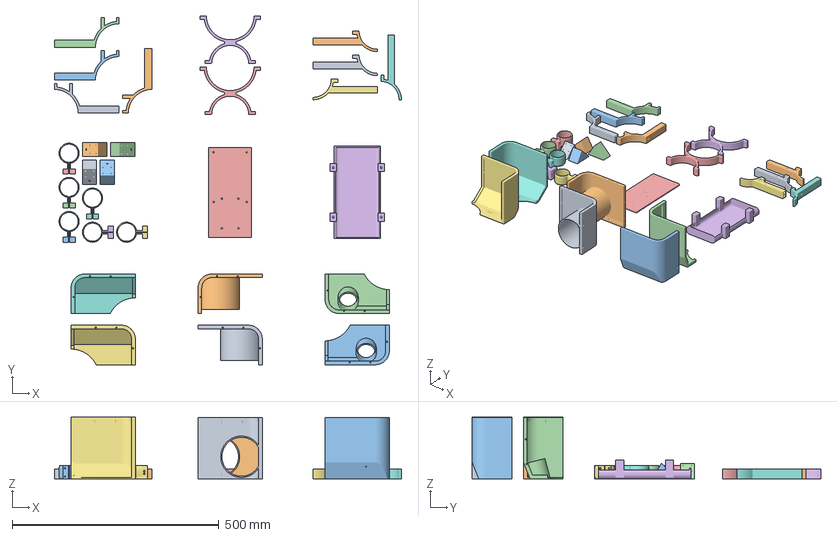
[picture p171: CAD file, 2026-10-26]
TinkerSub_KB-1_Frame.3mf
839.4 x 843.4 x 149.7 mm
601_rov_station_top_port (1 of 2)
601_rov_station_top_port (2 of 2)
602_rov_station_top_stbd (1 of 2)
602_rov_station_top_stbd (2 of 2)
603_rov_station_mid (1 of 2)
603_rov_station_mid (2 of 2)
604_rov_station_bot_port (1 of 2)
604_rov_station_bot_port (2 of 2)
605_rov_station_bot_stbd (1 of 2)
605_rov_station_bot_stbd (2 of 2)
106_pylon_clamp (1 of 6)
106_pylon_clamp (2 of 6)
106_pylon_clamp (3 of 6)
106_pylon_clamp (4 of 6)
106_pylon_clamp (5 of 6)
106_pylon_clamp (6 of 6)
607_rov_bracket_corner_a (1 of 2)
607_rov_bracket_corner_a (2 of 2)
608_rov_bracket_corner_b (1 of 2)
608_rov_bracket_corner_b (2 of 2)
606_rov_junction_deck
701_rov_belly_pan
801_rov_cowl_rear_port
802_rov_cowl_rear_stbd
803_rov_cowl_mid_port
804_rov_cowl_mid_stbd
805_rov_cowl_front_port
806_rov_cowl_front_stbd
