bgreig/TinkerSub/Source/inputs/rov_project/br_flange_rear.step

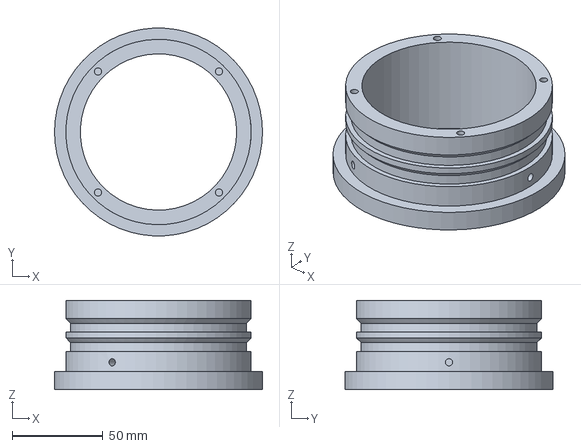
[picture p172: CAD file, 2026-10-22]
Source/inputs/rov_project/br_flange_rear.step
114.3 x 114.1 x 49.0 mm
