bgreig/TinkerSub/STL/1_Thrusters/107_coupler_gauge.stl

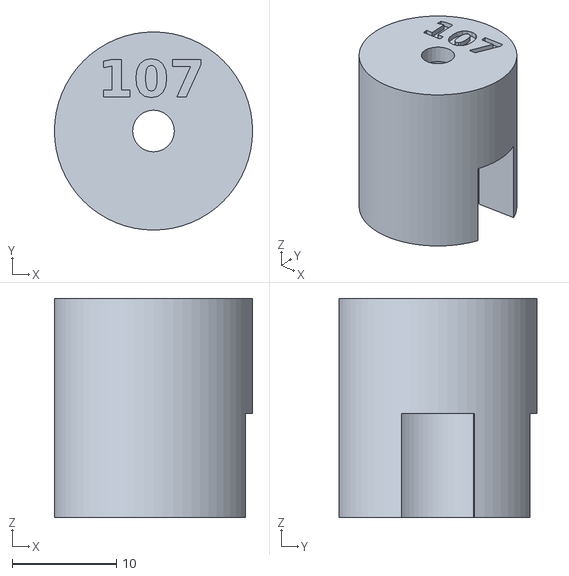
[picture p173: CAD file, 2026-10-21]
STL/1_Thrusters/107_coupler_gauge.stl
19.0 x 19.0 x 21.0
