bgreig/TinkerSub/STL/6_Stations_and_brackets/603_rov_station_mid.stl

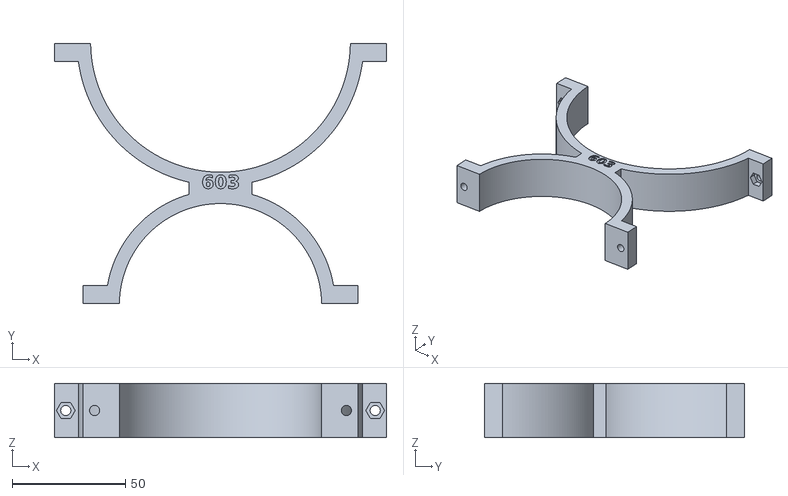
[picture p174: CAD file, 2026-10-21]
STL/6_Stations_and_brackets/603_rov_station_mid.stl
146.8 x 115.0 x 24.0
