bgreig/TinkerSub/STL/1_Thrusters/105_nose_cone.stl

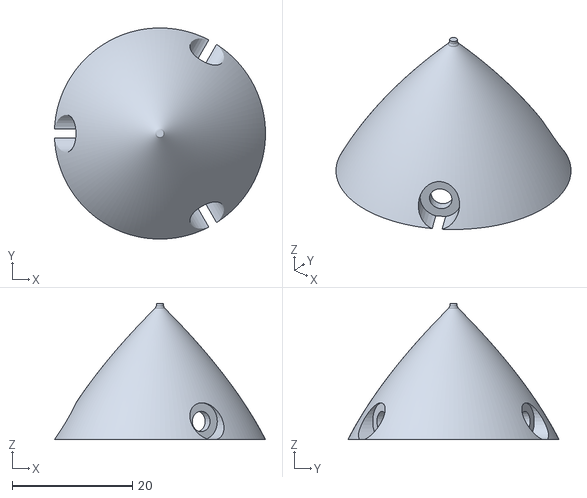
[picture p175: CAD file, 2026-10-21]
STL/1_Thrusters/105_nose_cone.stl
35.0 x 35.1 x 22.6
