bgreig/TinkerSub/STL/6_Stations_and_brackets/608_rov_bracket_corner_b.stl

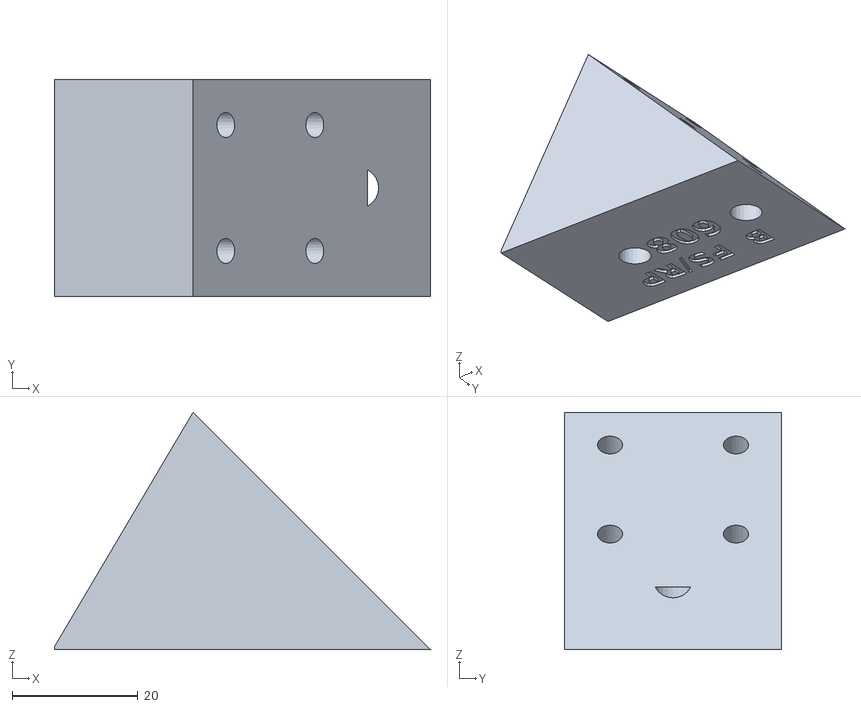
[picture p176: CAD file, 2026-10-21]
STL/6_Stations_and_brackets/608_rov_bracket_corner_b.stl
59.7 x 34.5 x 37.7
