bgreig/TinkerSub/Source/inputs/rov_project/ETRAY4-ROV-TRAY-R2.stl

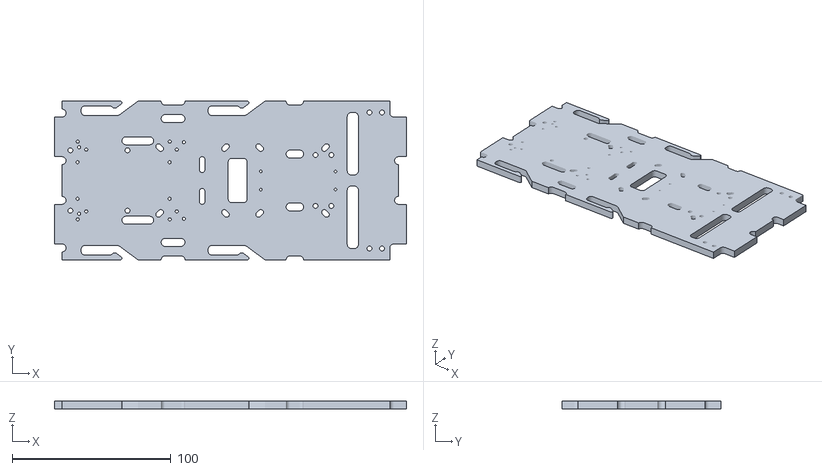
[picture p177: CAD file, 2026-10-22]
Source/inputs/rov_project/ETRAY4-ROV-TRAY-R2.stl
221.8 x 100.0 x 5.00
