bgreig/TinkerSub/STL/1_Thrusters/106_pylon_clamp.stl

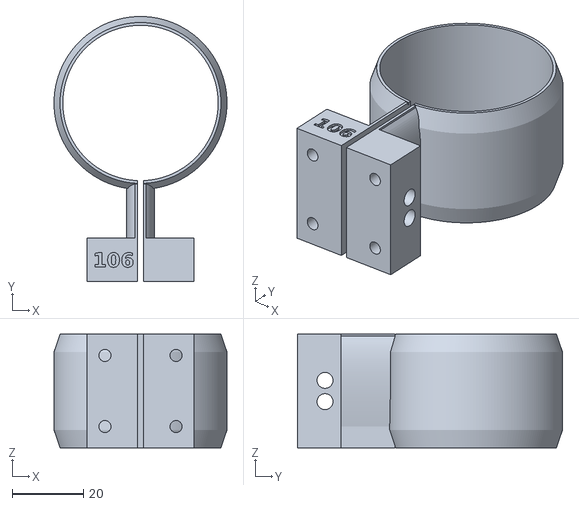
[picture p178: CAD file, 2026-10-21]
STL/1_Thrusters/106_pylon_clamp.stl
48.7 x 74.6 x 32.0
