bgreig/TinkerSub/STL/1_Thrusters/101_housing_no_foot.stl

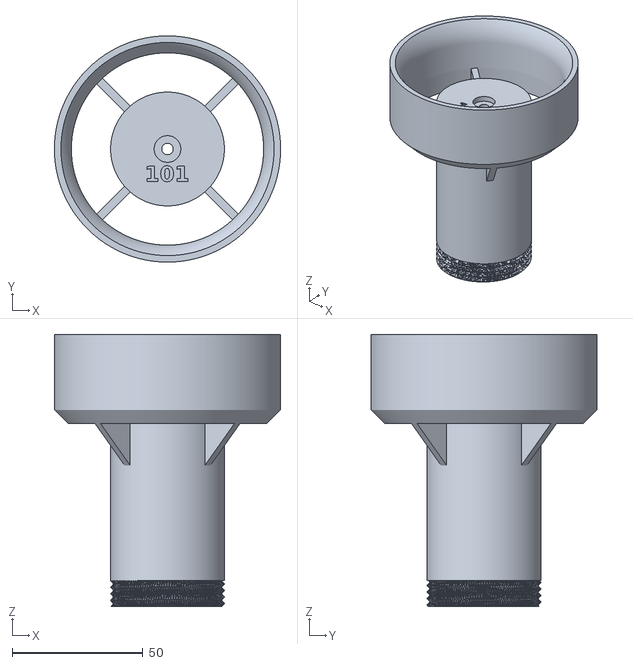
[picture p179: CAD file, 2026-10-21]
STL/1_Thrusters/101_housing_no_foot.stl
86.5 x 86.5 x 104.0
