bgreig/TinkerSub/STL/2_Hull_and_sled/217_pantilt_yoke.stl

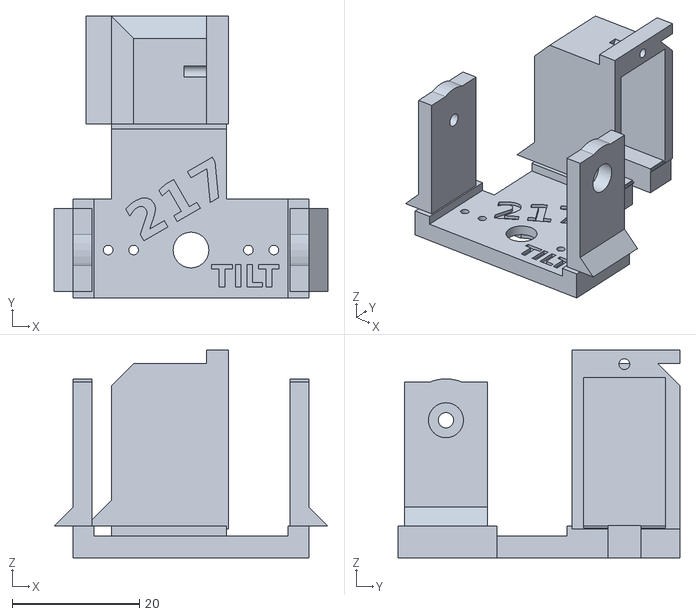
[picture p180: CAD file, 2026-10-21]
STL/2_Hull_and_sled/217_pantilt_yoke.stl
43.0 x 44.2 x 32.6
