bgreig/TinkerSub/STL/6_Stations_and_brackets/604_rov_station_bot_port.stl

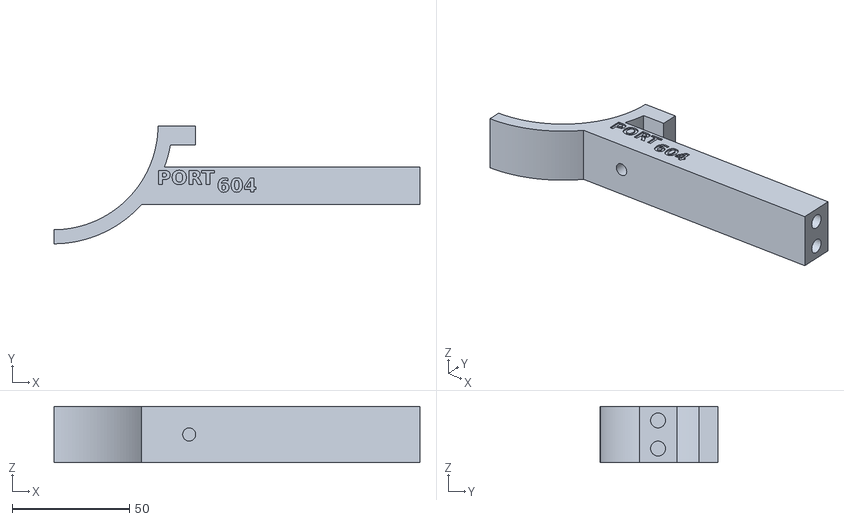
[picture p181: CAD file, 2026-10-21]
STL/6_Stations_and_brackets/604_rov_station_bot_port.stl
156.2 x 50.2 x 24.0
