bgreig/TinkerSub/STL/2_Hull_and_sled/219_pantilt_lever.stl

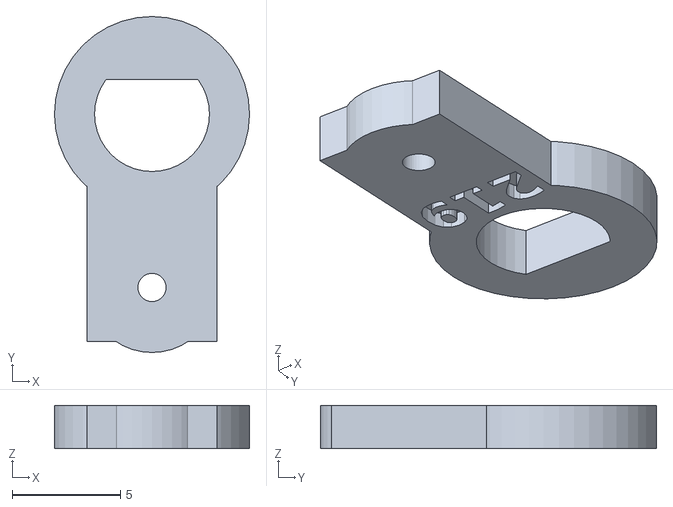
[picture p182: CAD file, 2026-10-21]
STL/2_Hull_and_sled/219_pantilt_lever.stl
9.00 x 15.5 x 2.00
