bgreig/TinkerSub/CAD/STEP/parts/302_rov_pod_endcap_3in_rear.step

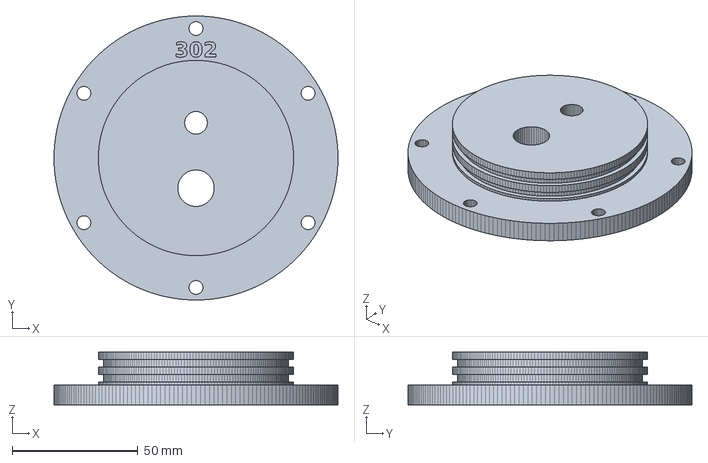
[picture p183: CAD file, 2026-10-21]
CAD/STEP/parts/302_rov_pod_endcap_3in_rear.step
112.9 x 112.9 x 21.0 mm
