bgreig/TinkerSub/CAD/STEP/parts/202_rov_endcap_rear_5hole.step

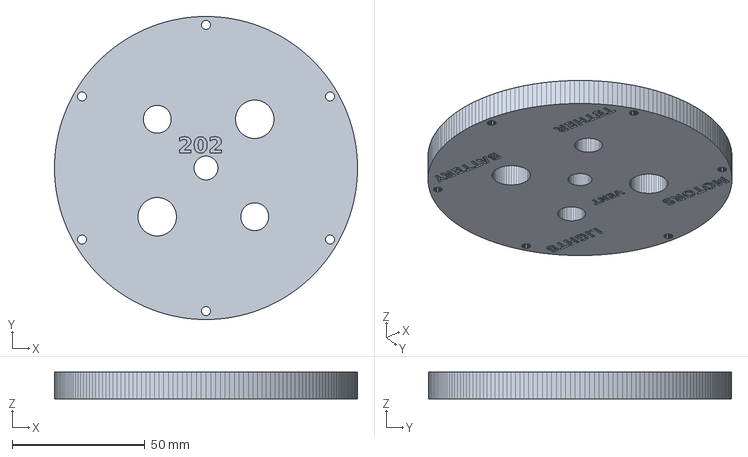
[picture p184: CAD file, 2026-10-21]
CAD/STEP/parts/202_rov_endcap_rear_5hole.step
114.3 x 114.3 x 10.0 mm
