bgreig/TinkerSub/(list of files, cad)

Other CAD files:
STL/6_Stations_and_brackets/606_rov_junction_deck.stl
CAD/rov_side_plate_stbd.stl
CAD/STEP/parts/802_rov_cowl_rear_stbd.step
Source/inputs/New_parts/213_sled_rail_stbd.stl
Source/inputs/src_parts/212_sled_rail_port.stl
STL/2_Hull_and_sled/204_dome_retaining_ring.stl
CAD/STEP/parts/801_rov_cowl_rear_port.step
Source/inputs/New_parts/212_sled_rail_port.stl
STL/1_Thrusters/104_prop_hub_LH.stl
STL/6_Stations_and_brackets/601_rov_station_top_port.stl
STL/8_Top_cowl_YELLOW/806_rov_cowl_front_stbd.stl
CAD/STEP/parts/602_rov_station_top_stbd.step
Source/inputs/New_parts/214_sled_deck.stl
Source/inputs/prep/pantilt_base.stl
Source/inputs/step_supplied/305_rov_cell_plate_8_v2.step
STL/2_Hull_and_sled/218_pantilt_cradle.stl
STL/8_Top_cowl_YELLOW/804_rov_cowl_mid_stbd.stl
CAD/STEP/parts/804_rov_cowl_mid_stbd.step
Source/inputs/New_parts/215_sled_bulkhead_rear_v2.stl
Source/inputs/prep/sled_rail_stbd.stl
Source/inputs/rov_project/br_endcap_rear.step
STL/2_Hull_and_sled/207_sled_bulkhead_front.stl
STL/8_Top_cowl_YELLOW/801_rov_cowl_rear_port.stl
CAD/STEP/parts/701_rov_belly_pan.step
Source/inputs/prep/sled_rail_port.stl
STL/2_Hull_and_sled/203_br_flange_front_dome.stl
STL/6_Stations_and_brackets/607_rov_bracket_corner_a.stl
STL/8_Top_cowl_YELLOW/803_rov_cowl_mid_port.stl
CAD/STEP/parts/401_rov_light_rear_body.step
Source/inputs/prep/rov_cell_plate_8_v2.stl
CAD/STEP/parts/805_rov_cowl_front_port.step
Source/inputs/prep/rov_cell_spacer_3mm.stl
STL/2_Hull_and_sled/201_br_flange_rear.stl
STL/6_Stations_and_brackets/605_rov_station_bot_stbd.stl
CAD/STEP/parts/601_rov_station_top_port.step
Source/inputs/prep/sled_deck.stl
CAD/STEP/parts/803_rov_cowl_mid_port.step
Source/inputs/prep/sled_bulkhead_rear_v2.stl
CAD/STEP/parts/806_rov_cowl_front_stbd.step
CAD/STEP/parts/204_dome_retaining_ring.step
CAD/STEP/parts/608_rov_bracket_corner_b.step
CAD/STEP/parts/604_rov_station_bot_port.step
CAD/STEP/parts/106_pylon_clamp.step
CAD/STEP/parts/212_sled_rail_port.step
CAD/STEP/parts/218_pantilt_cradle.step
CAD/STEP/parts/217_pantilt_yoke.step
CAD/STEP/parts/501_rov_junction_box.step
CAD/STEP/parts/503_rov_junction_lid.step
CAD/STEP/parts/107_coupler_gauge.step
CAD/STEP/parts/303_rov_pod_endcap_3in_front.step
CAD/STEP/parts/607_rov_bracket_corner_a.step
CAD/STEP/parts/403_rov_light_spacer.step
CAD/STEP/parts/402_rov_light_front_ring.step
CAD/STEP/parts/901_rov_side_plate_port.step
CAD/STEP/parts/301_rov_pod_flange_3in.step
CAD/STEP/parts/603_rov_station_mid.step
CAD/STEP/parts/219_pantilt_lever.step
CAD/STEP/parts/213_sled_rail_stbd.step
CAD/STEP/parts/216_pantilt_base.step
CAD/STEP/parts/605_rov_station_bot_stbd.step
CAD/STEP/parts/902_rov_side_plate_stbd.step
CAD/rov_side_plate_port.dxf
CAD/rov_side_plate_stbd.dxf
CAD/rov_side_plates_24x24_nest.dxf
Source/inputs/rov_project/br_endcap_rear.stl
Source/inputs/rov_project/br_flange_front_dome.stl
Source/inputs/rov_project/br_flange_rear.stl
Source/inputs/rov_project/dome_retaining_ring.stl
