bgreig/TinkerSub/Images/Assembly_steps/cowl.png

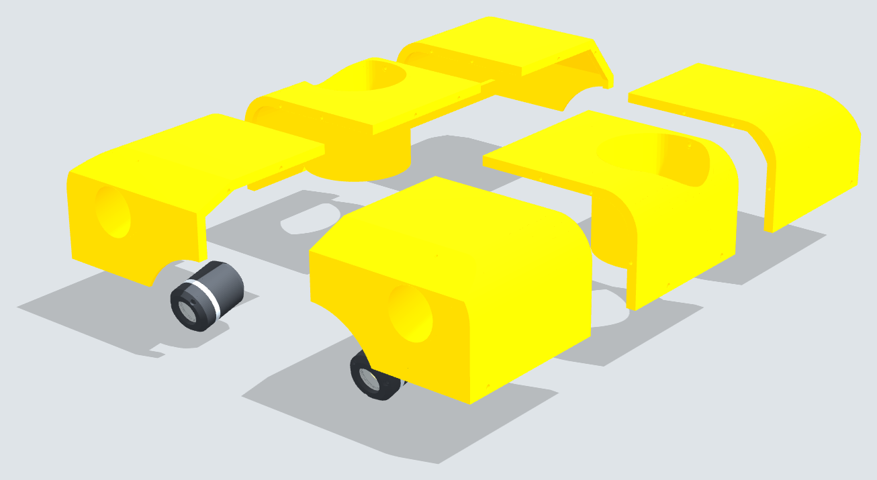
Images/Assembly_steps/cowl.png
