bgreig/TinkerSub/Images/Electronics/arm_and_servo_wiring.png

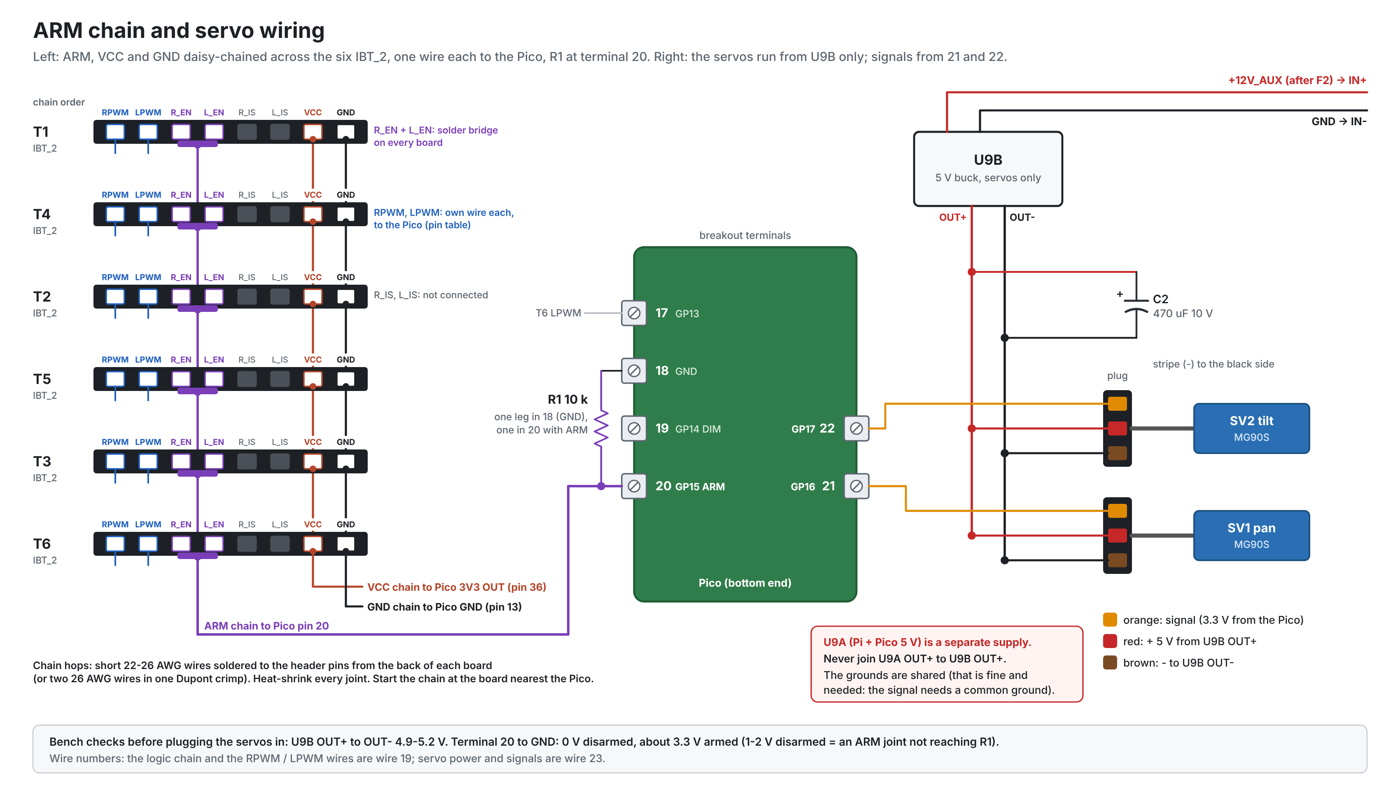
Images/Electronics/arm_and_servo_wiring.png
