bgreig/TinkerSub/Images/Electronics/wiring_diagram.png

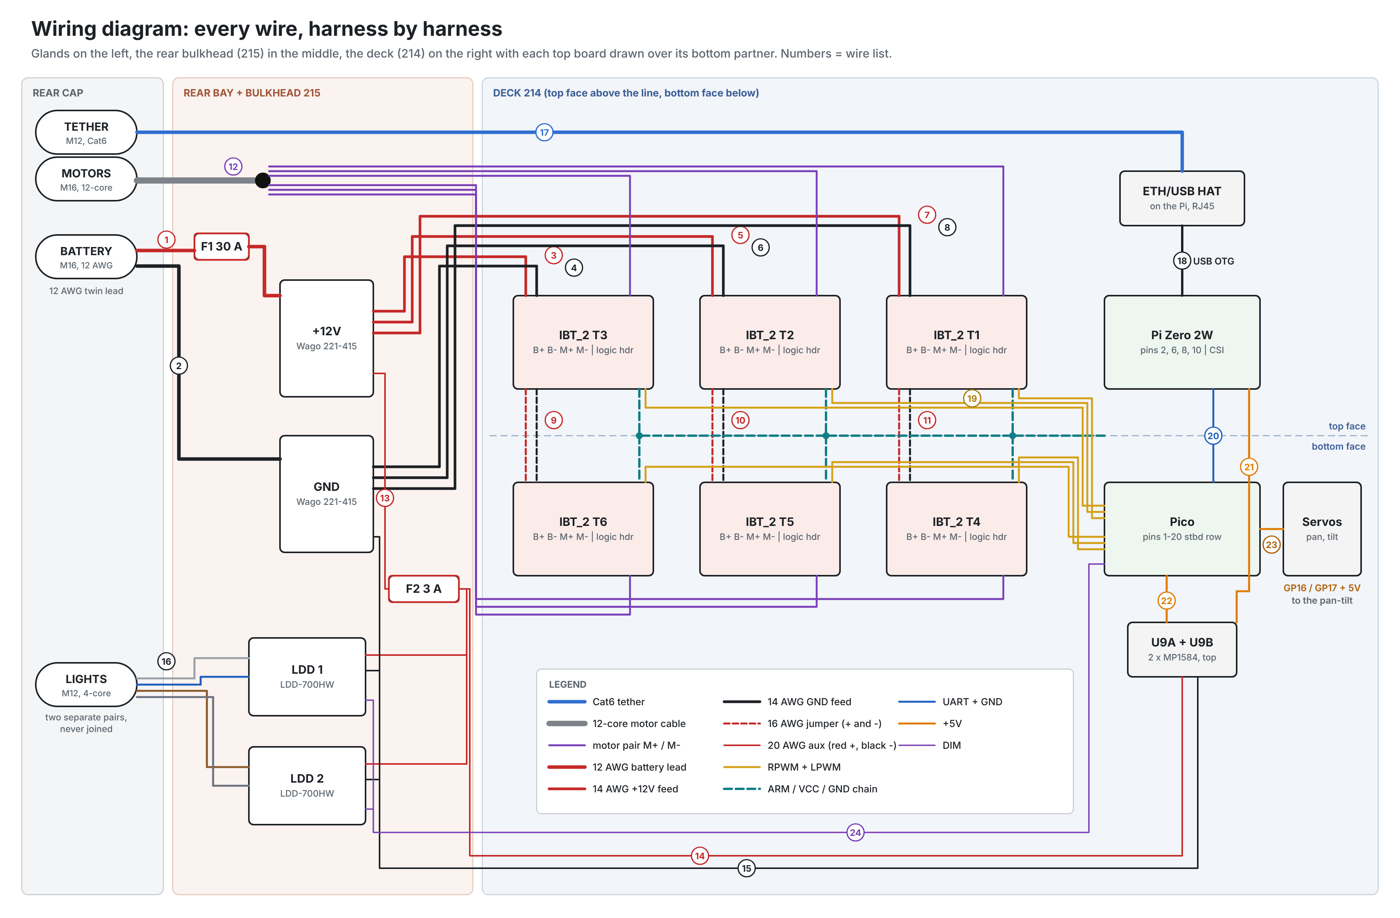
Images/Electronics/wiring_diagram.png
