bgreig/TinkerSub/(commit log)

2026-10-21 TinkerSub KB-1: first public release
    [101_housing_no_foot.stl, 102_tail_cone_comp.stl, 103_prop_hub_RH.stl, 104_prop_hub_LH.stl, 105_nose_cone.stl, 106_pylon_clamp.step, 106_pylon_clamp.stl, 107_coupler_gauge.step]
2026-10-22 Prepare TinkerSub KB-1 for release
    - Add the battery pack build guide (docs/Battery_Pack_Build.md); it was a
    private link. Pack tie rods corrected to ~225 mm.
    - Add license texts: LICENSE (CERN-OHL-S-2.0), LICENSES/ (CC BY-SA 4.0, MIT).
    - Complete Source/: all modules the generators import, input parts,
    requirements.txt and Source/README.md. A clean copy rebuilds all 45
    printed parts to match STL/.
    - Rename 207_m03r7-001-00a to 207_sled_bulkhead_front (same part).
    - Remove local paths and private references from the guide, firmware
    comments and CAD notes; drop the outdated README.txt.
    - Add CONTRIBUTING.md, issue templates and CHANGELOG.md.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
    [207_sled_bulkhead_front.stl, 212_sled_rail_port.stl, 213_sled_rail_stbd.stl, 214_sled_deck.stl, 215_sled_bulkhead_rear_v2.stl, 305_rov_cell_plate_8_v2.stl, BOM_hardware.csv, BOM_printed_parts.csv]
2026-10-22 Redraw the side-plate figures; make guide-only rebuilds reproducible
    The template-tile, finished-plate and 24 x 24 sheet figures in guide
    section 6 still showed the rear cowl-foot hole at its old position.
    They are now generated from the current plate CAD by Source/plate_figs.py.
    Source/guide_images_from_pdf.py recovers the guide images that are not
    shipped in the package (label close-ups, Appendix B renders) from the
    previous guide, so prep_guide_inputs.py can rebuild the guide after a
    text-only change. It replaces the old label extraction, which put three
    of the label close-ups under the wrong names.
    Only the three figures changed in the guide (83 pages, text identical).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
    [build_guide_final.py, plate_figs.py]
2026-10-22 Source: folders by job, one build entry point, full rebuild check
    Source/ is now organised by what each script does (geometry/, assembly/,
    outputs/, checks/, guide/, render/, inputs/) with one entry point:
    python3 Source/build.py all # parts, plates, 3mf, figures, scenes,
    # renders, guide, then check
    python3 Source/build.py install # copy what changed into the repo
    check compares every generated file with the repository and tells real
    changes from metadata (3MF IDs, PDF/DXF dates, STEP headers, float
    rounding). A clean checkout rebuilds with 0 changed files.
    Fixes found while making the build reproducible:
    - export_v6.py wrote the 303 pod fr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
    [212_sled_rail_port.stl, 213_sled_rail_stbd.stl, 214_sled_deck.step, 214_sled_deck.stl, 215_sled_bulkhead_rear_v2.step, 215_sled_bulkhead_rear_v2.stl, 305_rov_cell_plate_8_v2.step, 305_rov_cell_plate_8_v2.stl]
2026-10-23 Fastener audit: check every screw joint in every build; fix the joints that didn't fit
    New Source/checks/fastener_check.py (with holes.py) follows every screw hole in
    the assembled model through every part and checks it against the new table
    Source/assembly/fasteners.py: the screw must get in, reach thread, not bottom
    out, and have room for its head, nut and key; every joint must be in the table
    and the shopping list and guide text must agree with it. It runs at the end of
    `build.py parts` and stops the build on any error (131 errors on the old
    source, 0 now).
    Fixed:
    - 701 belly pan: hanger holes were blind; now through, M4 x 50
    - 601/602: arm inserts 0.75 mm off the plate holes; centre rib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
    [401_rov_light_rear_body.step, 401_rov_light_rear_body.stl, 601_rov_station_top_port.step, 601_rov_station_top_port.stl, 602_rov_station_top_stbd.step, 602_rov_station_top_stbd.stl, 701_rov_belly_pan.step, 701_rov_belly_pan.stl]
2026-10-23 Guide: gauge the bare coupler, then fit the stud; tighten the guide-text check
    Section 7 had the M5 stud and jam nut fitted before the coupler gauge, but
    the stud hits the gauge's ceiling (4 mm hole) and sets the coupler too low.
    Now: gauge the bare coupler, then the stud. Picture page nose screws M3 x 8.
    The fastener check's guide-text rule missed a stale size before a full stop
    and let a joint size pass as any bought-part screw of the same size.
    Claude-Session: https://claude.ai/code/session_01DmMGh7CZNBNz8xkCCRTAbV
    [build_guide_final.py]
2026-10-24 Add a security policy
    SECURITY.md covers firmware vulnerabilities and design/guide safety defects:
    report privately through GitHub's vulnerability reporting, what to expect,
    and the control system's security model (no authentication on the tether
    link, open video streams; keep the tether a direct cable). Linked from the
    README, CONTRIBUTING and the new-issue page.
    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
2026-10-25 Tail cone v2: compensator nipple you can reach; O-ring instead of a tie
    The 102 nipple sat under the spigot lip, 10 mm down: the finger cot was very
    hard to fit and impossible to tie. It now stands clear of the lip with its
    tip 2.5 mm below the rim, with a groove under the barb for a 5 x 1.5 mm
    O-ring that clamps the cot. The vent runs down the nipple and out of the
    cone's side at 45 degrees, clear of the gland. Interference, fastener and
    print checks unchanged.
    The compensator section figure is now drawn from the part geometry
    (guide/comp_fig.py, run by the figures step); the unused, out-of-date
    compensator_cutaway.png is removed. Guide 7.3, picture page, shopping list.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
    [102_tail_cone_comp.stl, BOM_hardware.csv, BOM_printed_parts.csv, TinkerSub_KB-1_Core.3mf, TinkerSub_KB-1_assembly_mesh.3mf]
2026-10-26 Guide 4.1 "Everything to buy" + Parts_to_buy.csv; correct the O-ring sizes
    A page before the prices listing every bought part for one ROV with its total
    quantity and exact size (Source/assembly/purchases.py). Screw, nut, washer and
    insert counts are derived from assembly/fasteners.py, and the insert totals
    are asserted against the Appendix B chart when the guide builds.
    O-ring sizes measured from the grooves; the original flange script had the
    dash numbers wrong: hull radial AS568-238 (was -240), rear cap face -237
    (was -239), dome face -240; pod caps 72 x 2.5 (was 74 x 2.5); light ring
    30 x 1.5 (was 31 x 1.5). M16 gland range 5-10 mm; slim Cat6 tether.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
    [BOM_hardware.csv, Parts_to_buy.csv]
2026-10-26 606 junction deck spans both stations; 3D viewer with electronics and cables
    The deck hung off the rear station alone (2 screws in one row, 86 mm
    overhang) and flexed. It now runs forward over both stations and screws to
    each with 2 x M3 x 10, into the inserts both station tops already carried
    (no longer listed as unused). 104 x 218 mm, so it prints on its own Frame
    plate (5); belly pan and cowl plates move to 6 and 7-9. Fastener table,
    shopping list, purchase list, label position and guide text updated;
    interference and fastener checks clean (166 screws).
    New guide/viewer_scene.py (scenes step) writes the interactive viewer's
    data: every part, the sled electronics and harness moved into th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
    [606_rov_junction_deck.step, 606_rov_junction_deck.stl, BOM_hardware.csv, BOM_printed_parts.csv, Parts_to_buy.csv, TinkerSub_KB-1_Frame.3mf, TinkerSub_KB-1_assembly_mesh.3mf]
2026-10-26 Guide: remove repetition, improve flow, one shopping list, Appendix C
    86 -> 75 pages. One shopping list with exact sizes, prices and sources
    (assembly/purchases.py; Parts_to_buy.csv carries prices, BOM_hardware.csv
    removed, fasteners.py shopping-list rows and their check removed since the
    list counts screws straight from the joints). 9.1 becomes a reference-number
    table; print settings move to section 5; repeated insert steps, notes and the
    thumbnail page go; template choices in one table; the rear cap gland table
    moves into 10.3. Appendix B picture pages become a two-per-page visual
    reference without step text. All "printed before <date>" notes move from the
    steps to the new Appendix C (wit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
    [BOM_hardware.csv, BOM_printed_parts.csv, Parts_to_buy.csv]
2026-10-26 Guide 9.6: Pico and Pi Zero pin maps, one-line-per-connection pin table
    Pin drawings for the Pico and the Pi Zero 2W and Pin_connections.csv, all
    from one list (PINS in elec_drawings.py) checked against the drawings.
    R1/R2 ground on Pico pin 18, R4 on AGND (pin 33).
    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
    [Pin_connections.csv, Wire_list.csv]
2026-10-27 Guide: ARM harness and servo power drawing before 9.7
    Shows R_EN + L_EN joined per IBT_2, the six-into-one ARM splice to Pico
    terminal 20 with R1 to 18, and the servos on U9B with C2 and their signal
    wires from terminals 21/22. Drawn in elec_drawings.py.
    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
2026-10-29 Daisy-chain ARM, VCC and GND across the six IBT_2 boards
    R_EN + L_EN solder-bridged on each header; ARM, VCC and GND hop board
    to board (T1 T4 T2 T5 T3 T6), one wire each to Pico pins 20, 36 and 13.
    RPWM/LPWM unchanged. Drawings, pin table, wire list, 9.7 text updated.
    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
    [Parts_to_buy.csv, Pin_connections.csv, Wire_list.csv]
2026-10-30 Rear caps 202 and 302: printed gland and vent threads
    ISO internal thread cutter (rov_parts.thread_cutter) replaces the tap
    drills: 202 gets 2x M16x1.5, 2x M12x1.5 and the M10x1.0 vent; 302 the
    M16x1.5 gland and M10x1.0 vent. Guide 10.3 / 11 / tools and Appendix C.
    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
    [202_rov_endcap_rear_5hole.stl, 302_rov_pod_endcap_3in_rear.stl, BOM_printed_parts.csv, TinkerSub_KB-1_Core.3mf, TinkerSub_KB-1_Reprint_2026-10-20.3mf]
2026-11-03 Pod rear cap 302: face O-ring groove (80 x 2.5) inside the bolt circle
    The rear cap failed a pressure test on its two radial O-rings alone. Face
    groove on the flange side: ID 81.0, 3.4 wide, 1.85 deep. Shopping list,
    guide 11, pack doc and Appendix C updated.
    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
    [302_rov_pod_endcap_3in_rear.stl, BOM_printed_parts.csv, Parts_to_buy.csv, TinkerSub_KB-1_Core.3mf, TinkerSub_KB-1_Reprint_2026-10-20.3mf]
2026-11-03 Topside controller is a Raspberry Pi 4
    Replace laptop references in the README, firmware README, bridge setup,
    guide source and bug report form; add Firmware/topside/SETUP.md.
    Claude-Session: https://claude.ai/code/session_01TschJaB7WsxKnSFEbMdHmH
    [build_guide_final.py]
